wickerwaka/nuBoard/docs/m68000-hardware-2026-09-18.md

# MC68000P12 bring-up, 2026-09-18

The user confirmed that nuBoard was reconnected with the MC68000P12
daughterboard attached. MCU preflight reported selector raw=1 (exclusive 5 V),
VCCB off, and both FPGA rails off. No MCU firmware or fx68k source was changed.
CPU clock for physical tests: 5 MHz, with continuous clock while armed.

## Initial image and gates

Runtime core `nuBoard-68000-v1`, core build 1, mailbox ABI 1.0.
Bitstream SHA-256:
`80b5dc0b1a50b0998bc69e8ea404a60aa7a7c1e0b05145d346246428ca63249d`.
Configuration passed streamed size/SHA-256, CDONE, heartbeat, and identity.

1. FPGA-only test attempt failed in the host transport after TAS passed.
   The MOVEM trace read ended at an exact USB packet boundary; TinyUSB's
   terminating zero-length packet was incorrectly treated as an error by the
   next host read. Shutdown acknowledgement then saw an older queued response.
   The failed receipt remains `build/validation/m68000/board-model-2026-09-18.json`.
   VCCB was never enabled during this attempt. A bounded drain of queued replies
   followed by one explicit POWER_OFF confirmed VCCB and both FPGA rails off.
2. The generic host reader now skips USB zero-length transfer boundaries under
   an absolute read deadline, without retrying commands. Three new tests cover
   exact-size transfers, split frames, and an endless-empty-transfer deadline.
   All 16 host unit tests pass. The repeated FPGA-only TAS/MOVEM/MOVEQ tests
   passed: 68/762/52 transfers, with complete traces exactly matching Verilator.
   Receipt: `build/validation/m68000/board-model-zlp-fixed-2026-09-18.json`.
3. Paired physical MC68000P12/fx68k MOVEQ passed both programs and matched all 52
   functional bus transfers. Timing differs and is not claimed cycle-exact.
   Receipt: `build/validation/m68000/board-paired-moveq-2026-09-18.json`.
4. The next paired batch stopped at TAS before attempting MOVEM. Both CPUs
   reported the test's pass marker, but capture lengths were 68 versus 69.
   The extra socket record was a write to address 0, data 0, FC=0, at timestamp
   zero (end tick 28), before the reset-vector reads. All subsequent 68
   functional records match. This is a **failed capture comparison**, not a
   passing differential test and not evidence of a TAS implementation bug.
   Receipt: `build/validation/m68000/board-paired-bus-2026-09-18.json`.
   VCCB and both FPGA rails were confirmed off afterward.

## Reset-release capture correction

`m68000_lane_tb.sv` holds invalid reset-time strobes low when the lane starts,
with nonzero vector RAM. It failed against build 1: the responder accepted a
transaction and could overwrite the vector. The corrected responder requires
two consecutive synchronized idle samples before acknowledging or capturing
its first transaction. Normal TAS handling is unchanged after qualification.

The new test passes and verifies that vector RAM stays intact and the first
real read is captured exactly once. Logs:

- `build/fpga/m68000/lane-reset-before.log` (failed as expected)
- `build/fpga/m68000/lane-reset-after.log` (pass)
- `build/validation/m68000/reset-qualified-regressions.log` (8 passes)

All 60 Musashi simulator outcomes, counts, signatures, and captured traces are
unchanged (56 passes; ABCD/SBCD/DIVS/DIVU still fail). All 1,000 MOVE.q vectors
pass. Core build 2 identifies the reset-qualification change. Build 1's image
and build receipt are preserved in `build/fpga/m68000/qualified-build1/`.

## Build 2 physical verification

Routed image SHA-256:
`9ae525acd25950172487084f881aac10a394f10015cea398294ddddb053bb574`.
All 153 package assignments and twelve setup/hold relationships pass. At
50 MHz, setup slack is +0.949 ns and hold slack is +0.116 ns. Resource use is
26,199 logic elements and 411/1056 memory blocks. These gates do not qualify
the external socket's electrical timing.

Preflight again confirmed exclusive 5 V selection and all rails off. After
configuration, the MCU reported core build 2 and the expected image digest.
The paired TAS/MOVEM/MOVEQ tests all passed, with respectively 68/762/52
functional transfers matching exactly and complete traces. The false reset
record is absent. All 882 transfers have timing differences; cycle accuracy
is not established. The report records divider=5 and wait_ticks=8.

Receipt:
`build/validation/m68000/board-paired-reset-qualified-2026-09-18.json`.
No transport or cleanup errors occurred, and a separate GET_STATE confirmed
VCCB and both FPGA rails off afterward.

The first 100 decoded SingleStepTests MOVE.q vectors then passed on both lanes:
zero skips, all 12,200 functional bus transfers matching, and all architectural
checks passing independently against the fixture. Checks cover D0..D7,
A0..A6, USP, SSP, SR, PC, and fixture RAM. Final prefetch and source-suite
timing are not checked. Timing differs for all 12,200 captured transfers.

Receipt:
`build/validation/m68000/board-paired-moveq-vectors-2026-09-18.json`.
The decoded vector file SHA-256 is
`39ffa468138c19e7cd02a916a9203c8efd2a323d5b132d1c1101e9fb140e769f`.
The run completed without transport or cleanup errors; VCCB and both FPGA
rails were independently confirmed off afterward.

## Targeted DIVU disagreement

The existing failing Musashi DIVU program was run once in paired mode. Both
CPUs emitted the failure marker: status `0x002a`, model_result=2,
socket_result=2. Neither timed out nor overflowed. Each completed 4,982
transfers, with the same full-run fingerprint (`2727533410`). The first 2,048
captured functional transfers match exactly. Because the test failed, the
runner did not replay additional windows: `trace_complete=false`. Equal
fingerprints do not establish complete trace equality.

Receipt: `build/validation/m68000/board-paired-divu-2026-09-18.json`.
This is a failed test on both implementations, not an fx68k-only failure or a
passing validation result. The cause of the suite disagreement remains open;
the physical terminal flag values were not captured. No further physical
tests were attempted. The run had no transport/cleanup errors, and final
GET_STATE confirmed phase=0, VCCB off, 3.3 V off, and 1.2 V off.

The versionable [hardware receipt](../validation/m68000/hardware-2026-09-18.json)
contains report hashes, build/source provenance, compact outcomes, and the
final power state. Raw trace reports remain under `build/validation/m68000/`.
