wickerwaka/nuBoard/docs/hardware_rev2.md

[x] Replace buffers with non-bushold versions.
[x] Remove small VIAs
[x] Add holes to make it easier to remove daughter boards.
[x] Rotate DC jack
Add regulator?
[x] Hyperram
