wickerwaka/nuBoard/hardware/main-board/notes/pin-assignment.md

# nuBoard T120F484 pin assignment

**Historical assignment:** the PSRAM allocation below was superseded by the
matched [HyperRAM replacement](hyperram.md). Use `../fpga_pin_map.csv`
for current memory and displaced daughter-interface pins. The original routing metrics below do not
describe the HyperRAM replacement.

Generated by `scripts/nuboard_pin_assign.py` from the geometry in
`nuBoard.kicad_pcb` and `t120f484.csv`. Regenerate rather than edit by hand.

## Why these balls

Each signal's destination is taken from the board itself: the
FPGA-side pad of the buffer's 22R series pack for data bits, buffer
pin 2 for `_DIR`, and the pull-up end of the already-routed `_OE`
trace for `_OE`. Balls are then handed to bundles as contiguous arcs
around the die, and matched within each arc in order, so nets leave
the package in the same sequence as their destinations.

Banks that carry LVDS pairs are capped at **14 GPIO** each (Trion rule). On this package those are the top banks
`BANK2A`-`2F` (`GPIOT_*`) and the bottom banks `BANK4A`-`4F`
(`GPIOB_*`); the left and right banks carry no pairs and are
uncapped. The cap counts every GPIO in the bank, so held pins
(configuration, JTAG, the dedicated clock input) come off the
budget before the optimiser sees it.

`BANK3E` (74 balls, the right flank) is excluded: it is the DDR bank
and `VCCIO_DDR` is unconnected, so it cannot be a 3.3 V I/O bank.
R0/R1/R2 are therefore fed from the top-right and bottom-right
corners. Those DDR balls carry no nets and no vias, so the copper
beneath them is an open channel on the inner signal layers.

## Result

| metric | before | after |
|---|---|---|
| crossings between nets outside the package | 303 | 0 |
| ... of those, inside a single bundle | 165 | 0 |
| signals on rings 0-1 | 59 | 94 |
| signals on ring 5 or deeper | 41 | 1 |
| mean ball-to-destination | 26.63 mm | 25.09 mm |
| total | 3860.9 mm | 3637.8 mm |

Ring histogram after: `{"0": 53, "1": 41, "2": 26, "3": 17, "4": 7, "5": 1}`

| bundle | n | mean before | mean after |
|---|---|---|---|
| L0 | 10 | 29.05 mm | 28.95 mm |
| L1 | 10 | 21.79 mm | 20.66 mm |
| L2 | 10 | 23.74 mm | 21.71 mm |
| T2 | 10 | 27.3 mm | 25.07 mm |
| T1 | 10 | 25.26 mm | 22.34 mm |
| T0 | 10 | 32.0 mm | 29.32 mm |
| R2 | 10 | 30.7 mm | 27.8 mm |
| R1 | 10 | 22.35 mm | 18.6 mm |
| R0 | 10 | 28.16 mm | 27.25 mm |
| B2 | 10 | 32.34 mm | 31.26 mm |
| B1 | 10 | 21.65 mm | 20.93 mm |
| B0 | 10 | 21.32 mm | 21.16 mm |
| PSRAM | 6 | 10.57 mm | 10.53 mm |
| XY | 9 | 27.0 mm | 26.61 mm |
| LCLK | 2 | 34.05 mm | 30.8 mm |
| TCLK | 2 | 34.92 mm | 34.63 mm |
| BCLK | 2 | 23.19 mm | 23.15 mm |
| RCLK | 2 | 33.87 mm | 32.09 mm |
| DUT | 2 | 72.87 mm | 71.65 mm |

## Bank occupancy

Cap on LVDS banks: 14 GPIO. `held` are pins this run may not move.

| bank | LVDS | cap | held | assigned | free |
|---|---|---|---|---|---|
| `BANK1A` | — | 9 | 9 | 0 | 0 **(full)** |
| `BANK1B` | — | 12 | 2 | 3 | 7 |
| `BANK1C` | — | 16 | 0 | 10 | 6 |
| `BANK1D` | — | 15 | 0 | 4 | 11 |
| `BANK1E` | — | 3 | 0 | 1 | 2 |
| `BANK1F` | — | 11 | 0 | 6 | 5 |
| `BANK1G` | — | 7 | 4 | 2 | 1 |
| `BANK2A` | yes | 14 | 0 | 14 | 0 **(full)** |
| `BANK2B` | yes | 14 | 0 | 8 | 6 |
| `BANK2C` | yes | 14 | 0 | 5 | 9 |
| `BANK2D` | yes | 12 | 0 | 5 | 7 |
| `BANK2E` | yes | 14 | 0 | 9 | 5 |
| `BANK2F` | yes | 14 | 0 | 7 | 7 |
| `BANK3D` | — | 16 | 1 | 15 | 0 **(full)** |
| `BANK4A` | yes | 8 | 0 | 6 | 2 |
| `BANK4B` | yes | 14 | 0 | 9 | 5 |
| `BANK4C` | yes | 14 | 0 | 8 | 6 |
| `BANK4D` | yes | 10 | 0 | 8 | 2 |
| `BANK4E` | yes | 14 | 0 | 10 | 4 |
| `BANK4F` | yes | 12 | 0 | 12 | 0 **(full)** |
| `BR` | — | 3 | 0 | 0 | 3 |
| `TR` | — | 4 | 1 | 3 | 0 **(full)** |

## Assignment

### L0

| signal | ball | Efinix GPIO | bank | ring | mm | was |
|---|---|---|---|---|---|---|
| `F_L0_DIR` | **E3** | GPIOL_160_PLLIN1 | BANK1G | 2 | 31.1 | E1 |
| `~{F_L0_OE}` | **E4** | GPIOL_164_PLLIN0 | BANK1G | 3 | 28.9 | C2 |
| `F_L07` | **D1** | GPIOT_TXP01 | BANK2A | 0 | 27.8 | C3 |
| `F_L06` | **D2** | GPIOT_TXP02 | BANK2A | 1 | 28.8 | D2 |
| `F_L05` | **C1** | GPIOT_TXP04 | BANK2A | 0 | 28.0 | D1 |
| `F_L04` | **C2** | GPIOT_TXN02 | BANK2A | 1 | 28.9 | B5 |
| `F_L03` | **B1** | GPIOT_TXN04 | BANK2A | 0 | 28.2 | A3 |
| `F_L02` | **B2** | GPIOT_TXN05 | BANK2A | 1 | 29.1 | B2 |
| `F_L01` | **A2** | GPIOT_TXP05 | BANK2A | 0 | 28.8 | B1 |
| `F_L00` | **A3** | GPIOT_TXN06 | BANK2A | 0 | 29.8 | C4 |

### L1

| signal | ball | Efinix GPIO | bank | ring | mm | was |
|---|---|---|---|---|---|---|
| `~{F_L1_OE}` | **L1** | GPIOL_68_CLK2 | BANK1C | 0 | 20.2 | H6 |
| `F_L1_DIR` | **L2** | GPIOL_69_CLK3 | BANK1C | 1 | 23.8 | H4 |
| `F_L17` | **L3** | GPIOL_73_CLK7 | BANK1D | 2 | 21.0 | G5 |
| `F_L16` | **K1** | GPIOL_87 | BANK1D | 0 | 19.4 | G2 |
| `F_L15` | **K2** | GPIOL_89 | BANK1D | 1 | 20.3 | G3 |
| `F_L14` | **J1** | GPIOL_119 | BANK1F | 0 | 19.4 | G4 |
| `F_L13` | **J2** | GPIOL_117 | BANK1E | 1 | 20.3 | G1 |
| `F_L12` | **J3** | GPIOL_91 | BANK1D | 2 | 21.2 | G6 |
| `F_L11` | **H1** | GPIOL_133 | BANK1F | 0 | 19.6 | H1 |
| `F_L10` | **H3** | GPIOL_131 | BANK1F | 2 | 21.3 | H3 |

### L2

| signal | ball | Efinix GPIO | bank | ring | mm | was |
|---|---|---|---|---|---|---|
| `~{F_L2_OE}` | **R3** | GPIOL_17_EXTFB0 | BANK1B | 2 | 23.8 | M1 |
| `F_L2_DIR` | **R2** | GPIOL_15_PLLIN0 | BANK1B | 1 | 25.4 | M4 |
| `F_L27` | **R1** | GPIOL_49 | BANK1C | 0 | 20.5 | L3 |
| `F_L26` | **P3** | GPIOL_51 | BANK1C | 2 | 22.1 | L6 |
| `F_L25` | **P2** | GPIOL_50 | BANK1C | 1 | 21.2 | L5 |
| `F_L24` | **P1** | GPIOL_52 | BANK1C | 0 | 20.3 | L7 |
| `F_L23` | **N2** | GPIOL_63_CTRL1 | BANK1C | 1 | 21.2 | L2 |
| `F_L22` | **N1** | GPIOL_62_CTRL0 | BANK1C | 0 | 20.3 | L1 |
| `F_L21` | **M3** | GPIOL_67_CLK1 | BANK1C | 2 | 21.9 | M3 |
| `F_L20` | **M1** | GPIOL_65_CTRL3 | BANK1C | 0 | 20.2 | M6 |

### T2

| signal | ball | Efinix GPIO | bank | ring | mm | was |
|---|---|---|---|---|---|---|
| `~{F_T2_OE}` | **C3** | GPIOT_TXP03 | BANK2A | 2 | 27.1 | E6 |
| `F_T27` | **C4** | GPIOT_TXN03 | BANK2A | 2 | 25.4 | F6 |
| `F_T26` | **B5** | GPIOT_TXN07 | BANK2A | 1 | 24.8 | C6 |
| `F_T2_DIR` | **A4** | GPIOT_TXP06 | BANK2A | 0 | 28.1 | C7 |
| `F_T25` | **A5** | GPIOT_TXP07 | BANK2A | 0 | 23.9 | A8 |
| `F_T24` | **C6** | GPIOT_TXP10 | BANK2B | 2 | 25.4 | F8 |
| `F_T23` | **B6** | GPIOT_TXN12 | BANK2B | 1 | 24.5 | H7 |
| `F_T22` | **A6** | GPIOT_TXP12 | BANK2B | 0 | 23.5 | B7 |
| `F_T21` | **B7** | GPIOT_TXN14 | BANK2B | 1 | 24.4 | F7 |
| `F_T20` | **A7** | GPIOT_TXP14 | BANK2B | 0 | 23.4 | B6 |

### T1

| signal | ball | Efinix GPIO | bank | ring | mm | was |
|---|---|---|---|---|---|---|
| `~{F_T1_OE}` | **C7** | GPIOT_TXN10 | BANK2B | 2 | 23.7 | D9 |
| `F_T1_DIR` | **A8** | GPIOT_TXN18 | BANK2B | 0 | 24.8 | G8 |
| `F_T17` | **B8** | GPIOT_TXP18 | BANK2B | 1 | 21.9 | G9 |
| `F_T16` | **A9** | GPIOT_TXP23 | BANK2C | 0 | 21.1 | E9 |
| `F_T15` | **B9** | GPIOT_TXN23 | BANK2C | 1 | 21.9 | H8 |
| `F_T14` | **A10** | GPIOT_TXP25 | BANK2C | 0 | 21.1 | G10 |
| `F_T13` | **B10** | GPIOT_TXN25 | BANK2C | 1 | 22.0 | B10 |
| `F_T12` | **D10** | GPIOT_TXP24 | BANK2C | 3 | 23.6 | E10 |
| `F_T11` | **A11** | GPIOT_RXP01 | BANK2D | 0 | 21.2 | B9 |
| `F_T10` | **B11** | GPIOT_RXN01 | BANK2D | 1 | 22.1 | H9 |

### T0

| signal | ball | Efinix GPIO | bank | ring | mm | was |
|---|---|---|---|---|---|---|
| `F_T0_DIR` | **A12** | GPIOT_RXP11 | BANK2E | 0 | 30.4 | B11 |
| `~{F_T0_OE}` | **C12** | GPIOT_RXN04 | BANK2D | 2 | 28.8 | D11 |
| `F_T07` | **A13** | GPIOT_RXN11 | BANK2E | 0 | 27.9 | C11 |
| `F_T06` | **B13** | GPIOT_RXP13 | BANK2E | 1 | 28.9 | G11 |
| `F_T05` | **C13** | GPIOT_RXN13 | BANK2E | 2 | 29.8 | E11 |
| `F_T04` | **A14** | GPIOT_RXN15 | BANK2E | 0 | 28.4 | A11 |
| `F_T03` | **B14** | GPIOT_RXP15 | BANK2E | 1 | 29.4 | E12 |
| `F_T02` | **D14** | GPIOT_RXN19_CLKN1 | BANK2E | 3 | 30.9 | G12 |
| `F_T01` | **A15** | GPIOT_RXN18_EXTFB1 | BANK2E | 0 | 28.9 | C12 |
| `F_T00` | **B15** | GPIOT_RXP18_EXTFB1 | BANK2E | 1 | 29.9 | H11 |

### R2

| signal | ball | Efinix GPIO | bank | ring | mm | was |
|---|---|---|---|---|---|---|
| `~{F_R2_OE}` | **C15** | GPIOT_RXN23 | BANK2F | 2 | 31.8 | G13 |
| `F_R27` | **D15** | GPIOT_RXN22 | BANK2F | 3 | 30.0 | H13 |
| `F_R26` | **A16** | GPIOT_RXP20 | BANK2F | 0 | 27.5 | A12 |
| `F_R25` | **B16** | GPIOT_RXN20 | BANK2F | 1 | 27.6 | D14 |
| `F_R24` | **A17** | GPIOT_RXP21 | BANK2F | 0 | 26.2 | A15 |
| `F_R2_DIR` | **C16** | GPIOT_RXP23 | BANK2F | 2 | 32.8 | A13 |
| `F_R23` | **B17** | GPIOT_RXN21 | BANK2F | 1 | 26.4 | H14 |
| `F_R22` | **C18** | GPIOR_166_PLLIN0 | TR | 2 | 26.0 | A14 |
| `F_R21` | **D18** | GPIOR_168_PLLIN2 | TR | 3 | 26.1 | E13 |
| `F_R20` | **A19** | GPIOR_169_MREFCLK | TR | 0 | 23.7 | C13 |

### R1

| signal | ball | Efinix GPIO | bank | ring | mm | was |
|---|---|---|---|---|---|---|
| `~{F_R1_OE}` | **B19** | GPIOR_172_CTRL13 | BANK3D | 1 | 20.8 | B16 |
| `F_R1_DIR` | **C19** | GPIOR_171_CTRL14 | BANK3D | 2 | 23.5 | B17 |
| `F_R17` | **D19** | GPIOR_173_CTRL12 | BANK3D | 3 | 19.6 | A17 |
| `F_R16` | **B20** | GPIOR_175_CLK14 | BANK3D | 1 | 18.5 | A16 |
| `F_R15` | **A21** | GPIOR_176_CLK13 | BANK3D | 0 | 17.7 | F17 |
| `F_R14` | **B21** | GPIOR_177_CLK12 | BANK3D | 1 | 17.7 | E16 |
| `F_R13` | **B22** | GPIOR_180_CLK9 | BANK3D | 0 | 16.9 | H16 |
| `F_R12` | **C22** | GPIOR_182_CTRL11 | BANK3D | 0 | 16.9 | F15 |
| `F_R11` | **C21** | GPIOR_178_CLK11 | BANK3D | 1 | 17.7 | C15 |
| `F_R10` | **D22** | GPIOR_183_CTRL10 | BANK3D | 0 | 16.9 | D15 |

### R0

| signal | ball | Efinix GPIO | bank | ring | mm | was |
|---|---|---|---|---|---|---|
| `F_R0_DIR` | **V15** | GPIOB_RXP29_CLKP2 | BANK4A | 4 | 29.1 | AA13 |
| `~{F_R0_OE}` | **W15** | GPIOB_RXN29_CLKN2 | BANK4A | 3 | 25.9 | U13 |
| `F_R07` | **AA15** | GPIOB_RXN20 | BANK4A | 1 | 25.4 | AB15 |
| `F_R06` | **AB15** | GPIOB_RXP14 | BANK4B | 0 | 25.3 | T13 |
| `F_R05` | **U14** | GPIOB_RXN18_EXTFB1 | BANK4B | 5 | 28.1 | AB13 |
| `F_R04` | **V14** | GPIOB_RXP19_CLKP1 | BANK4B | 4 | 28.0 | W14 |
| `F_R03` | **W14** | GPIOB_RXN19_CLKN1 | BANK4B | 3 | 27.8 | U14 |
| `F_R02` | **Y14** | GPIOB_RXP16 | BANK4B | 2 | 27.7 | Y13 |
| `F_R01` | **AB14** | GPIOB_RXN14 | BANK4B | 0 | 27.1 | R13 |
| `F_R00` | **AB13** | GPIOB_RXP10 | BANK4B | 0 | 28.1 | AB14 |

### B2

| signal | ball | Efinix GPIO | bank | ring | mm | was |
|---|---|---|---|---|---|---|
| `~{F_B2_OE}` | **Y13** | GPIOB_RXN16 | BANK4B | 2 | 33.1 | U10 |
| `F_B27` | **AA13** | GPIOB_RXN10 | BANK4B | 1 | 30.0 | AB10 |
| `F_B26` | **V12** | GPIOB_RXP08_EXTFB0 | BANK4C | 4 | 31.7 | W10 |
| `F_B25` | **W12** | GPIOB_RXN08_EXTFB0 | BANK4C | 3 | 30.8 | AB9 |
| `F_B24` | **AA12** | GPIOB_RXP05 | BANK4C | 1 | 29.4 | U9 |
| `F_B2_DIR` | **W11** | GPIOB_RXP03 | BANK4C | 3 | 35.9 | AA8 |
| `F_B23` | **AB12** | GPIOB_RXN05 | BANK4C | 0 | 28.5 | AB8 |
| `F_B22` | **R4** | GPIOL_19_PLLIN1 | BANK1B | 3 | 36.6 | AA10 |
| `F_B21` | **AA11** | GPIOB_RXN00 | BANK4C | 1 | 28.8 | V10 |
| `F_B20` | **AB11** | GPIOB_RXP00 | BANK4C | 0 | 27.9 | AA9 |

### B1

| signal | ball | Efinix GPIO | bank | ring | mm | was |
|---|---|---|---|---|---|---|
| `~{F_B1_OE}` | **V8** | GPIOB_TXN17_CDI10 | BANK4E | 4 | 24.2 | AA6 |
| `F_B1_DIR` | **V7** | GPIOB_TXP15_CDI15 | BANK4E | 4 | 26.6 | Y7 |
| `F_B17` | **W8** | GPIOB_TXP17_CDI11 | BANK4E | 3 | 21.5 | V7 |
| `F_B16` | **AA8** | GPIOB_TXN22 | BANK4D | 1 | 19.8 | AB6 |
| `F_B15` | **Y7** | GPIOB_TXN13_CDI18 | BANK4E | 2 | 20.6 | Y6 |
| `F_B14` | **AA7** | GPIOB_TXN16_CDI12 | BANK4E | 1 | 19.7 | W9 |
| `F_B13` | **AB7** | GPIOB_TXP16_CDI13 | BANK4E | 0 | 18.7 | U8 |
| `F_B12` | **Y6** | GPIOB_TXP13_CDI19 | BANK4E | 2 | 20.3 | V8 |
| `F_B11` | **AA6** | GPIOB_TXN14_CDI16 | BANK4E | 1 | 19.4 | AA7 |
| `F_B10` | **AB6** | GPIOB_TXP14_CDI17 | BANK4E | 0 | 18.4 | U7 |

### B0

| signal | ball | Efinix GPIO | bank | ring | mm | was |
|---|---|---|---|---|---|---|
| `F_B0_DIR` | **Y4** | GPIOB_TXP03_CDI31 | BANK4F | 2 | 23.8 | W4 |
| `~{F_B0_OE}` | **AB4** | GPIOB_TXN07_CDI22 | BANK4F | 0 | 19.4 | W3 |
| `F_B07` | **W4** | GPIOB_TXN03_CDI30 | BANK4F | 3 | 21.8 | AB2 |
| `F_B06` | **AB3** | GPIOB_TXP07_CDI23 | BANK4F | 0 | 19.6 | AA1 |
| `F_B05` | **AB2** | GPIOB_TXP06_CDI25 | BANK4F | 0 | 19.4 | W2 |
| `F_B04` | **AA2** | GPIOB_TXN06_CDI24 | BANK4F | 1 | 20.4 | Y4 |
| `F_B03` | **AA1** | GPIOB_TXP05_CDI27 | BANK4F | 0 | 20.2 | AB5 |
| `F_B02` | **Y1** | GPIOB_TXN05_CDI26 | BANK4F | 0 | 21.2 | AB4 |
| `F_B01` | **W3** | GPIOB_TXN04_CDI28 | BANK4F | 2 | 22.9 | AA2 |
| `F_B00` | **W2** | GPIOB_TXP04_CDI29 | BANK4F | 1 | 22.8 | Y1 |

### PSRAM

| signal | ball | Efinix GPIO | bank | ring | mm | was |
|---|---|---|---|---|---|---|
| `PSRAM_SI` | **E22** | GPIOR_185_CTRL8 | BANK3D | 0 | 11.2 | AB17 |
| `PSRAM_SCLK` | **E21** | GPIOR_181_CLK8 | BANK3D | 1 | 11.4 | R15 |
| `PSRAM_SIO3` | **E19** | GPIOR_170_CTRL15 | BANK3D | 3 | 12.0 | T15 |
| `PSRAM_SIO2` | **AB17** | GPIOB_RXN28_EXTFB2 | BANK4A | 0 | 9.5 | AA16 |
| `PSRAM_SO` | **AB16** | GPIOB_RXP28_EXTFB2 | BANK4A | 0 | 9.8 | W15 |
| `~{PSRAM_CE}` | **AA16** | GPIOB_RXP20 | BANK4A | 1 | 9.3 | AA15 |

### XY

| signal | ball | Efinix GPIO | bank | ring | mm | was |
|---|---|---|---|---|---|---|
| `F_RX` | **V11** | GPIOB_RXN03 | BANK4C | 4 | 29.4 | R10 |
| `F_RY` | **V10** | GPIOB_TXN25 | BANK4D | 4 | 29.1 | V11 |
| `F_TX` | **W10** | GPIOB_TXP25 | BANK4D | 3 | 28.1 | AB12 |
| `F_TY` | **AA10** | GPIOB_TXN26 | BANK4D | 1 | 26.4 | U12 |
| `F_BX` | **AB10** | GPIOB_TXP26 | BANK4D | 0 | 25.4 | W12 |
| `F_BY` | **W9** | GPIOB_TXN19 | BANK4E | 3 | 27.4 | T12 |
| `F_LX` | **AA9** | GPIOB_TXN24 | BANK4D | 1 | 25.7 | AB11 |
| `~{F_XY_OE}` | **AB9** | GPIOB_TXP24 | BANK4D | 0 | 22.9 | AA11 |
| `F_LY` | **AB8** | GPIOB_TXP22 | BANK4D | 0 | 25.2 | T10 |

### LCLK

| signal | ball | Efinix GPIO | bank | ring | mm | was |
|---|---|---|---|---|---|---|
| `F_LCLK_EN` | **G1** | GPIOL_136 | BANK1F | 0 | 31.0 | J8 |
| `F_LCLK` | **G2** | GPIOL_142 | BANK1F | 1 | 30.6 | J2 |

### TCLK

| signal | ball | Efinix GPIO | bank | ring | mm | was |
|---|---|---|---|---|---|---|
| `F_TCLK_EN` | **C11** | GPIOT_RXP04 | BANK2D | 2 | 34.8 | A10 |
| `F_TCLK` | **D11** | GPIOT_RXN02 | BANK2D | 3 | 34.4 | F10 |

### BCLK

| signal | ball | Efinix GPIO | bank | ring | mm | was |
|---|---|---|---|---|---|---|
| `F_BCLK_EN` | **AB5** | GPIOB_TXN08_CDI20 | BANK4F | 0 | 23.5 | AB3 |
| `F_BCLK` | **AA5** | GPIOB_TXP08_CDI21 | BANK4F | 1 | 22.8 | AA5 |

### RCLK

| signal | ball | Efinix GPIO | bank | ring | mm | was |
|---|---|---|---|---|---|---|
| `R_RCLK_EN` | **D21** | GPIOR_184_CTRL9 | BANK3D | 1 | 32.2 | F16 |
| `F_RCLK` | **D20** | GPIOR_179_CLK10 | BANK3D | 2 | 32.0 | G17 |

### DUT

| signal | ball | Efinix GPIO | bank | ring | mm | was |
|---|---|---|---|---|---|---|
| `DUT_ISOLATE` | **G3** | GPIOL_141 | BANK1F | 2 | 72.4 | E4 |
| `DUT_CROWBAR` | **E1** | GPIOT_TXN01 | BANK2A | 0 | 70.9 | E5 |

## Downstream

`nuBoard/fpga_pin_map.csv` carries the same table as
`Signal,GPIO,Ball,Bank,Group` for the Efinity flow. Note that
`scripts/gen_isf.py` currently targets **T20F256** (the T20_Rig
board) and does not read this file; pointing it at T120F484 is a
separate job.
