wickerwaka/nuBoard/hardware/daughter-template/meta/info.html

# nuDaughter Mezzanine Board

Starting point for a daughterboard that plugs into the nuBoard 68020 FPGA host board. It gives you a 100 × 100 mm outline and the full 4 × 34 mezzanine interface, already placed, footprinted and labelled. Everything inside the connector ring is yours.

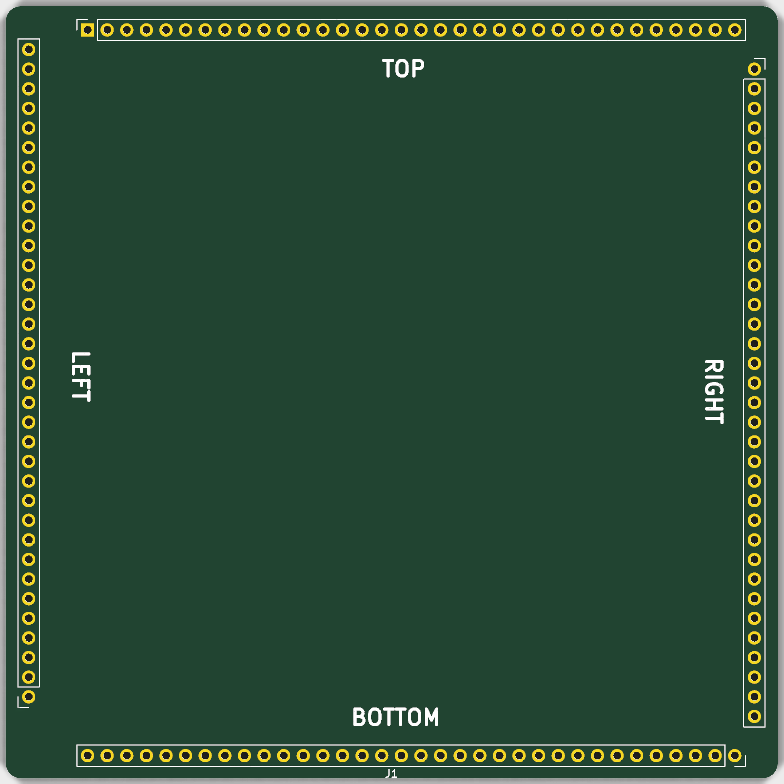
[picture p1: hardware/v35s/meta/brd.png]


### What's in the template

- J1 — nuMezzanine_4x34, a 5-unit symbol covering all 136 through-hole pins, mapped to the nuMezzanine_4x34_P2.54mm footprint (2.54 mm pitch, pins numbered 1–136 clockwise from the top-left).
- Board outline on Edge.Cuts, and TOP / BOTTOM / LEFT / RIGHT silkscreen so the board orientation is unambiguous when it is mated to the host.
- All 116 signal pins broken out to net labels in the schematic, ready to wire.
- A 2-layer FR4 stackup and the net class / DRC settings used by the nuBoard family.

### Pin naming

Each of the four connector rows carries 34 pins: 29 signals, three grounds, a supply pin, and an end pin used for voltage selection or ground. Signal labels are <side><bank><bit>, where side is T, B, L or R — for example T00…T07, T10…T17, T20…T27. Each side also has a dedicated clock TCLK/BCLK/LCLK/RCLK and four bidirectional sideband signals TX0–TX3 (and the equivalents on the other sides).

### Standalone

The mezzanine symbol and footprint ship with the template as a project-local nuBoard library (nuBoard.kicad_sym and nuBoard.pretty, registered through the project's own sym-lib-table and fp-lib-table via ${KIPRJMOD}). Nothing outside the new project directory is required.

### Expect ERC violations until you wire something up

Out of the box the schematic reports isolated pin label for every mezzanine signal, because each label reaches only J1 so far. Those clear as you connect the signals you actually use; delete the labels you don't.
