wickerwaka/nuBoard/hardware/68030/meta/info.html

# Motorola MC68030RC25B

CPGA128, 5 V, fully routed two-layer nuBoard daughter board. Supports 8/16/32-bit ports, burst reads and bus takeover.

Open 68030.kicad_pro. Read design-notes.md and bank-modes.md before use. Direct TTL/CMOS and bus-keeper margins are not guaranteed; physical bench and timing qualification remain pending.
