wickerwaka/nuBoard/hardware/main-board/t120f484.csv

Bank Number | Pin Names | Configuration Functions | DDR Interface | LVDS TX/RX Pairs | DDIO | Clock Region | FBGA484
BANK1A | CDONE | CDONE |  |  |  |  | V5
BANK1A | CRESET_N | CRESET_N |  |  |  |  | V4
BANK1A | GPIOL_00_SS_N | SS_N |  |  | Yes | L0 | V3
BANK1A | GPIOL_01_CCK | CCK |  |  | Yes | L0 | W1
BANK1A | GPIOL_04_CSI | CSI |  |  | Yes | L0 | V6
BANK1A | GPIOL_05_CSO | CSO |  |  | Yes | L0 | U5
BANK1A | GPIOL_08_CDI0 | CDI0 |  |  | Yes | L0 | V2
BANK1A | GPIOL_09_CDI1 | CDI1 |  |  | Yes | L0 | V1
BANK1A | GPIOL_11_CBUS0 | CBUS0 |  |  | Yes | L0 | U4
BANK1A | GPIOL_12_CBUS1 | CBUS1 |  |  | Yes | L0, L1 | U6
BANK1A | GPIOL_13_CBUS2 | CBUS2 |  |  | Yes | L1 | T4
BANK1A | TCK | TCK |  |  |  |  | T1
BANK1A | TDI | TDI |  |  |  |  | U2
BANK1A | TDO | TDO |  |  |  |  | T3
BANK1A | TMS | TMS |  |  |  |  | U1
BANK1B | GPIOL_14_CDI2 | CDI2 |  |  | Yes | L1 | T6
BANK1B | GPIOL_15_PLLIN0 |  |  |  | Yes | L1 | R2
BANK1B | GPIOL_16_CDI3 | CDI3 |  |  | Yes | L1 | R8
BANK1B | GPIOL_17_EXTFB0 |  |  |  | Yes | L1 | R3
BANK1B | GPIOL_18_CDI4 | CDI4 |  |  | Yes | L1 | R7
BANK1B | GPIOL_19_PLLIN1 |  |  |  | Yes | L1 | R4
BANK1B | GPIOL_20_CDI5 | CDI5 |  |  | Yes | L1 | R6
BANK1B | GPIOL_22_CDI6 | CDI6 |  |  | Yes | L1 | P8
BANK1B | GPIOL_24_CDI7 | CDI7 |  |  | Yes | L1 | P7
BANK1B | GPIOL_36 |  |  |  | Yes | L2 | P4
BANK1B | GPIOL_40 |  |  |  | Yes | L2 | N7
BANK1B | GPIOL_45 |  |  |  | Yes | L2 | P6
BANK1C | GPIOL_47 |  |  |  | Yes | L2 | P5
BANK1C | GPIOL_49 |  |  |  | Yes | L2 | R1
BANK1C | GPIOL_50 |  |  |  | Yes | L2 | P2
BANK1C | GPIOL_51 |  |  |  | Yes | L2 | P3
BANK1C | GPIOL_52 |  |  |  | Yes | L2 | P1
BANK1C | GPIOL_53 |  |  |  | Yes | L2 | N5
BANK1C | GPIOL_56 |  |  |  | Yes | L3 | N4
BANK1C | GPIOL_58 |  |  |  | Yes | L3 | M7
BANK1C | GPIOL_62_CTRL0 |  |  |  | Yes | L3 | N1
BANK1C | GPIOL_63_CTRL1 |  |  |  | Yes | L3 | N2
BANK1C | GPIOL_64_CTRL2 |  |  |  | Yes | L3 | M4
BANK1C | GPIOL_65_CTRL3 |  |  |  | Yes | L3 | M1
BANK1C | GPIOL_66_CLK0 |  |  |  | Yes | L3 | M6
BANK1C | GPIOL_67_CLK1 |  |  |  | Yes | L3 | M3
BANK1C | GPIOL_68_CLK2 |  |  |  | Yes | L3 | L1
BANK1C | GPIOL_69_CLK3 |  |  |  | Yes | L3 | L2
BANK1D | GPIOL_70_CLK4 |  |  |  | Yes | L3 | L7
BANK1D | GPIOL_71_CLK5 |  |  |  | Yes | L3 | L5
BANK1D | GPIOL_72_CLK6 |  |  |  | Yes | L3 | L6
BANK1D | GPIOL_73_CLK7 |  |  |  | Yes | L3 | L3
BANK1D | GPIOL_74_CTRL4 |  |  |  | Yes | L3 | L4
BANK1D | GPIOL_75_CTRL5 |  |  |  | Yes | L3 | K8
BANK1D | GPIOL_76_CTRL6 |  |  |  | Yes | L3 | K7
BANK1D | GPIOL_77_CTRL7 |  |  |  | Yes | L4 | K6
BANK1D | GPIOL_79 |  |  |  | Yes | L4 | K4
BANK1D | GPIOL_81 |  |  |  | Yes | L4 | K5
BANK1D | GPIOL_85 |  |  |  | Yes | L4 | J5
BANK1D | GPIOL_87 |  |  |  | Yes | L4 | K1
BANK1D | GPIOL_88 |  |  |  | Yes | L4 | J4
BANK1D | GPIOL_89 |  |  |  | Yes | L4 | K2
BANK1D | GPIOL_91 |  |  |  | Yes | L4 | J3
BANK1E | GPIOL_115 |  |  |  | Yes | L5 | J7
BANK1E | GPIOL_116 |  |  |  | Yes | L5 | J8
BANK1E | GPIOL_117 |  |  |  | Yes | L5 | J2
BANK1F | GPIOL_119 |  |  |  | Yes | L5 | J1
BANK1F | GPIOL_121 |  |  |  | Yes | L6 | H4
BANK1F | GPIOL_123 |  |  |  | Yes | L6 | H6
BANK1F | GPIOL_131 |  |  |  | Yes | L6 | H3
BANK1F | GPIOL_133 |  |  |  | Yes | L6 | H1
BANK1F | GPIOL_134 |  |  |  | Yes | L6 | G6
BANK1F | GPIOL_136 |  |  |  | Yes | L6 | G1
BANK1F | GPIOL_138 |  |  |  | Yes | L6 | G4
BANK1F | GPIOL_141 |  |  |  | Yes | L6 | G3
BANK1F | GPIOL_142 |  |  |  | Yes | L6 | G2
BANK1F | GPIOL_147 |  |  |  | Yes | L7 | G5
BANK1G | GPIOL_150_NSTATUS | NSTATUS |  |  | Yes | L7 | F5
BANK1G | GPIOL_151_TEST_N | TEST_N |  |  | Yes | L7 | F1
BANK1G | GPIOL_156_CBSEL0 | CBSEL0 |  |  | Yes | L7 | F4
BANK1G | GPIOL_157_CBSEL1 | CBSEL1 |  |  | Yes | L7 | E2
BANK1G | GPIOL_160_PLLIN1 |  |  |  | Yes | L7 | E3
BANK1G | GPIOL_162_EXTFB |  |  |  | Yes | L7 | E5
BANK1G | GPIOL_164_PLLIN0 |  |  |  | Yes | L7 | E4
BANK2A | GPIOT_TXN01 |  |  | GPIOT_TX01 |  | T | E1
BANK2A | GPIOT_TXN02 |  |  | GPIOT_TX02 |  | T | C2
BANK2A | GPIOT_TXN03 |  |  | GPIOT_TX03 |  | T | C4
BANK2A | GPIOT_TXN04 |  |  | GPIOT_TX04 |  | T | B1
BANK2A | GPIOT_TXN05 |  |  | GPIOT_TX05 |  | T | B2
BANK2A | GPIOT_TXN06 |  |  | GPIOT_TX06 |  | T | A3
BANK2A | GPIOT_TXN07 |  |  | GPIOT_TX07 |  | T | B5
BANK2A | GPIOT_TXP01 |  |  | GPIOT_TX01 |  | T | D1
BANK2A | GPIOT_TXP02 |  |  | GPIOT_TX02 |  | T | D2
BANK2A | GPIOT_TXP03 |  |  | GPIOT_TX03 |  | T | C3
BANK2A | GPIOT_TXP04 |  |  | GPIOT_TX04 |  | T | C1
BANK2A | GPIOT_TXP05 |  |  | GPIOT_TX05 |  | T | A2
BANK2A | GPIOT_TXP06 |  |  | GPIOT_TX06 |  | T | A4
BANK2A | GPIOT_TXP07 |  |  | GPIOT_TX07 |  | T | A5
BANK2A | REF_RES_2A |  |  |  |  |  | C5
BANK2B | GPIOT_TXN10 |  |  | GPIOT_TX10 |  | T | C7
BANK2B | GPIOT_TXN11 |  |  | GPIOT_TX11 |  | T | E6
BANK2B | GPIOT_TXN12 |  |  | GPIOT_TX12 |  | T | B6
BANK2B | GPIOT_TXN13 |  |  | GPIOT_TX13 |  | T | F7
BANK2B | GPIOT_TXN14 |  |  | GPIOT_TX14 |  | T | B7
BANK2B | GPIOT_TXN15 |  |  | GPIOT_TX15 |  | T | H7
BANK2B | GPIOT_TXN16 |  |  | GPIOT_TX16 |  | T | F8
BANK2B | GPIOT_TXN18 |  |  | GPIOT_TX18 |  | T | A8
BANK2B | GPIOT_TXP10 |  |  | GPIOT_TX10 |  | T | C6
BANK2B | GPIOT_TXP11 |  |  | GPIOT_TX11 |  | T | F6
BANK2B | GPIOT_TXP12 |  |  | GPIOT_TX12 |  | T | A6
BANK2B | GPIOT_TXP13 |  |  | GPIOT_TX13 |  | T | E7
BANK2B | GPIOT_TXP14 |  |  | GPIOT_TX14 |  | T | A7
BANK2B | GPIOT_TXP15 |  |  | GPIOT_TX15 |  | T | G7
BANK2B | GPIOT_TXP16 |  |  | GPIOT_TX16 |  | T | E8
BANK2B | GPIOT_TXP18 |  |  | GPIOT_TX18 |  | T | B8
BANK2B | REF_RES_2B |  |  |  |  |  | D8
BANK2C | GPIOT_TXN20 |  |  | GPIOT_TX20 |  | T | G8
BANK2C | GPIOT_TXN21 |  |  | GPIOT_TX21 |  | T | D9
BANK2C | GPIOT_TXN22 |  |  | GPIOT_TX22 |  | T | H9
BANK2C | GPIOT_TXN23 |  |  | GPIOT_TX23 |  | T | B9
BANK2C | GPIOT_TXN24 |  |  | GPIOT_TX24 |  | T | E10
BANK2C | GPIOT_TXN25 |  |  | GPIOT_TX25 |  | T | B10
BANK2C | GPIOT_TXN26 |  |  | GPIOT_TX26 |  | T | G10
BANK2C | GPIOT_TXP20 |  |  | GPIOT_TX20 |  | T | H8
BANK2C | GPIOT_TXP21 |  |  | GPIOT_TX21 |  | T | E9
BANK2C | GPIOT_TXP22 |  |  | GPIOT_TX22 |  | T | G9
BANK2C | GPIOT_TXP23 |  |  | GPIOT_TX23 |  | T | A9
BANK2C | GPIOT_TXP24 |  |  | GPIOT_TX24 |  | T | D10
BANK2C | GPIOT_TXP25 |  |  | GPIOT_TX25 |  | T | A10
BANK2C | GPIOT_TXP26 |  |  | GPIOT_TX26 |  | T | F10
BANK2C | REF_RES_2C |  |  |  |  |  | C10
BANK2D | GPIOT_RXN01 |  |  | GPIOT_RX01 |  | T | B11
BANK2D | GPIOT_RXN02 |  |  | GPIOT_RX02 |  | T | D11
BANK2D | GPIOT_RXN03 |  |  | GPIOT_RX03 |  | T | H11
BANK2D | GPIOT_RXN04 |  |  | GPIOT_RX04 |  | T | C12
BANK2D | GPIOT_RXN08_EXTFB0 |  |  | GPIOT_RX08 |  | T | G12
BANK2D | GPIOT_RXN09_CLKN0 |  |  | GPIOT_RX09 |  | T | E12
BANK2D | GPIOT_RXP01 |  |  | GPIOT_RX01 |  | T | A11
BANK2D | GPIOT_RXP02 |  |  | GPIOT_RX02 |  | T | E11
BANK2D | GPIOT_RXP03 |  |  | GPIOT_RX03 |  | T | G11
BANK2D | GPIOT_RXP04 |  |  | GPIOT_RX04 |  | T | C11
BANK2D | GPIOT_RXP08_EXTFB0 |  |  | GPIOT_RX08 |  | T | H12
BANK2D | GPIOT_RXP09_CLKP0 |  |  | GPIOT_RX09 |  | T | F12
BANK2E | GPIOT_RXN11 |  |  | GPIOT_RX11 |  | T | A13
BANK2E | GPIOT_RXN12 |  |  | GPIOT_RX12 |  | T | G13
BANK2E | GPIOT_RXN13 |  |  | GPIOT_RX13 |  | T | C13
BANK2E | GPIOT_RXN14 |  |  | GPIOT_RX14 |  | T | E13
BANK2E | GPIOT_RXN15 |  |  | GPIOT_RX15 |  | T | A14
BANK2E | GPIOT_RXN16 |  |  | GPIOT_RX16 |  | T | H14
BANK2E | GPIOT_RXN18_EXTFB1 |  |  | GPIOT_RX18 |  | T | A15
BANK2E | GPIOT_RXN19_CLKN1 |  |  | GPIOT_RX19 |  | T | D14
BANK2E | GPIOT_RXP11 |  |  | GPIOT_RX11 |  | T | A12
BANK2E | GPIOT_RXP12 |  |  | GPIOT_RX12 |  | T | H13
BANK2E | GPIOT_RXP13 |  |  | GPIOT_RX13 |  | T | B13
BANK2E | GPIOT_RXP14 |  |  | GPIOT_RX14 |  | T | F13
BANK2E | GPIOT_RXP15 |  |  | GPIOT_RX15 |  | T | B14
BANK2E | GPIOT_RXP16 |  |  | GPIOT_RX16 |  | T | G14
BANK2E | GPIOT_RXP18_EXTFB1 |  |  | GPIOT_RX18 |  | T | B15
BANK2E | GPIOT_RXP19_CLKP1 |  |  | GPIOT_RX19 |  | T | E14
BANK2F | GPIOT_RXN20 |  |  | GPIOT_RX20 |  | T | B16
BANK2F | GPIOT_RXN21 |  |  | GPIOT_RX21 |  | T | B17
BANK2F | GPIOT_RXN22 |  |  | GPIOT_RX22 |  | T | D15
BANK2F | GPIOT_RXN23 |  |  | GPIOT_RX23 |  | T | C15
BANK2F | GPIOT_RXN24 |  |  | GPIOT_RX24 |  | T | F15
BANK2F | GPIOT_RXN27 |  |  | GPIOT_RX27 |  | T | H16
BANK2F | GPIOT_RXN28_EXTFB2 |  |  | GPIOT_RX28 |  | T | E16
BANK2F | GPIOT_RXN29_CLKN2 |  |  | GPIOT_RX29 |  | T | F17
BANK2F | GPIOT_RXP20 |  |  | GPIOT_RX20 |  | T | A16
BANK2F | GPIOT_RXP21 |  |  | GPIOT_RX21 |  | T | A17
BANK2F | GPIOT_RXP22 |  |  | GPIOT_RX22 |  | T | E15
BANK2F | GPIOT_RXP23 |  |  | GPIOT_RX23 |  | T | C16
BANK2F | GPIOT_RXP24 |  |  | GPIOT_RX24 |  | T | G15
BANK2F | GPIOT_RXP27 |  |  | GPIOT_RX27 |  | T | J16
BANK2F | GPIOT_RXP28_EXTFB2 |  |  | GPIOT_RX28 |  | T | F16
BANK2F | GPIOT_RXP29_CLKP2 |  |  | GPIOT_RX29 |  | T | G17
BANK3D | GPIOR_170_CTRL15 |  |  |  | Yes | R4 | E19
BANK3D | GPIOR_171_CTRL14 |  |  |  | Yes | R4 | C19
BANK3D | GPIOR_172_CTRL13 |  |  |  | Yes | R4 | B19
BANK3D | GPIOR_173_CTRL12 |  |  |  | Yes | R4 | D19
BANK3D | GPIOR_174_CLK15 |  |  |  | Yes | R4 | A20
BANK3D | GPIOR_175_CLK14 |  |  |  | Yes | R4 | B20
BANK3D | GPIOR_176_CLK13 |  |  |  | Yes | R4 | A21
BANK3D | GPIOR_177_CLK12 |  |  |  | Yes | R4 | B21
BANK3D | GPIOR_178_CLK11 |  |  |  | Yes | R4 | C21
BANK3D | GPIOR_179_CLK10 |  |  |  | Yes | R4 | D20
BANK3D | GPIOR_180_CLK9 |  |  |  | Yes | R4 | B22
BANK3D | GPIOR_181_CLK8 |  |  |  | Yes | R4 | E21
BANK3D | GPIOR_182_CTRL11 |  |  |  | Yes | R4 | C22
BANK3D | GPIOR_183_CTRL10 |  |  |  | Yes | R4 | D22
BANK3D | GPIOR_184_CTRL9 |  |  |  | Yes | R4 | D21
BANK3D | GPIOR_185_CTRL8 |  |  |  | Yes | R4 | E22
BANK3E | DDR_A[0] |  | DDR_A[0] |  |  |  | M18
BANK3E | DDR_A[1] |  | DDR_A[1] |  |  |  | L17
BANK3E | DDR_A[10] |  | DDR_A[10] |  |  |  | P22
BANK3E | DDR_A[11] |  | DDR_A[11] |  |  |  | R22
BANK3E | DDR_A[12] |  | DDR_A[12] |  |  |  | T20
BANK3E | DDR_A[13] |  | DDR_A[13] |  |  |  | T21
BANK3E | DDR_A[14] |  | DDR_A[14] |  |  |  | R18
BANK3E | DDR_A[15] |  | DDR_A[15] |  |  |  | U17
BANK3E | DDR_A[2] |  | DDR_A[2] |  |  |  | N17
BANK3E | DDR_A[3] |  | DDR_A[3] |  |  |  | P20
BANK3E | DDR_A[4] |  | DDR_A[4] |  |  |  | N19
BANK3E | DDR_A[5] |  | DDR_A[5] |  |  |  | T19
BANK3E | DDR_A[6] |  | DDR_A[6] |  |  |  | M20
BANK3E | DDR_A[7] |  | DDR_A[7] |  |  |  | P17
BANK3E | DDR_A[8] |  | DDR_A[8] |  |  |  | P19
BANK3E | DDR_A[9] |  | DDR_A[9] |  |  |  | R20
BANK3E | DDR_BA[0] |  | DDR_BA[0] |  |  |  | V16
BANK3E | DDR_BA[1] |  | DDR_BA[1] |  |  |  | T17
BANK3E | DDR_BA[2] |  | DDR_BA[2] |  |  |  | W16
BANK3E | DDR_CAS_N |  | DDR_CAS_N |  |  |  | M16
BANK3E | DDR_CK |  | DDR_CK |  |  |  | N21
BANK3E | DDR_CK_N |  | DDR_CK_N |  |  |  | P21
BANK3E | DDR_CKE |  | DDR_CKE |  |  |  | L16
BANK3E | DDR_CS_N |  | DDR_CS_N |  |  |  | P16
BANK3E | DDR_DM[0] |  | DDR_DM[0] |  |  |  | K19
BANK3E | DDR_DM[1] |  | DDR_DM[1] |  |  |  | G22
BANK3E | DDR_DM[2] |  | DDR_DM[2] |  |  |  | V20
BANK3E | DDR_DM[3] |  | DDR_DM[3] |  |  |  | Y19
BANK3E | DDR_DQ[0] |  | DDR_DQ[0] |  |  |  | K21
BANK3E | DDR_DQ[1] |  | DDR_DQ[1] |  |  |  | M22
BANK3E | DDR_DQ[10] |  | DDR_DQ[10] |  |  |  | H20
BANK3E | DDR_DQ[11] |  | DDR_DQ[11] |  |  |  | H19
BANK3E | DDR_DQ[12] |  | DDR_DQ[12] |  |  |  | G19
BANK3E | DDR_DQ[13] |  | DDR_DQ[13] |  |  |  | H21
BANK3E | DDR_DQ[14] |  | DDR_DQ[14] |  |  |  | F20
BANK3E | DDR_DQ[15] |  | DDR_DQ[15] |  |  |  | F18
BANK3E | DDR_DQ[16] |  | DDR_DQ[16] |  |  |  | U19
BANK3E | DDR_DQ[17] |  | DDR_DQ[17] |  |  |  | T22
BANK3E | DDR_DQ[18] |  | DDR_DQ[18] |  |  |  | W21
BANK3E | DDR_DQ[19] |  | DDR_DQ[19] |  |  |  | U21
BANK3E | DDR_DQ[2] |  | DDR_DQ[2] |  |  |  | K20
BANK3E | DDR_DQ[20] |  | DDR_DQ[20] |  |  |  | U18
BANK3E | DDR_DQ[21] |  | DDR_DQ[21] |  |  |  | W20
BANK3E | DDR_DQ[22] |  | DDR_DQ[22] |  |  |  | W19
BANK3E | DDR_DQ[23] |  | DDR_DQ[23] |  |  |  | V18
BANK3E | DDR_DQ[24] |  | DDR_DQ[24] |  |  |  | Y21
BANK3E | DDR_DQ[25] |  | DDR_DQ[25] |  |  |  | Y22
BANK3E | DDR_DQ[26] |  | DDR_DQ[26] |  |  |  | AA20
BANK3E | DDR_DQ[27] |  | DDR_DQ[27] |  |  |  | AA22
BANK3E | DDR_DQ[28] |  | DDR_DQ[28] |  |  |  | AB19
BANK3E | DDR_DQ[29] |  | DDR_DQ[29] |  |  |  | Y18
BANK3E | DDR_DQ[3] |  | DDR_DQ[3] |  |  |  | L20
BANK3E | DDR_DQ[30] |  | DDR_DQ[30] |  |  |  | AB18
BANK3E | DDR_DQ[31] |  | DDR_DQ[31] |  |  |  | AA18
BANK3E | DDR_DQ[4] |  | DDR_DQ[4] |  |  |  | L19
BANK3E | DDR_DQ[5] |  | DDR_DQ[5] |  |  |  | J18
BANK3E | DDR_DQ[6] |  | DDR_DQ[6] |  |  |  | L18
BANK3E | DDR_DQ[7] |  | DDR_DQ[7] |  |  |  | H18
BANK3E | DDR_DQ[8] |  | DDR_DQ[8] |  |  |  | J22
BANK3E | DDR_DQ[9] |  | DDR_DQ[9] |  |  |  | K22
BANK3E | DDR_DQS[0] |  | DDR_DQS[0] |  |  |  | L21
BANK3E | DDR_DQS[1] |  | DDR_DQS[1] |  |  |  | G20
BANK3E | DDR_DQS[2] |  | DDR_DQS[2] |  |  |  | V22
BANK3E | DDR_DQS[3] |  | DDR_DQS[3] |  |  |  | AB21
BANK3E | DDR_DQS_N[0] |  | DDR_DQS_N[0] |  |  |  | L22
BANK3E | DDR_DQS_N[1] |  | DDR_DQS_N[1] |  |  |  | G21
BANK3E | DDR_DQS_N[2] |  | DDR_DQS_N[2] |  |  |  | W22
BANK3E | DDR_DQS_N[3] |  | DDR_DQS_N[3] |  |  |  | AB20
BANK3E | DDR_ODT |  | DDR_ODT |  |  |  | W17
BANK3E | DDR_RAS_N |  | DDR_RAS_N |  |  |  | R16
BANK3E | DDR_RST_N |  | DDR_RST_N |  |  |  | Y17
BANK3E | DDR_VREF |  | DDR_VREF |  |  |  | K17
BANK3E | DDR_WE_N |  | DDR_WE_N |  |  |  | U16
BANK3E | DDR_ZQ |  | DDR_ZQ |  |  |  | P18
BANK4A | GPIOB_RXN20 |  |  | GPIOB_RX20 |  | B | AA15
BANK4A | GPIOB_RXN21 |  |  | GPIOB_RX21 |  | B | R15
BANK4A | GPIOB_RXN28_EXTFB2 |  |  | GPIOB_RX28 |  | B | AB17
BANK4A | GPIOB_RXN29_CLKN2 |  |  | GPIOB_RX29 |  | B | W15
BANK4A | GPIOB_RXP20 |  |  | GPIOB_RX20 |  | B | AA16
BANK4A | GPIOB_RXP21 |  |  | GPIOB_RX21 |  | B | T15
BANK4A | GPIOB_RXP28_EXTFB2 |  |  | GPIOB_RX28 |  | B | AB16
BANK4A | GPIOB_RXP29_CLKP2 |  |  | GPIOB_RX29 |  | B | V15
BANK4B | GPIOB_RXN10 |  |  | GPIOB_RX10 |  | B | AA13
BANK4B | GPIOB_RXN12 |  |  | GPIOB_RX12 |  | B | U13
BANK4B | GPIOB_RXN14 |  |  | GPIOB_RX14 |  | B | AB14
BANK4B | GPIOB_RXN15 |  |  | GPIOB_RX15 |  | B | R13
BANK4B | GPIOB_RXN16 |  |  | GPIOB_RX16 |  | B | Y13
BANK4B | GPIOB_RXN18_EXTFB1 |  |  | GPIOB_RX18 |  | B | U14
BANK4B | GPIOB_RXN19_CLKN1 |  |  | GPIOB_RX19 |  | B | W14
BANK4B | GPIOB_RXP10 |  |  | GPIOB_RX10 |  | B | AB13
BANK4B | GPIOB_RXP12 |  |  | GPIOB_RX12 |  | B | T13
BANK4B | GPIOB_RXP14 |  |  | GPIOB_RX14 |  | B | AB15
BANK4B | GPIOB_RXP15 |  |  | GPIOB_RX15 |  | B | R14
BANK4B | GPIOB_RXP16 |  |  | GPIOB_RX16 |  | B | Y14
BANK4B | GPIOB_RXP18_EXTFB1 |  |  | GPIOB_RX18 |  | B | T14
BANK4B | GPIOB_RXP19_CLKP1 |  |  | GPIOB_RX19 |  | B | V14
BANK4C | GPIOB_RXN00 |  |  | GPIOB_RX00 |  | B | AA11
BANK4C | GPIOB_RXN01 |  |  | GPIOB_RX01 |  | B | R10
BANK4C | GPIOB_RXN03 |  |  | GPIOB_RX03 |  | B | V11
BANK4C | GPIOB_RXN05 |  |  | GPIOB_RX05 |  | B | AB12
BANK4C | GPIOB_RXN06 |  |  | GPIOB_RX06 |  | B | U12
BANK4C | GPIOB_RXN08_EXTFB0 |  |  | GPIOB_RX08 |  | B | W12
BANK4C | GPIOB_RXN09_CLKN0 |  |  | GPIOB_RX09 |  | B | T12
BANK4C | GPIOB_RXP00 |  |  | GPIOB_RX00 |  | B | AB11
BANK4C | GPIOB_RXP01 |  |  | GPIOB_RX01 |  | B | T10
BANK4C | GPIOB_RXP03 |  |  | GPIOB_RX03 |  | B | W11
BANK4C | GPIOB_RXP05 |  |  | GPIOB_RX05 |  | B | AA12
BANK4C | GPIOB_RXP06 |  |  | GPIOB_RX06 |  | B | U11
BANK4C | GPIOB_RXP08_EXTFB0 |  |  | GPIOB_RX08 |  | B | V12
BANK4C | GPIOB_RXP09_CLKP0 |  | DDR (PHY) Reference Clock | GPIOB_RX09 |  | B | R12
BANK4D | GPIOB_TXN22 |  |  | GPIOB_TX22 |  | B | AA8
BANK4D | GPIOB_TXN23 |  |  | GPIOB_TX23 |  | B | U10
BANK4D | GPIOB_TXN24 |  |  | GPIOB_TX24 |  | B | AA9
BANK4D | GPIOB_TXN25 |  |  | GPIOB_TX25 |  | B | V10
BANK4D | GPIOB_TXN26 |  |  | GPIOB_TX26 |  | B | AA10
BANK4D | GPIOB_TXP22 |  |  | GPIOB_TX22 |  | B | AB8
BANK4D | GPIOB_TXP23 |  |  | GPIOB_TX23 |  | B | U9
BANK4D | GPIOB_TXP24 |  |  | GPIOB_TX24 |  | B | AB9
BANK4D | GPIOB_TXP25 |  |  | GPIOB_TX25 |  | B | W10
BANK4D | GPIOB_TXP26 |  |  | GPIOB_TX26 |  | B | AB10
BANK4D | REF_RES_4D |  |  |  |  |  | Y10
BANK4E | GPIOB_TXN13_CDI18 | CDI18 |  | GPIOB_TX13 |  | B | Y7
BANK4E | GPIOB_TXN14_CDI16 | CDI16 |  | GPIOB_TX14 |  | B | AA6
BANK4E | GPIOB_TXN15_CDI14 | CDI14 |  | GPIOB_TX15 |  | B | U7
BANK4E | GPIOB_TXN16_CDI12 | CDI12 |  | GPIOB_TX16 |  | B | AA7
BANK4E | GPIOB_TXN17_CDI10 | CDI10 |  | GPIOB_TX17 |  | B | V8
BANK4E | GPIOB_TXN18_CDI8 | CDI8 |  | GPIOB_TX18 |  | B | U8
BANK4E | GPIOB_TXN19 |  |  | GPIOB_TX19 |  | B | W9
BANK4E | GPIOB_TXP13_CDI19 | CDI19 |  | GPIOB_TX13 |  | B | Y6
BANK4E | GPIOB_TXP14_CDI17 | CDI17 |  | GPIOB_TX14 |  | B | AB6
BANK4E | GPIOB_TXP15_CDI15 | CDI15 |  | GPIOB_TX15 |  | B | V7
BANK4E | GPIOB_TXP16_CDI13 | CDI13 |  | GPIOB_TX16 |  | B | AB7
BANK4E | GPIOB_TXP17_CDI11 | CDI11 |  | GPIOB_TX17 |  | B | W8
BANK4E | GPIOB_TXP18_CDI9 | CDI9 |  | GPIOB_TX18 |  | B | T8
BANK4E | GPIOB_TXP19 |  |  | GPIOB_TX19 |  | B | V9
BANK4E | REF_RES_4E |  |  |  |  |  | W6
BANK4F | GPIOB_TXN03_CDI30 | CDI30 |  | GPIOB_TX03 |  | B | W4
BANK4F | GPIOB_TXN04_CDI28 | CDI28 |  | GPIOB_TX04 |  | B | W3
BANK4F | GPIOB_TXN05_CDI26 | CDI26 |  | GPIOB_TX05 |  | B | Y1
BANK4F | GPIOB_TXN06_CDI24 | CDI24 |  | GPIOB_TX06 |  | B | AA2
BANK4F | GPIOB_TXN07_CDI22 | CDI22 |  | GPIOB_TX07 |  | B | AB4
BANK4F | GPIOB_TXN08_CDI20 | CDI20 |  | GPIOB_TX08 |  | B | AB5
BANK4F | GPIOB_TXP03_CDI31 | CDI31 |  | GPIOB_TX03 |  | B | Y4
BANK4F | GPIOB_TXP04_CDI29 | CDI29 |  | GPIOB_TX04 |  | B | W2
BANK4F | GPIOB_TXP05_CDI27 | CDI27 |  | GPIOB_TX05 |  | B | AA1
BANK4F | GPIOB_TXP06_CDI25 | CDI25 |  | GPIOB_TX06 |  | B | AB2
BANK4F | GPIOB_TXP07_CDI23 | CDI23 |  | GPIOB_TX07 |  | B | AB3
BANK4F | GPIOB_TXP08_CDI21 | CDI21 |  | GPIOB_TX08 |  | B | AA5
BANK4F | REF_RES_4F |  |  |  |  |  | AA3
BR | GPIOR_186_PLLIN0 |  | DDR (PHY) Reference Clock |  | Yes | R0 | M15
BR | GPIOR_187_PLLIN1 |  |  |  | Yes | R0 | L15
BR | GPIOR_188_PLLIN2 |  |  |  | Yes | R0 | K15
TR | GPIOR_166_PLLIN0 |  |  |  | Yes | R7 | C18
TR | GPIOR_167_PLLIN1 |  |  |  | Yes | R7 | A18
TR | GPIOR_168_PLLIN2 |  |  |  | Yes | R7 | D18
TR | GPIOR_169_MREFCLK |  |  |  | Yes | R7 | A19
- | VCC |  |  |  |  |  | H10
- | VCC |  |  |  |  |  | J11
- | VCC |  |  |  |  |  | J13
- | VCC |  |  |  |  |  | J15
- | VCC |  |  |  |  |  | J9
- | VCC |  |  |  |  |  | K10
- | VCC |  |  |  |  |  | K12
- | VCC |  |  |  |  |  | K14
- | VCC |  |  |  |  |  | L11
- | VCC |  |  |  |  |  | L13
- | VCC |  |  |  |  |  | L9
- | VCC |  |  |  |  |  | M10
- | VCC |  |  |  |  |  | M12
- | VCC |  |  |  |  |  | M14
- | VCC |  |  |  |  |  | M8
- | VCC |  |  |  |  |  | N11
- | VCC |  |  |  |  |  | N13
- | VCC |  |  |  |  |  | N9
- | VCC |  |  |  |  |  | P10
- | VCC |  |  |  |  |  | P12
- | VCC |  |  |  |  |  | P14
- | VCC |  |  |  |  |  | R11
- | VCCA_BL |  |  |  |  |  | W5
- | VCCA_BR |  |  |  |  |  | N15
- | VCCA_BR |  |  |  |  |  | P15
- | VCCA_TL |  |  |  |  |  | D5
- | VCCA_TR |  |  |  |  |  | D17
- | VCCA_TR |  |  |  |  |  | E17
- | VCCIO_DDR |  |  |  |  |  | AA17
- | VCCIO_DDR |  |  |  |  |  | AA19
- | VCCIO_DDR |  |  |  |  |  | AA21
- | VCCIO_DDR |  |  |  |  |  | F19
- | VCCIO_DDR |  |  |  |  |  | F21
- | VCCIO_DDR |  |  |  |  |  | G18
- | VCCIO_DDR |  |  |  |  |  | J17
- | VCCIO_DDR |  |  |  |  |  | J19
- | VCCIO_DDR |  |  |  |  |  | J21
- | VCCIO_DDR |  |  |  |  |  | M17
- | VCCIO_DDR |  |  |  |  |  | M19
- | VCCIO_DDR |  |  |  |  |  | M21
- | VCCIO_DDR |  |  |  |  |  | R17
- | VCCIO_DDR |  |  |  |  |  | R19
- | VCCIO_DDR |  |  |  |  |  | R21
- | VCCIO_DDR |  |  |  |  |  | V17
- | VCCIO_DDR |  |  |  |  |  | V19
- | VCCIO_DDR |  |  |  |  |  | V21
- | VCCIO1A |  |  |  |  |  | U3
- | VCCIO1B_1C |  |  |  |  |  | N3
- | VCCIO1B_1C |  |  |  |  |  | N6
- | VCCIO1B_1C |  |  |  |  |  | R5
- | VCCIO1D_1E |  |  |  |  |  | J6
- | VCCIO1D_1E |  |  |  |  |  | K3
- | VCCIO1F_1G |  |  |  |  |  | F2
- | VCCIO1F_1G |  |  |  |  |  | F3
- | VCCIO2A |  |  |  |  |  | B3
- | VCCIO2A |  |  |  |  |  | D3
- | VCCIO2B |  |  |  |  |  | C8
- | VCCIO2B |  |  |  |  |  | D6
- | VCCIO2C |  |  |  |  |  | C9
- | VCCIO2C |  |  |  |  |  | F9
- | VCCIO2D |  |  |  |  |  | D12
- | VCCIO2D |  |  |  |  |  | F11
- | VCCIO2E |  |  |  |  |  | C14
- | VCCIO2E |  |  |  |  |  | F14
- | VCCIO2F |  |  |  |  |  | C17
- | VCCIO2F |  |  |  |  |  | G16
- | VCCIO3D_TR_BR |  |  |  |  |  | B18
- | VCCIO3D_TR_BR |  |  |  |  |  | C20
- | VCCIO4A |  |  |  |  |  | U15
- | VCCIO4A |  |  |  |  |  | Y16
- | VCCIO4B |  |  |  |  |  | AA14
- | VCCIO4B |  |  |  |  |  | V13
- | VCCIO4C |  |  |  |  |  | T11
- | VCCIO4C |  |  |  |  |  | Y12
- | VCCIO4D |  |  |  |  |  | T9
- | VCCIO4D |  |  |  |  |  | Y9
- | VCCIO4E |  |  |  |  |  | R9
- | VCCIO4E |  |  |  |  |  | W7
- | VCCIO4F |  |  |  |  |  | AA4
- | VCCIO4F |  |  |  |  |  | Y3
- | GND |  |  |  |  |  | A1
- | GND |  |  |  |  |  | A22
- | GND |  |  |  |  |  | AB1
- | GND |  |  |  |  |  | AB22
- | GND |  |  |  |  |  | B12
- | GND |  |  |  |  |  | B4
- | GND |  |  |  |  |  | D13
- | GND |  |  |  |  |  | D16
- | GND |  |  |  |  |  | D4
- | GND |  |  |  |  |  | D7
- | GND |  |  |  |  |  | E18
- | GND |  |  |  |  |  | E20
- | GND |  |  |  |  |  | F22
- | GND |  |  |  |  |  | H15
- | GND |  |  |  |  |  | H17
- | GND |  |  |  |  |  | H2
- | GND |  |  |  |  |  | H22
- | GND |  |  |  |  |  | H5
- | GND |  |  |  |  |  | J10
- | GND |  |  |  |  |  | J12
- | GND |  |  |  |  |  | J14
- | GND |  |  |  |  |  | J20
- | GND |  |  |  |  |  | K11
- | GND |  |  |  |  |  | K13
- | GND |  |  |  |  |  | K16
- | GND |  |  |  |  |  | K18
- | GND |  |  |  |  |  | K9
- | GND |  |  |  |  |  | L10
- | GND |  |  |  |  |  | L12
- | GND |  |  |  |  |  | L14
- | GND |  |  |  |  |  | L8
- | GND |  |  |  |  |  | M11
- | GND |  |  |  |  |  | M13
- | GND |  |  |  |  |  | M2
- | GND |  |  |  |  |  | M5
- | GND |  |  |  |  |  | M9
- | GND |  |  |  |  |  | N10
- | GND |  |  |  |  |  | N12
- | GND |  |  |  |  |  | N14
- | GND |  |  |  |  |  | N16
- | GND |  |  |  |  |  | N18
- | GND |  |  |  |  |  | N20
- | GND |  |  |  |  |  | N22
- | GND |  |  |  |  |  | N8
- | GND |  |  |  |  |  | P11
- | GND |  |  |  |  |  | P13
- | GND |  |  |  |  |  | P9
- | GND |  |  |  |  |  | T16
- | GND |  |  |  |  |  | T18
- | GND |  |  |  |  |  | T2
- | GND |  |  |  |  |  | T5
- | GND |  |  |  |  |  | T7
- | GND |  |  |  |  |  | U20
- | GND |  |  |  |  |  | U22
- | GND |  |  |  |  |  | W13
- | GND |  |  |  |  |  | W18
- | GND |  |  |  |  |  | Y11
- | GND |  |  |  |  |  | Y15
- | GND |  |  |  |  |  | Y2
- | GND |  |  |  |  |  | Y20
- | GND |  |  |  |  |  | Y5
- | GND |  |  |  |  |  | Y8
