wickerwaka/nuBoard/hardware/main-board/fpga_pin_map.csv

Signal | GPIO | Ball | Bank | Group
F_L00 | GPIOT_TXN06 | A3 | BANK2A | L0
F_L01 | GPIOT_TXP05 | A2 | BANK2A | L0
F_L02 | GPIOT_TXN05 | B2 | BANK2A | L0
F_L03 | GPIOT_TXN04 | B1 | BANK2A | L0
F_L04 | GPIOT_TXN02 | C2 | BANK2A | L0
F_L05 | GPIOT_TXP04 | C1 | BANK2A | L0
F_L06 | GPIOT_TXP02 | D2 | BANK2A | L0
F_L07 | GPIOT_TXP01 | D1 | BANK2A | L0
F_L0_DIR | GPIOL_160_PLLIN1 | E3 | BANK1G | L0
~{F_L0_OE} | GPIOL_164_PLLIN0 | E4 | BANK1G | L0
F_L10 | GPIOL_123 | H6 | BANK1F | L1
F_L11 | GPIOL_121 | H4 | BANK1F | L1
F_L12 | GPIOL_115 | J7 | BANK1E | L1
F_L13 | GPIOL_85 | J5 | BANK1D | L1
F_L14 | GPIOL_88 | J4 | BANK1D | L1
F_L15 | GPIOL_81 | K5 | BANK1D | L1
F_L16 | GPIOL_79 | K4 | BANK1D | L1
F_L17 | GPIOL_72_CLK6 | L6 | BANK1D | L1
F_L1_DIR | GPIOL_71_CLK5 | L5 | BANK1D | L1
~{F_L1_OE} | GPIOL_74_CTRL4 | L4 | BANK1D | L1
F_L20 | GPIOL_56 | N4 | BANK1C | L2
F_L21 | GPIOL_64_CTRL2 | M4 | BANK1C | L2
F_L22 | GPIOL_62_CTRL0 | N1 | BANK1C | L2
F_L23 | GPIOL_63_CTRL1 | N2 | BANK1C | L2
F_L24 | GPIOL_52 | P1 | BANK1C | L2
F_L25 | GPIOL_50 | P2 | BANK1C | L2
F_L26 | GPIOL_51 | P3 | BANK1C | L2
F_L27 | GPIOL_49 | R1 | BANK1C | L2
F_L2_DIR | GPIOL_15_PLLIN0 | R2 | BANK1B | L2
~{F_L2_OE} | GPIOL_17_EXTFB0 | R3 | BANK1B | L2
F_T20 | GPIOT_TXP14 | A7 | BANK2B | T2
F_T21 | GPIOT_TXN14 | B7 | BANK2B | T2
F_T22 | GPIOT_TXP12 | A6 | BANK2B | T2
F_T23 | GPIOT_TXN12 | B6 | BANK2B | T2
F_T24 | GPIOT_TXP10 | C6 | BANK2B | T2
F_T25 | GPIOT_TXP07 | A5 | BANK2A | T2
F_T26 | GPIOT_TXN07 | B5 | BANK2A | T2
F_T27 | GPIOT_TXN03 | C4 | BANK2A | T2
F_T2_DIR | GPIOT_TXP06 | A4 | BANK2A | T2
~{F_T2_OE} | GPIOT_TXP03 | C3 | BANK2A | T2
F_T10 | GPIOT_RXN01 | B11 | BANK2D | T1
F_T11 | GPIOT_RXP01 | A11 | BANK2D | T1
F_T12 | GPIOT_TXP24 | D10 | BANK2C | T1
F_T13 | GPIOT_TXN25 | B10 | BANK2C | T1
F_T14 | GPIOT_TXP25 | A10 | BANK2C | T1
F_T15 | GPIOT_TXN23 | B9 | BANK2C | T1
F_T16 | GPIOT_TXP23 | A9 | BANK2C | T1
F_T17 | GPIOT_TXP18 | B8 | BANK2B | T1
F_T1_DIR | GPIOT_TXN18 | A8 | BANK2B | T1
~{F_T1_OE} | GPIOT_TXN10 | C7 | BANK2B | T1
F_T00 | GPIOT_RXP18_EXTFB1 | B15 | BANK2E | T0
F_T01 | GPIOT_RXN18_EXTFB1 | A15 | BANK2E | T0
F_T02 | GPIOT_RXN19_CLKN1 | D14 | BANK2E | T0
F_T03 | GPIOT_RXP15 | B14 | BANK2E | T0
F_T04 | GPIOT_RXN15 | A14 | BANK2E | T0
F_T05 | GPIOT_RXN13 | C13 | BANK2E | T0
F_T06 | GPIOT_RXP13 | B13 | BANK2E | T0
F_T07 | GPIOT_RXN11 | A13 | BANK2E | T0
F_T0_DIR | GPIOT_RXP11 | A12 | BANK2E | T0
~{F_T0_OE} | GPIOT_RXN04 | C12 | BANK2D | T0
F_R20 | GPIOR_168_PLLIN2 | D18 | TR | R2
F_R21 | GPIOR_166_PLLIN0 | C18 | TR | R2
F_R22 | GPIOR_169_MREFCLK | A19 | TR | R2
F_R23 | GPIOT_RXN22 | D15 | BANK2F | R2
F_R24 | GPIOT_RXP23 | C16 | BANK2F | R2
F_R25 | GPIOT_RXN23 | C15 | BANK2F | R2
F_R26 | GPIOT_RXN20 | B16 | BANK2F | R2
F_R27 | GPIOT_RXP21 | A17 | BANK2F | R2
F_R2_DIR | GPIOT_RXN21 | B17 | BANK2F | R2
~{F_R2_OE} | GPIOT_RXP20 | A16 | BANK2F | R2
F_R10 | GPIOR_183_CTRL10 | D22 | BANK3D | R1
F_R11 | GPIOR_173_CTRL12 | D19 | BANK3D | R1
F_R12 | GPIOR_182_CTRL11 | C22 | BANK3D | R1
F_R13 | GPIOR_178_CLK11 | C21 | BANK3D | R1
F_R14 | GPIOR_171_CTRL14 | C19 | BANK3D | R1
F_R15 | GPIOR_180_CLK9 | B22 | BANK3D | R1
F_R16 | GPIOR_177_CLK12 | B21 | BANK3D | R1
F_R17 | GPIOR_175_CLK14 | B20 | BANK3D | R1
F_R1_DIR | GPIOR_172_CTRL13 | B19 | BANK3D | R1
~{F_R1_OE} | GPIOR_176_CLK13 | A21 | BANK3D | R1
F_R00 | GPIOB_RXP10 | AB13 | BANK4B | R0
F_R01 | GPIOB_RXN14 | AB14 | BANK4B | R0
F_R02 | GPIOB_RXP14 | AB15 | BANK4B | R0
F_R03 | GPIOB_RXP16 | Y14 | BANK4B | R0
F_R04 | GPIOB_RXN19_CLKN1 | W14 | BANK4B | R0
F_R05 | GPIOB_RXP19_CLKP1 | V14 | BANK4B | R0
F_R06 | GPIOB_RXN18_EXTFB1 | U14 | BANK4B | R0
F_R07 | GPIOB_RXN20 | AA15 | BANK4A | R0
F_R0_DIR | GPIOB_RXP29_CLKP2 | V15 | BANK4A | R0
~{F_R0_OE} | GPIOB_RXN29_CLKN2 | W15 | BANK4A | R0
F_B20 | GPIOB_RXP00 | AB11 | BANK4C | B2
F_B21 | GPIOB_RXN00 | AA11 | BANK4C | B2
F_B22 | GPIOL_19_PLLIN1 | R4 | BANK1B | B2
F_B23 | GPIOB_RXN05 | AB12 | BANK4C | B2
F_B24 | GPIOB_RXP05 | AA12 | BANK4C | B2
F_B25 | GPIOB_RXN08_EXTFB0 | W12 | BANK4C | B2
F_B26 | GPIOB_RXP08_EXTFB0 | V12 | BANK4C | B2
F_B27 | GPIOB_RXN10 | AA13 | BANK4B | B2
F_B2_DIR | GPIOB_RXP03 | W11 | BANK4C | B2
~{F_B2_OE} | GPIOB_RXN16 | Y13 | BANK4B | B2
F_B10 | GPIOB_TXP14_CDI17 | AB6 | BANK4E | B1
F_B11 | GPIOB_TXN14_CDI16 | AA6 | BANK4E | B1
F_B12 | GPIOB_TXP13_CDI19 | Y6 | BANK4E | B1
F_B13 | GPIOB_TXP16_CDI13 | AB7 | BANK4E | B1
F_B14 | GPIOB_TXN16_CDI12 | AA7 | BANK4E | B1
F_B15 | GPIOB_TXN13_CDI18 | Y7 | BANK4E | B1
F_B16 | GPIOB_TXN22 | AA8 | BANK4D | B1
F_B17 | GPIOB_TXP17_CDI11 | W8 | BANK4E | B1
F_B1_DIR | GPIOB_TXP15_CDI15 | V7 | BANK4E | B1
~{F_B1_OE} | GPIOB_TXN17_CDI10 | V8 | BANK4E | B1
F_B00 | GPIOB_TXP04_CDI29 | W2 | BANK4F | B0
F_B01 | GPIOB_TXN04_CDI28 | W3 | BANK4F | B0
F_B02 | GPIOB_TXN05_CDI26 | Y1 | BANK4F | B0
F_B03 | GPIOB_TXP05_CDI27 | AA1 | BANK4F | B0
F_B04 | GPIOB_TXN06_CDI24 | AA2 | BANK4F | B0
F_B05 | GPIOB_TXP06_CDI25 | AB2 | BANK4F | B0
F_B06 | GPIOB_TXP07_CDI23 | AB3 | BANK4F | B0
F_B07 | GPIOB_TXN03_CDI30 | W4 | BANK4F | B0
F_B0_DIR | GPIOB_TXP03_CDI31 | Y4 | BANK4F | B0
~{F_B0_OE} | GPIOB_TXN07_CDI22 | AB4 | BANK4F | B0
~{F_X_OE} | GPIOB_TXP24 | AB9 | BANK4D | X
F_LCLK | GPIOL_147 | G5 | BANK1F | LCLK
F_LCLK_EN | GPIOL_138 | G4 | BANK1F | LCLK
F_TCLK | GPIOT_RXN02 | D11 | BANK2D | TCLK
F_TCLK_EN | GPIOT_RXP04 | C11 | BANK2D | TCLK
F_BCLK | GPIOB_TXP08_CDI21 | AA5 | BANK4F | BCLK
F_BCLK_EN | GPIOB_TXN08_CDI20 | AB5 | BANK4F | BCLK
F_RCLK | GPIOR_179_CLK10 | D20 | BANK3D | RCLK
R_RCLK_EN | GPIOR_184_CTRL9 | D21 | BANK3D | RCLK
DUT_CROWBAR | GPIOT_TXN01 | E1 | BANK2A | DUT
DUT_ISOLATE | GPIOL_162_EXTFB | E5 | BANK1G | DUT
HR_DQ0 | GPIOL_87 | K1 | BANK1D | HyperRAM
HR_DQ1 | GPIOL_68_CLK2 | L1 | BANK1C | HyperRAM
HR_DQ2 | GPIOL_133 | H1 | BANK1F | HyperRAM
HR_DQ3 | GPIOL_119 | J1 | BANK1F | HyperRAM
HR_DQ4 | GPIOL_136 | G1 | BANK1F | HyperRAM
HR_DQ5 | GPIOL_89 | K2 | BANK1D | HyperRAM
HR_DQ6 | GPIOL_69_CLK3 | L2 | BANK1C | HyperRAM
HR_DQ7 | GPIOL_67_CLK1 | M3 | BANK1C | HyperRAM
HR_CK | GPIOL_65_CTRL3 | M1 | BANK1C | HyperRAM
HR_RWDS | GPIOL_73_CLK7 | L3 | BANK1D | HyperRAM
HR_CS_N | GPIOL_141 | G3 | BANK1F | HyperRAM
HR_RESET_N | GPIOL_142 | G2 | BANK1F | HyperRAM
F_TX0 | GPIOT_TXN11 | E6 | BANK2B | X
F_TX1 | GPIOT_TXP11 | F6 | BANK2B | X
F_TX2 | GPIOL_47 | P5 | BANK1C | X
F_TX3 | GPIOT_TXP16 | E8 | BANK2B | X
F_LX0 | GPIOT_TXN21 | D9 | BANK2C | X
F_LX1 | GPIOT_TXN24 | E10 | BANK2C | X
F_LX2 | GPIOT_RXN09_CLKN0 | E12 | BANK2D | X
F_LX3 | GPIOT_TXP26 | F10 | BANK2C | X
F_RX0 | GPIOB_RXN03 | V11 | BANK4C | X
F_RX1 | GPIOB_TXN25 | V10 | BANK4D | X
F_RX2 | GPIOB_TXP25 | W10 | BANK4D | X
F_RX3 | GPIOB_TXN26 | AA10 | BANK4D | X
F_BX3 | GPIOB_TXP26 | AB10 | BANK4D | X
F_BX2 | GPIOB_TXN19 | W9 | BANK4E | X
F_BX1 | GPIOB_TXN24 | AA9 | BANK4D | X
F_BX0 | GPIOB_TXP22 | AB8 | BANK4D | X
