wickerwaka/nuBoard/hardware/daughter-boards-overview-v2.png

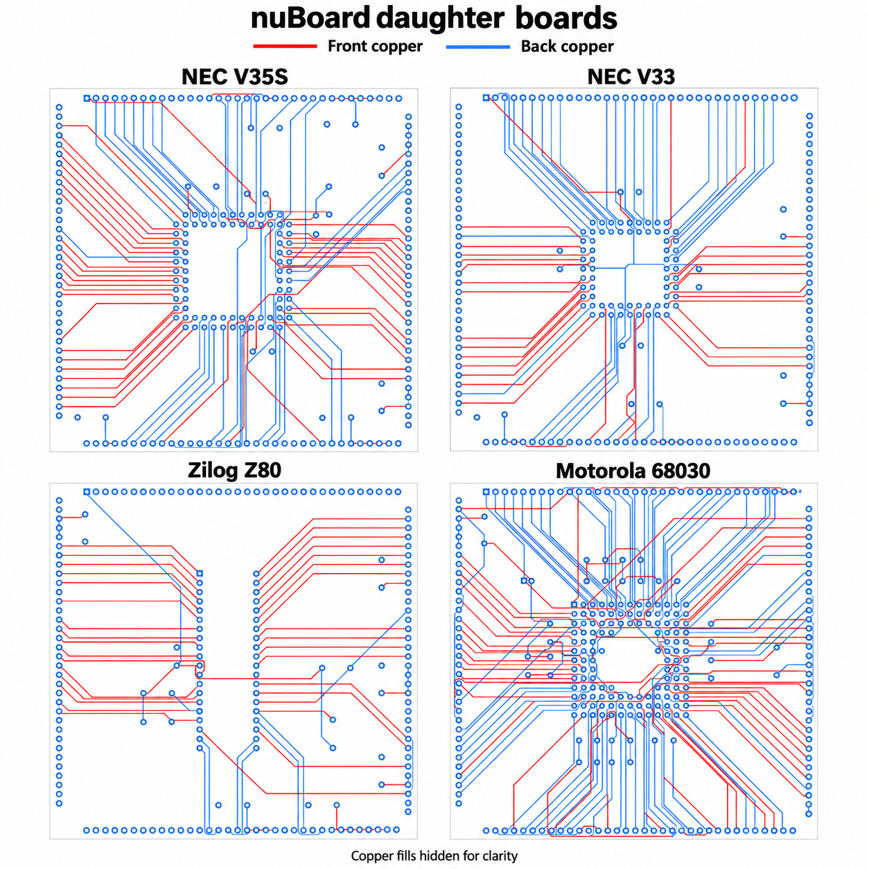
hardware/daughter-boards-overview-v2.png
