wickerwaka/nuBoard/hardware/daughter-boards-overview-v3.png

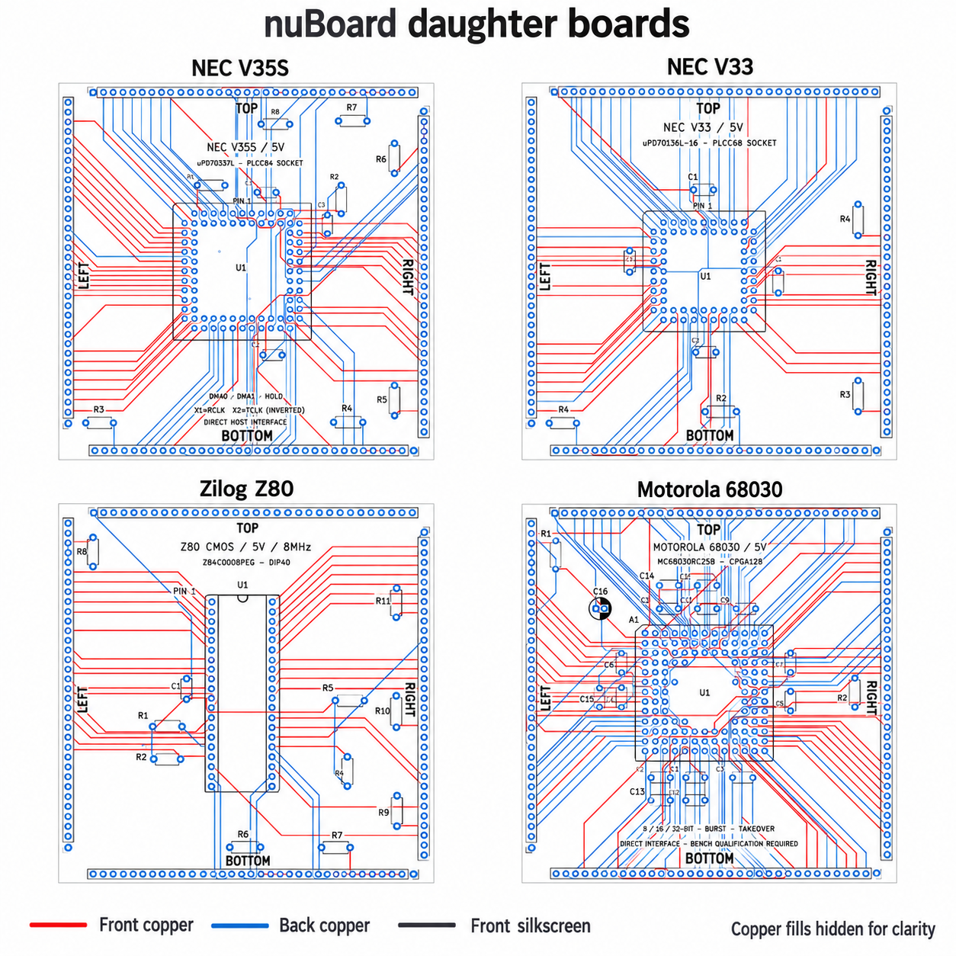
hardware/daughter-boards-overview-v3.png
