wickerwaka/nuBoard/hardware/daughter-boards-overview.png

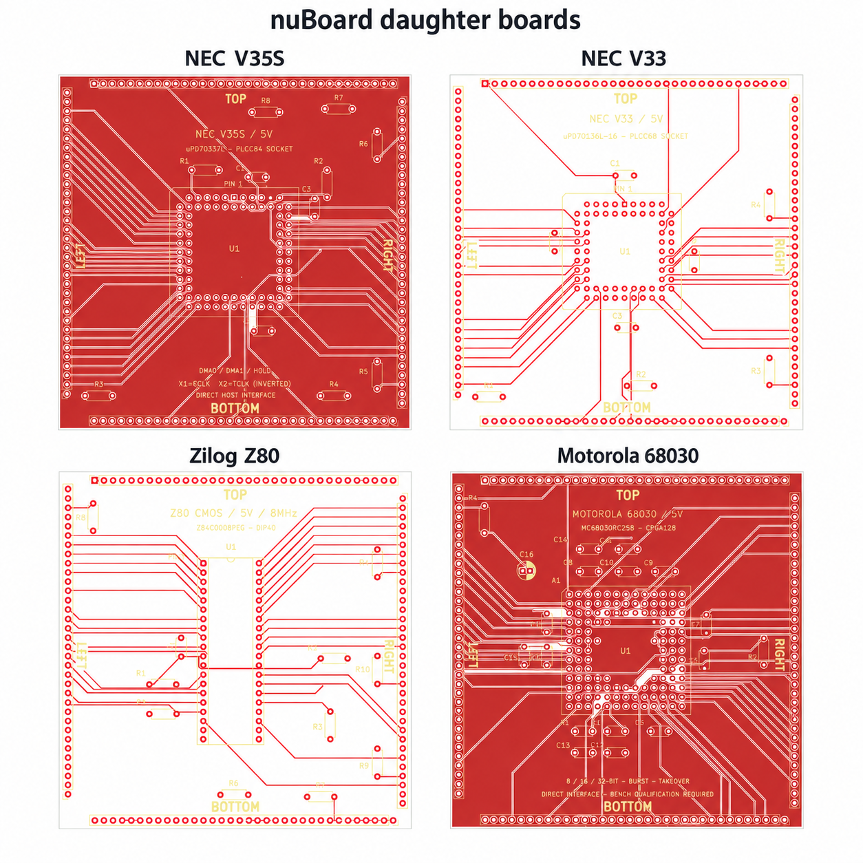
hardware/daughter-boards-overview.png
