wickerwaka/nuBoard/hardware/68030/bom.csv

References | Quantity | Value / part | Package | Notes
U1 | 1 | Motorola MC68030RC25B | CPGA128 CASE789C-01 | Direct CPU pin mounting; no socket qualified
C1 C2 C3 C4 C5 C6 C7 C8 C9 C10 | 10 | 100nF X7R ceramic >=50V | 0805 SMD HandSolder | one per VCC pin
C11 C12 C13 C14 C15 | 5 | 330pF C0G ceramic >=50V | 0805 SMD HandSolder | Supplementary high-frequency bypass; 0805 C0G
C16 | 1 | 10uF X7R/X5R MLCC >=25V | 0805 SMD HandSolder | Nonpolar; check effective capacitance at 5V DC bias
R1 R2 | 2 | 47k 1% >=0.25W | 0805 SMD HandSolder | One shared unused-bit pull-down per partially used bank
J1 | 1 | nuBoard mating contact set | Four 34-position rows, 2.54mm pitch | Match host mating geometry and height
