wickerwaka/nuBoard/hardware/main-board/production/bom.csv

Designator | Footprint | Quantity | Value | LCSC Part #
C1, C131 | 0402 | 2 | 4.7u | C23733
C10, C11, C118, C119, C12, C120, C121, C122, C123, C124, C125, C128, C129, C13, C130, C14, C15, C16, C17, C18, C19, C20, C21, C22, C23, C24, C25, C26, C27, C28, C29, C30, C31, C32, C33, C34, C35, C36, C37, C38, C39, C5, C6, C7, C8, C9 | 0201 | 46 | 0.1u 0201 | C5142565
C100, C114, C115, C86, C87, C90, C91, C93, C97 | 0805 | 9 | 10u | C15850
C101, C104, C107, C110, C113, C116, C117, C132, C145, C146, C147, C148, C149, C150, C151, C152, C153, C154, C155, C156, C157, C158, C159, C160, C161, C162, C163, C164, C165, C166, C167, C168, C169, C170, C171, C172, C173, C174, C175, C176, C177, C178, C179, C180, C181, C182, C183, C184, C185, C186, C187, C188, C189, C190, C191, C192, C193, C194, C2, C3 | 0402 | 60 | 0.1u | C1525
C102, C103, C108, C109 | 0402 | 4 | 22u | C22367823
C105, C106, C111, C112 | 0402 | 4 | 10u | C315248
C126, C127, C92, C94, C95, C96, C98, C99 | 0402 | 8 | 1u | C52923
C133, C134, C4 | 0402 | 3 | 0.01u | C15195
C40, C41, C42, C43, C44, C45, C46, C47, C48, C49, C50, C51, C52, C53, C54, C55, C56, C57, C58, C59, C60, C61, C62, C63, C64, C65, C66, C67, C68, C69, C70, C71, C72, C73, C74, C75, C76, C77, C78, C79, C80, C81, C82, C83 | 0201 | 44 | 0.01u 0201 | C285010
C84, C85, C88, C89 | 0805 | 4 | 1u | C28323
D1, D2, D3, D4 | 0603 | 4 | LED | C2286
FB1 | 0402 | 1 | 33ohm 100mhz | C160974
J1 | PinHeader_2x05_P1.27mm_Vertical_SMD | 1 | FPGA Debug | C41376037
J2 | BarrelJack_Wuerth_6941xx301002 | 1 | Barrel_Jack_Switch
J3 | USB_C_Receptacle_HCTL_HC-TYPE-C-16P-01A | 1 | USB_C_Receptacle_USB2.0_16P | C2894897
J4 | PinHeader_2x05_P1.27mm_Vertical_SMD | 1 | MCU Debug | C41376037
J5, J6, J7, J8 | PinSocket_1x34_P2.54mm_Vertical | 4 | Conn_01x34_Socket
L1, L2 | 0805 | 2 | 2.2uH | C16903
Q1 | SOT-223-3_TabPin2 | 1 | NVF5P03T3G | C895162
Q2 | SOT-23 | 1 | BSR802NL6327 | C5240463
R1, R10, R11, R13, R14, R15, R17, R18, R2, R24, R27, R28, R3, R31, R32, R33, R39, R4, R40, R5, R56, R57, R58, R59, R6, R60, R61, R62, R63, R64, R65, R66, R67, R68, R7, R70, R72, R74, R76, R77, R78, R79, R8, R9 | 0402 | 44 | 10K | C25744
R12, R29, R30, R69, R71, R73, R75 | 0402 | 7 | 22 | C25092
R16, R19, R35, R38, R42, R43 | 0402 | 6 | 1K | C11702
R20, R21 | 0402 | 2 | 5.1K | C25905
R22 | 0402 | 1 | 33.2K 1% | C122548
R23, R26 | 0402 | 2 | 10K 1% | C25744
R25 | 0402 | 1 | 5.76K 1% | C11590
R34 | 0402 | 1 | 400 | C2909358
R36, R37, R41 | 0402 | 3 | 27 | C25100
RN1, RN10, RN11, RN12, RN13, RN14, RN15, RN16, RN17, RN18, RN19, RN2, RN20, RN21, RN22, RN23, RN24, RN3, RN4, RN5, RN6, RN7, RN8, RN9 | YC248-JR-0722RL | 24 | 22R | C695207
SW1 | SW_SPST_Omron_B3FS-100xP | 1 | MCU_Reset | C271750
SW2 | SW_SPST_Omron_B3FS-100xP | 1 | MCU_Boot | C271750
TP1 | TestPoint_Pad_D1.0mm | 1 | +5V
TP2 | TestPoint_Pad_D1.0mm | 1 | +3.3V
TP3 | TestPoint_Pad_D1.0mm | 1 | +1.2V
TP4 | TestPoint_Pad_D1.0mm | 1 | VCC_DUT
TP5 | TestPoint_Pad_D1.0mm | 1 | VCCB
U1 | LFBGA-484_18x18mm_Layout22x22_P0.8mm | 1 | T120F484 | C3277977
U10 | SOIC-8_5.3x5.3mm_P1.27mm | 1 | W25Q128JVS | C97521
U11 | QFN-56-1EP_7x7mm_P0.4mm_EP3.2x3.2mm | 1 | RP2040 | C2040
U2 | ISSI_TFBGA-24_6x8mm_P1.0mm | 1 | IS66WVH8M8BLL-100B1LI | C1349096
U24, U25, U26, U27, U28, U29, U30, U31, U32, U33, U34, U35 | TSSOP-24_4.4x7.8mm_P0.65mm | 12 | SN74LVC8T245PWR | C27643
U3 | SOT-583-8 | 1 | TPS2116DRL | C3235557
U36, U41 | TSSOP-20_4.4x6.5mm_P0.65mm | 2 | TXS0108EPW | C17206
U37, U38, U39, U40 | SOT-563 | 4 | SN74LVC1T45DRL | C352970
U4, U5 | SOT-23-5 | 2 | AP2112K-3.3 | C23380830
U6, U7 | SOT-23-6 | 2 | TPS563201 | C116592
U8 | SOIC-8_3.9x4.9mm_P1.27mm | 1 | UCC27524D | C465729
U9 | SOP65P640X120-8N | 1 | TPS2111APWR | C471060
Y1 | Oscillator_SMD_Abracon_ASE-4Pin_3.2x2.5mm | 1 | 50Mhz | C717684
Y2 | Oscillator_SMD_Abracon_ASE-4Pin_3.2x2.5mm | 1 | 12Mhz | C596950
