wickerwaka/nuBoard/hardware/68000/production/bom.csv

Designator | Footprint | Quantity | Value | LCSC Part #
C1, C2 | C_Disc_D4.7mm_W2.5mm_P5.00mm | 2 | 100n
J1 | nuMezzanine_4x34_P2.54mm | 1 | nuMezzanine_4x34
R1, R2 | R_Axial_DIN0207_L6.3mm_D2.5mm_P7.62mm_Horizontal | 2 | 10k
U1 | DIP-64_W22.86mm | 1 | MC68000P
