wickerwaka/nuBoard/hardware/main-board/Trion_F484.step

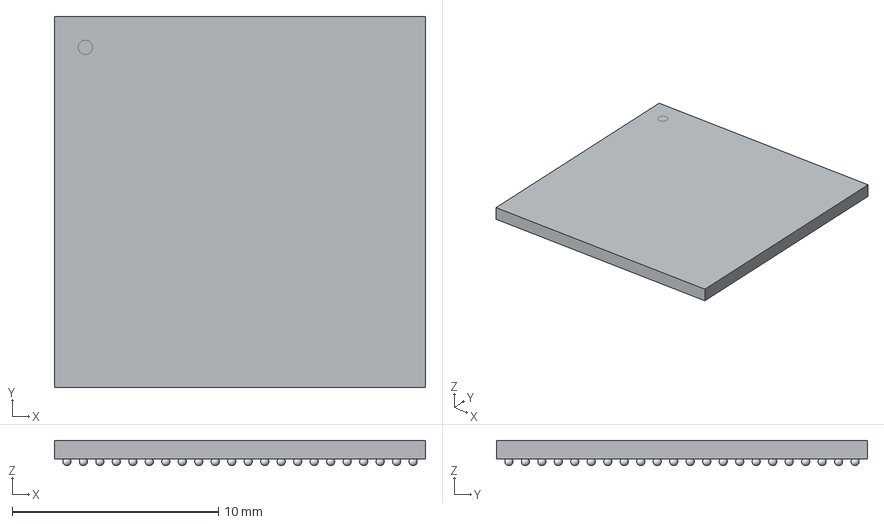
[picture p5: CAD file, 2026-09-13]
hardware/main-board/Trion_F484.step
18.0 x 18.0 x 1.23 mm
AB1
AA1
Y1
W1
V1
U1
T1
R1
P1
N1
M1
L1
K1
J1
H1
G1
F1
E1
D1
C1
B1
A1
AB2
AA2
Y2
W2
V2
U2
T2
R2
P2
N2
M2
L2
K2
J2
H2
G2
F2
E2
D2
C2
B2
A2
AB3
AA3
Y3
W3
V3
U3
T3
R3
P3
N3
M3
L3
K3
J3
H3
G3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
