wickerwaka/nuBoard/hardware/main-board/T20F256C3.step

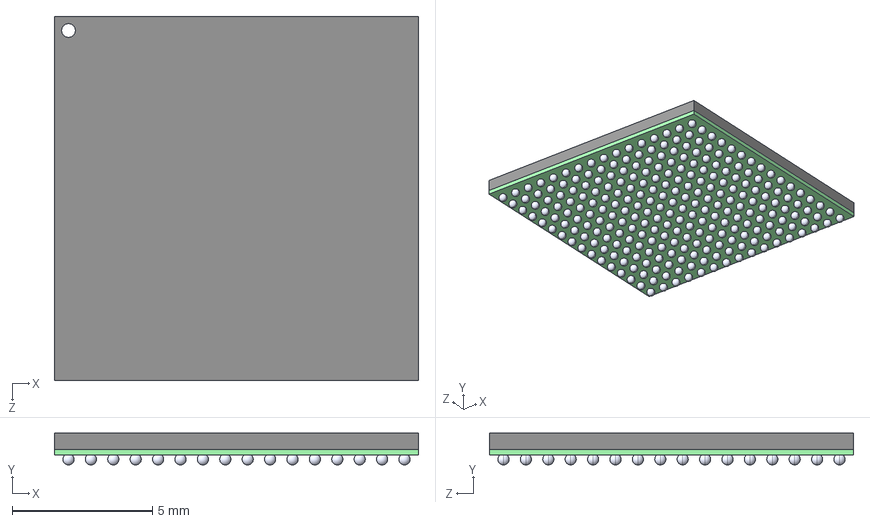
[picture p6: CAD file, 2026-09-13]
hardware/main-board/T20F256C3.step
13.0 x 1.14 x 13.0 mm
