wickerwaka/nuBoard/hardware/daughter-boards-copper-silkscreen.pdf

## NEC V35S / 5V

# TOP

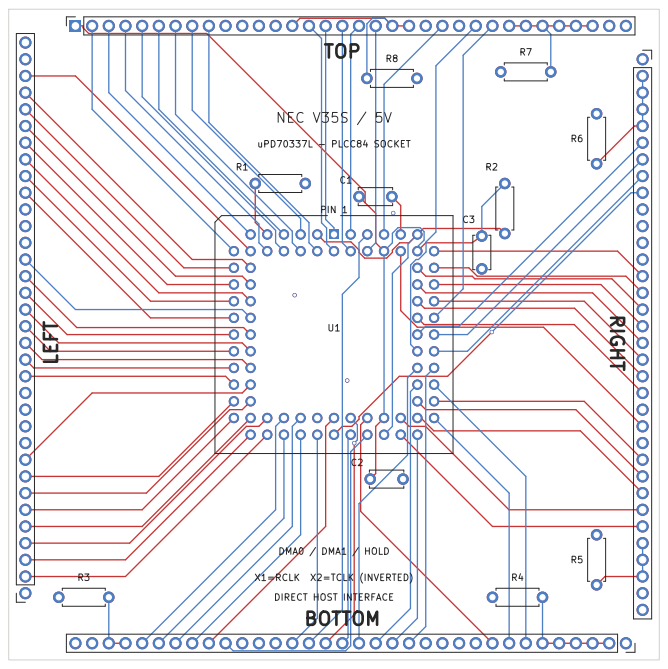
[picture p7: page 1]

NEC | V33 | / | 5V

# TOP

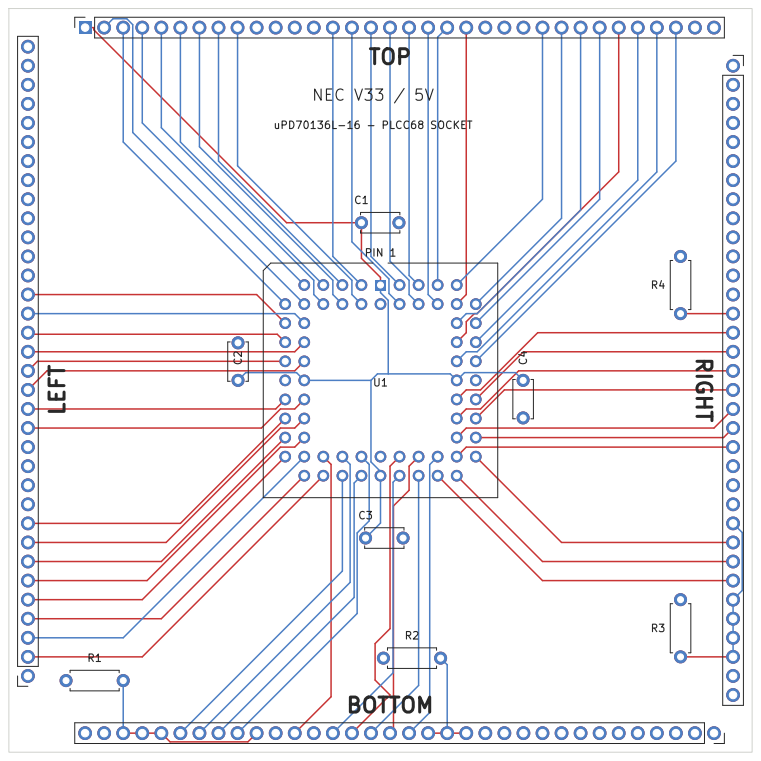
[picture p8: page 2]

## Z80 CMOS / 5V / 8MHz

# TOP

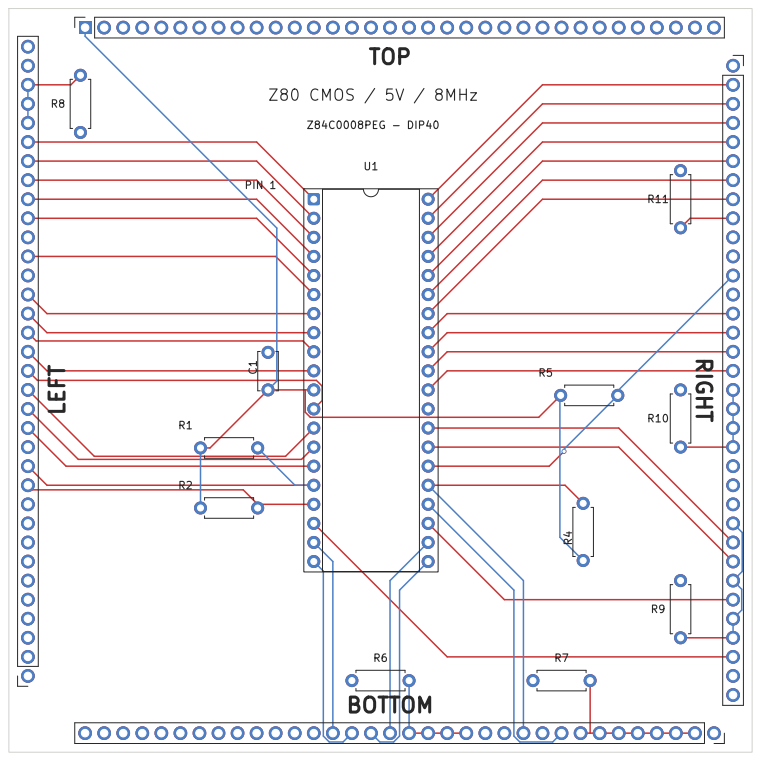
[picture p9: page 3]

## MOTOROLA 68030 / 5V

# TOP

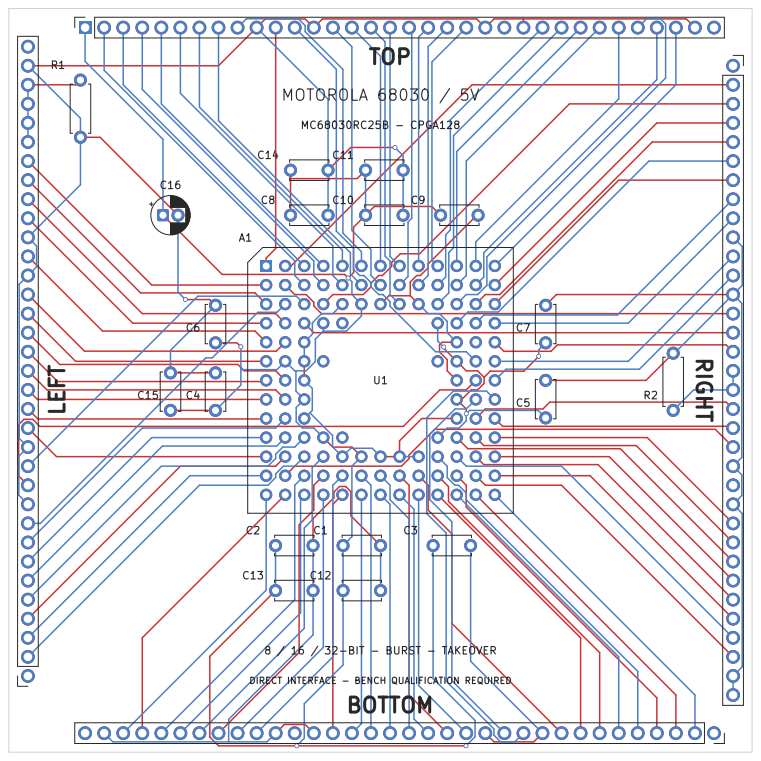
[picture p10: page 4]
