wickerwaka/nuBoard/hardware/68030/reports/schematic.pdf

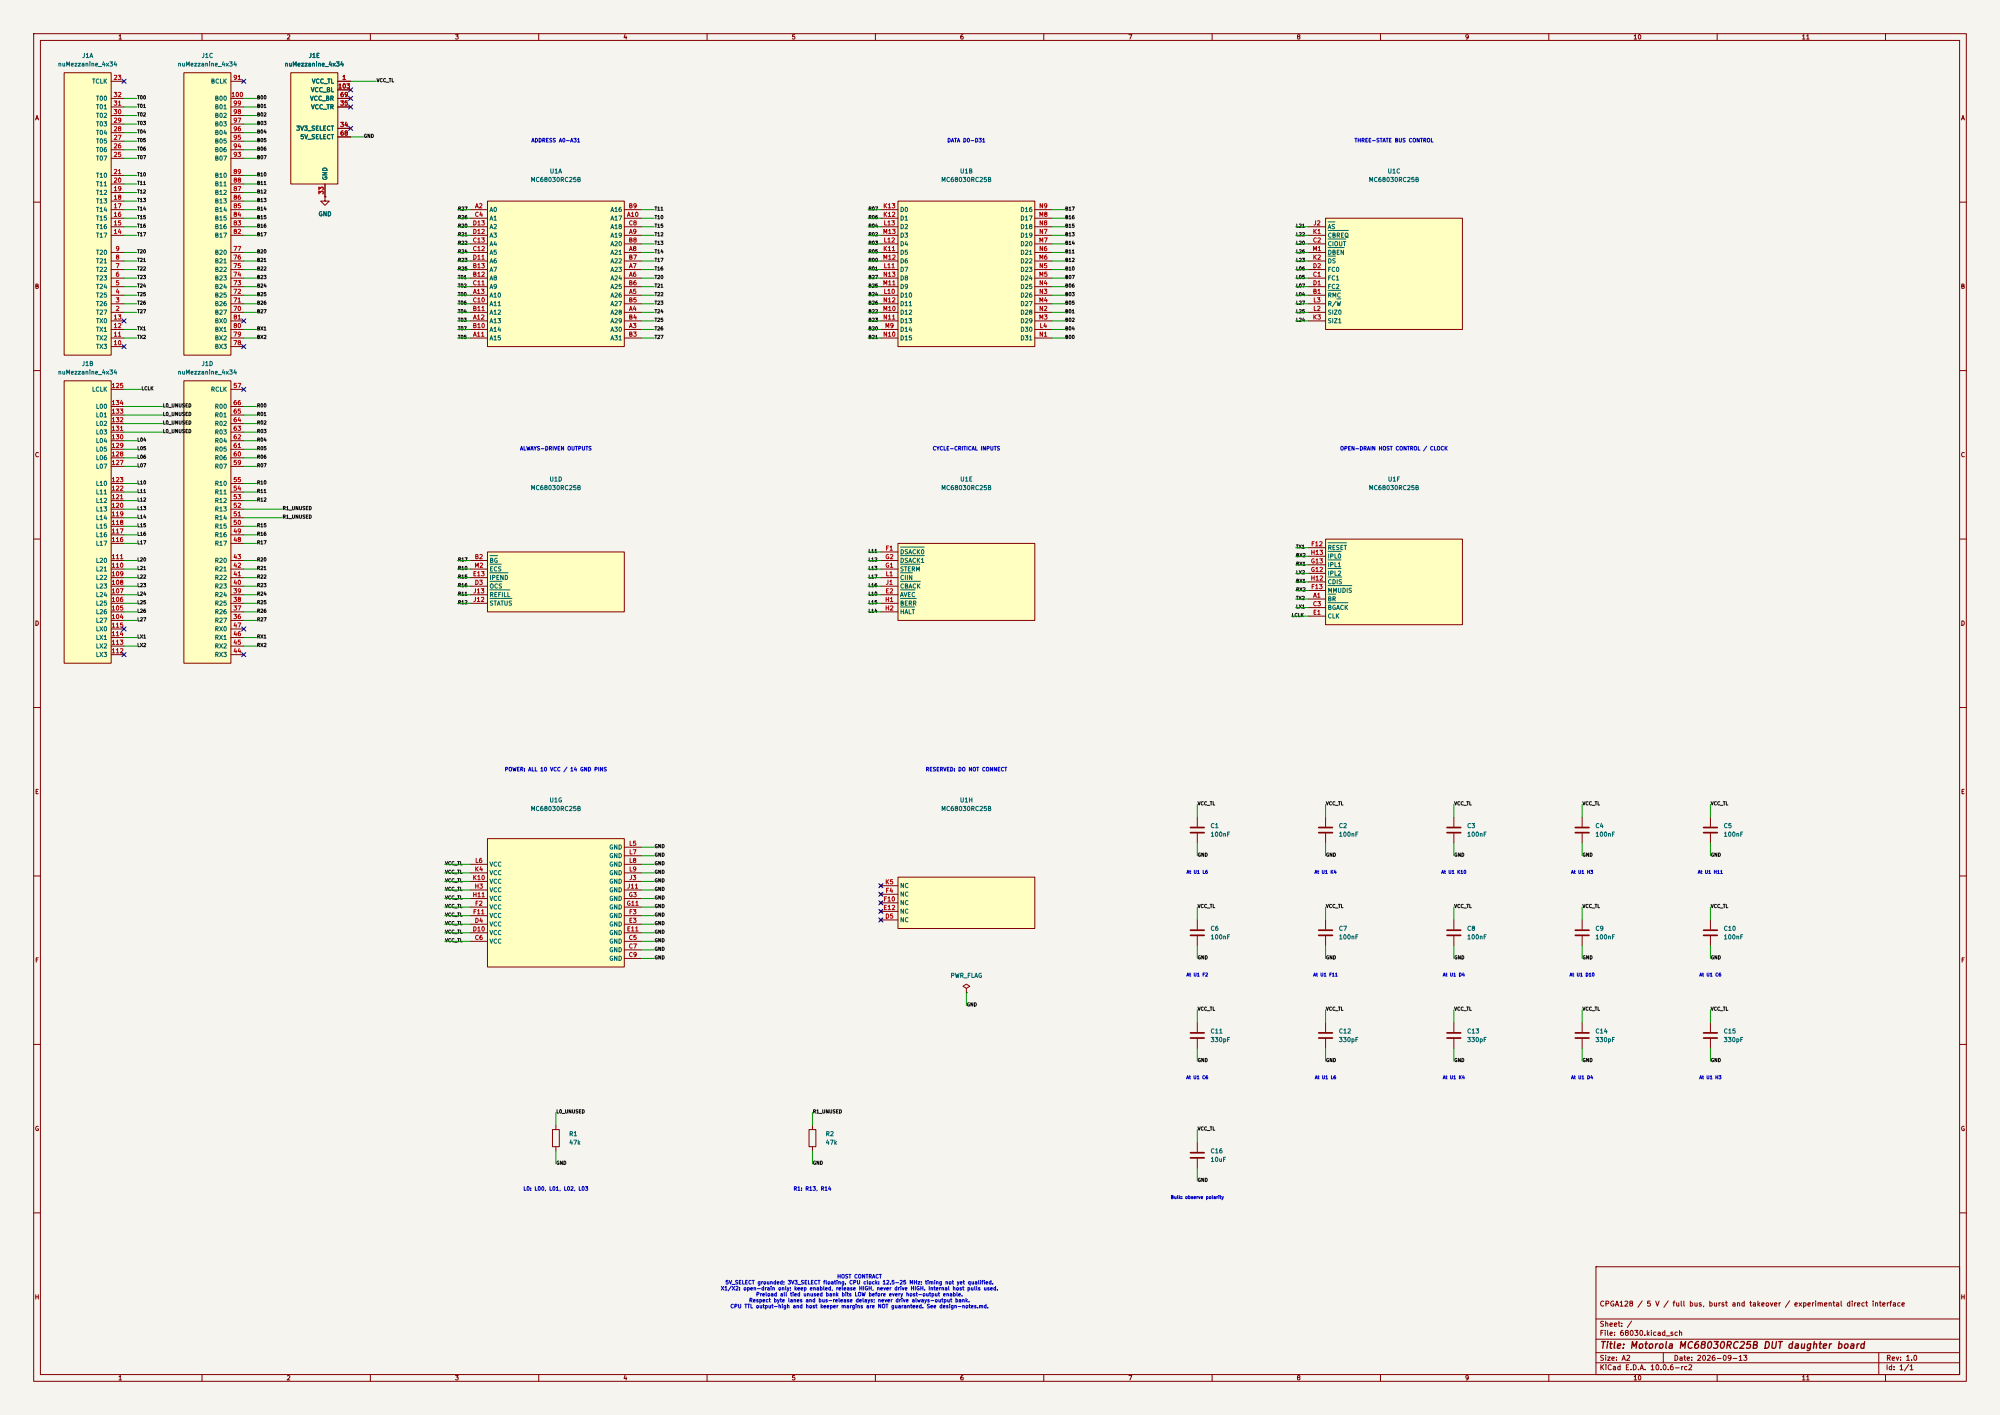
[picture p11: page 1]

DATA D0-D31 CYCLE-CRITICAL INPUTS

THREE-STATE BUS CONTROL

ALWAYS-DRIVEN OUTPUTS GND

OPEN-DRAIN HOST CONTROL / CLOCK

POWER: ALL 10 VCC / 14 GND PINS

At U1 C6 RESERVED: DO NOT CONNECT

At U1 L6 R1: R13, R14 HOST CONTRACT 5V_SELECT grounded; 3V3_SELECT floating. CPU clock: 12.5-25 MHz; timing not yet qualified. X1/X2: open-drain only; keep enabled, release HIGH, never drive HIGH. Internal host pulls used. Preload all tied unused bank bits LOW before every host-output enable. Respect byte lanes and bus-release delays; never drive always-output bank. CPU TTL output-high and host keeper margins are NOT guaranteed. See design-notes.md.

VCC_TL
Bulk: observe polarity At U1 C6

CPGA128 / 5 V / full bus, burst and takeover / experimental direct interface

Sheet: /
File: 68030.kicad_sch
Title: Motorola MC68030RC25B DUT daughter board

Size: A2 | Rev: 1.0
KiCad E.D.A. 10.0.6-rc2 | Id: 1/1
