wickerwaka/nuBoard/hardware/v33/reports/schematic.pdf

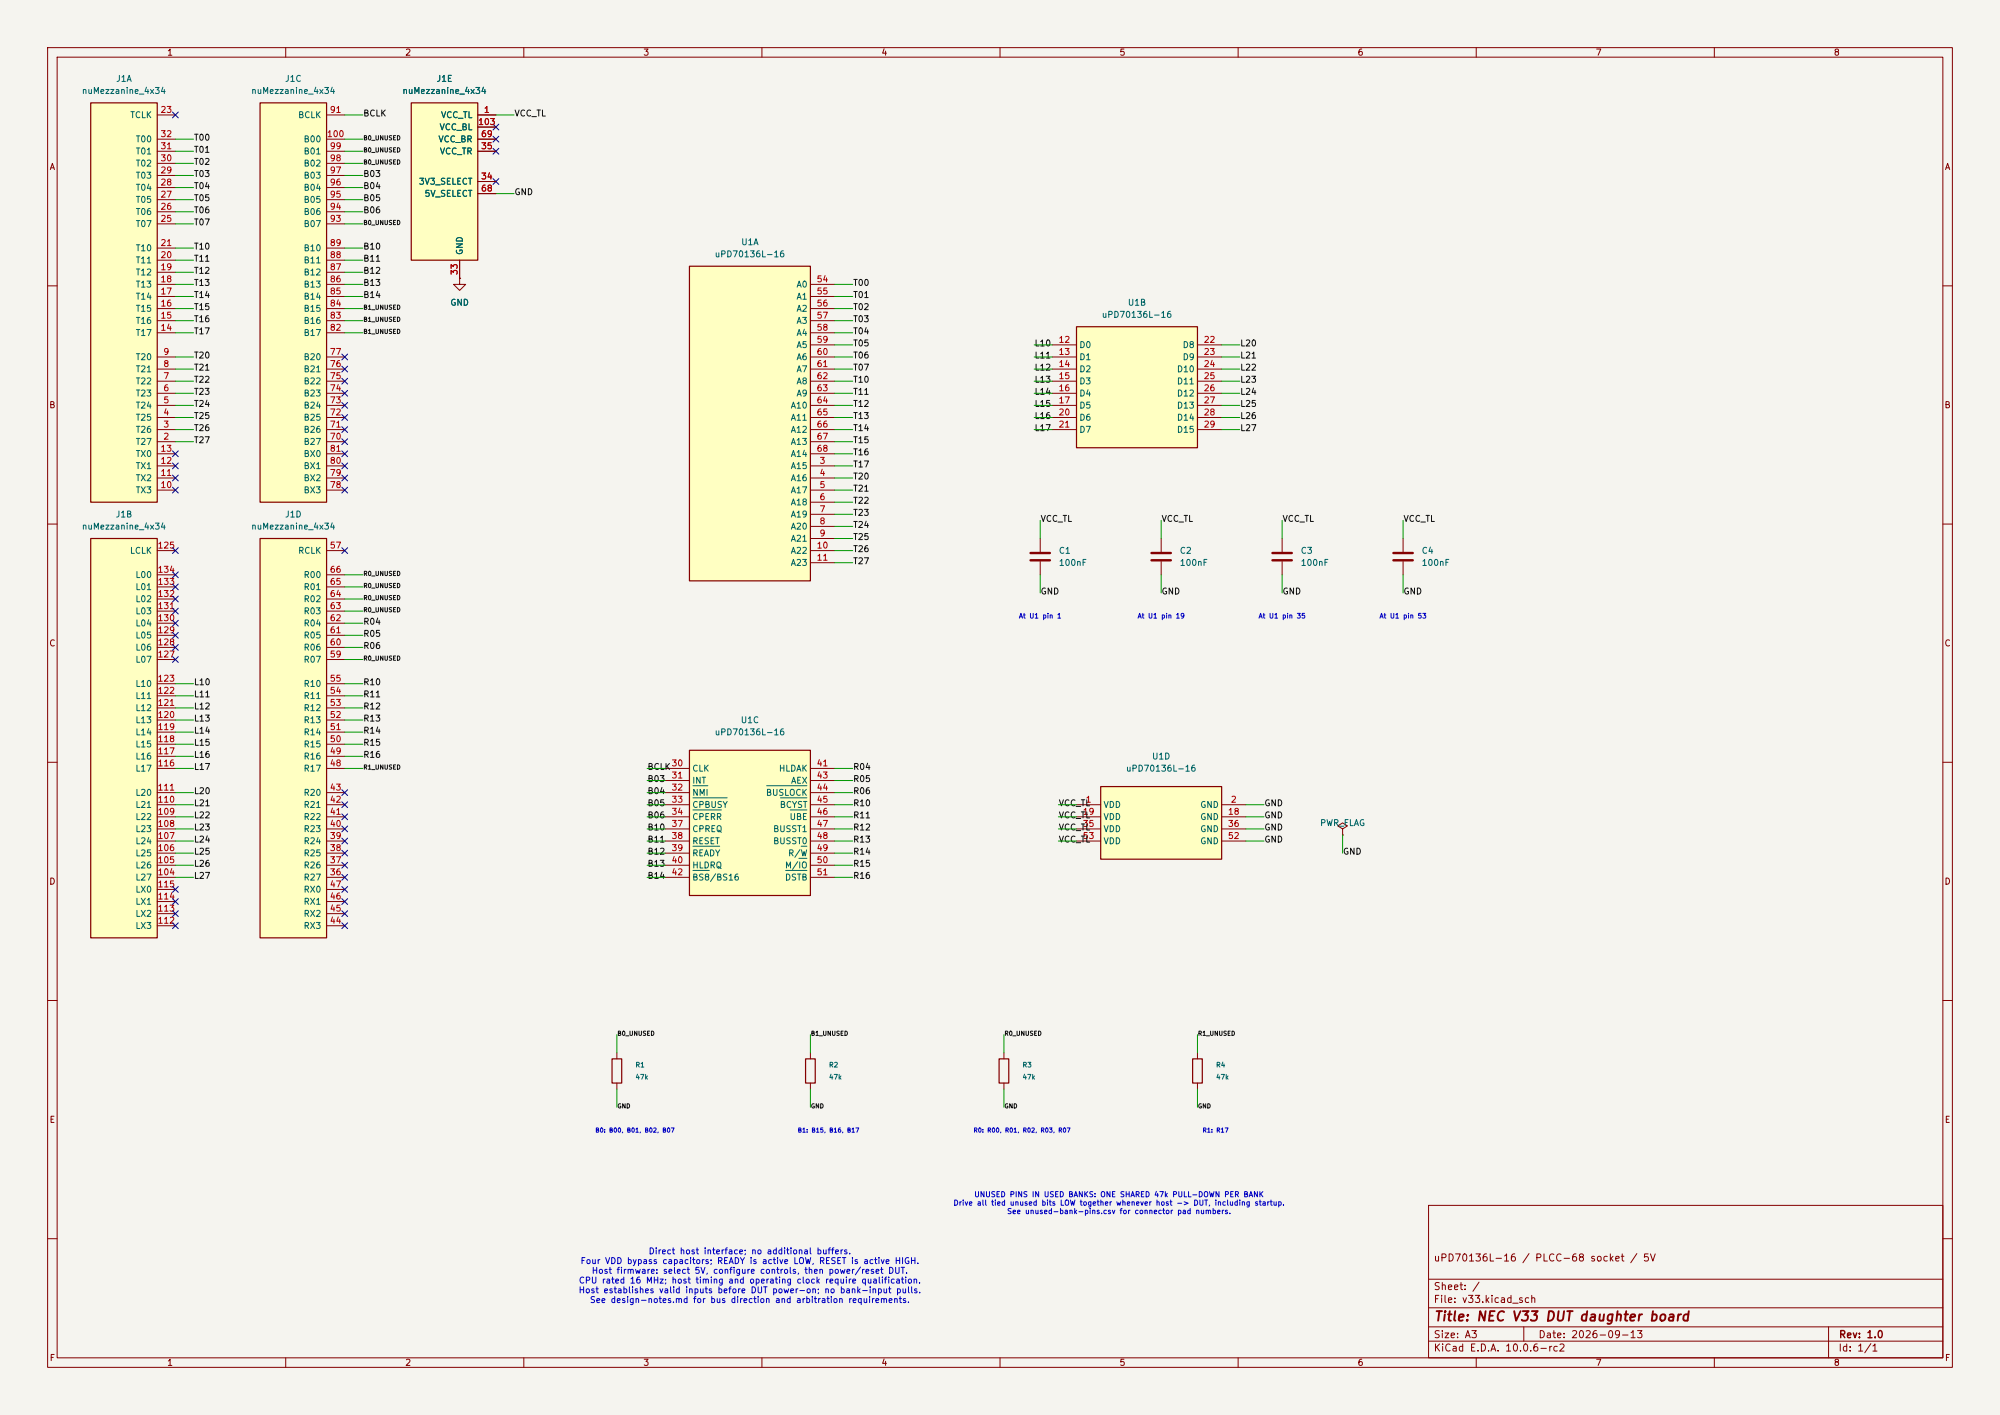
[picture p12: page 1]

UNUSED PINS IN USED BANKS: ONE SHARED 47k PULL-DOWN PER BANK

Direct host interface; no additional buffers. Four VDD bypass capacitors; READY is active LOW, RESET is active HIGH. Host firmware: select 5V, configure controls, then power/reset DUT. CPU rated 16 MHz; host timing and operating clock require qualification. Host establishes valid inputs before DUT power-on; no bank-input pulls. See design-notes.md for bus direction and arbitration requirements.

Sheet: /
File: v33.kicad_sch
Title: NEC V33 DUT daughter board

Size: A3 | Rev: 1.0 | F Date: 2026-09-13
KiCad E.D.A. 10.0.6-rc2 | Id: 1/1
