wickerwaka/nuBoard/hardware/v35s/reports/schematic.pdf

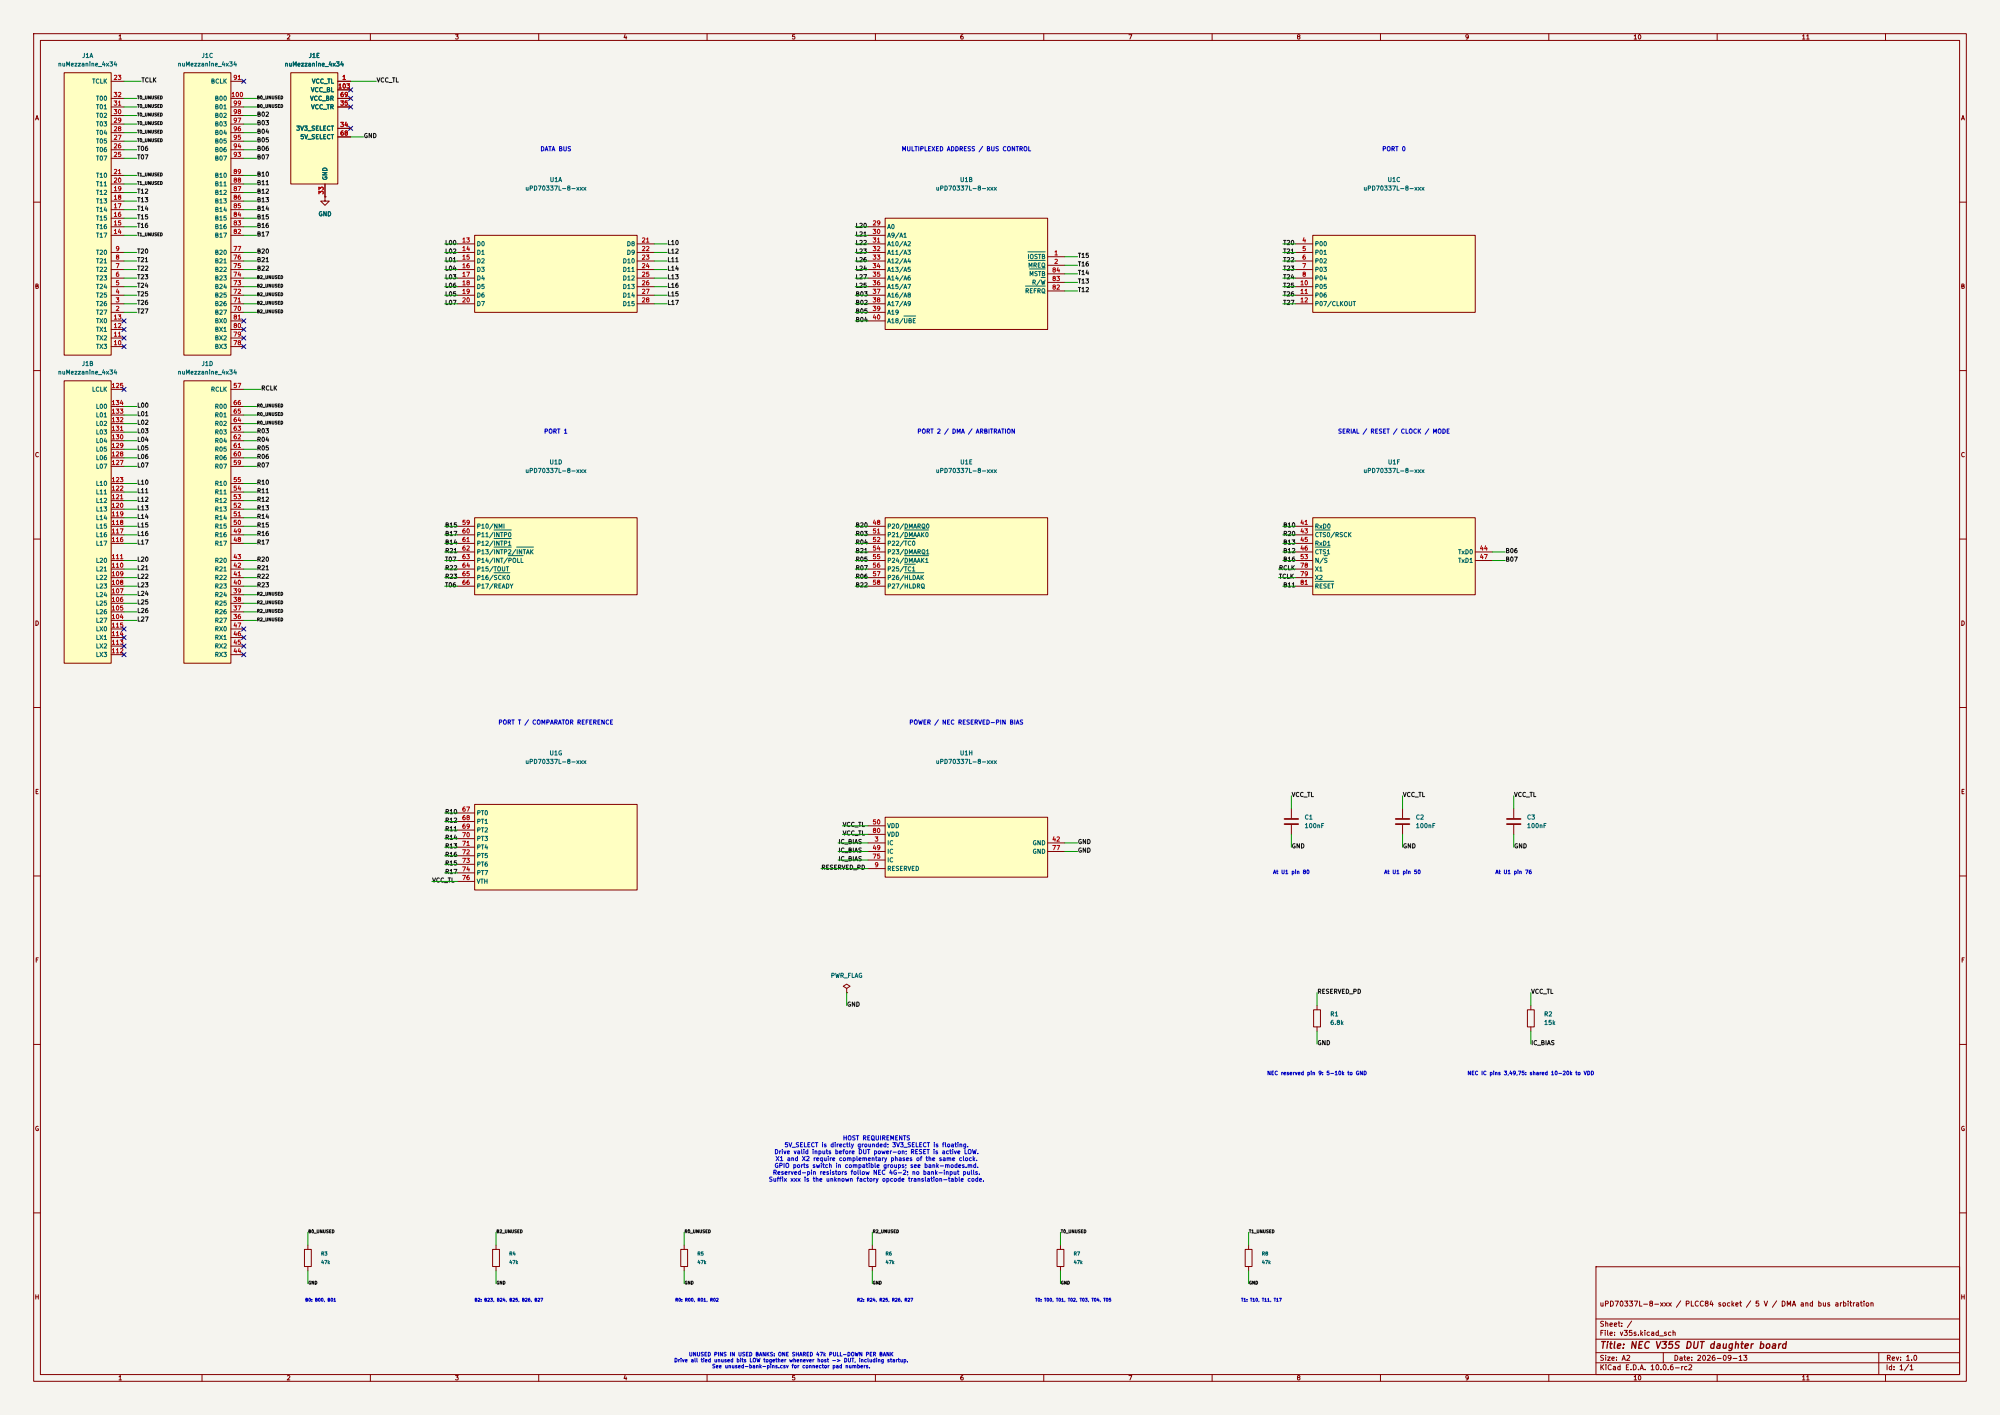
[picture p13: page 1]

MULTIPLEXED ADDRESS / BUS CONTROL

SERIAL / RESET / CLOCK / MODE

POWER / NEC RESERVED-PIN BIAS

At U1 pin 50 NEC reserved pin 9: 5-10k to GND

At U1 pin 76 NEC IC pins 3,49,75: shared 10-20k to VDD

5V_SELECT is directly grounded; 3V3_SELECT is floating. Drive valid inputs before DUT power-on; RESET is active LOW. X1 and X2 require complementary phases of the same clock. GPIO ports switch in compatible groups; see bank-modes.md. Reserved-pin resistors follow NEC 4G-2; no bank-input pulls. Suffix xxx is the unknown factory opcode translation-table code.

uPD70337L-8-xxx / PLCC84 socket / 5 V / DMA and bus arbitration

Sheet: /
File: v35s.kicad_sch
Title: NEC V35S DUT daughter board

Size: A2 | Rev: 1.0
KiCad E.D.A. 10.0.6-rc2 | Id: 1/1

Drive all tied unused bits LOW together whenever host -> DUT, including startup. See unused-bank-pins.csv for connector pad numbers.
