wickerwaka/nuBoard/hardware/z80/reports/schematic.pdf

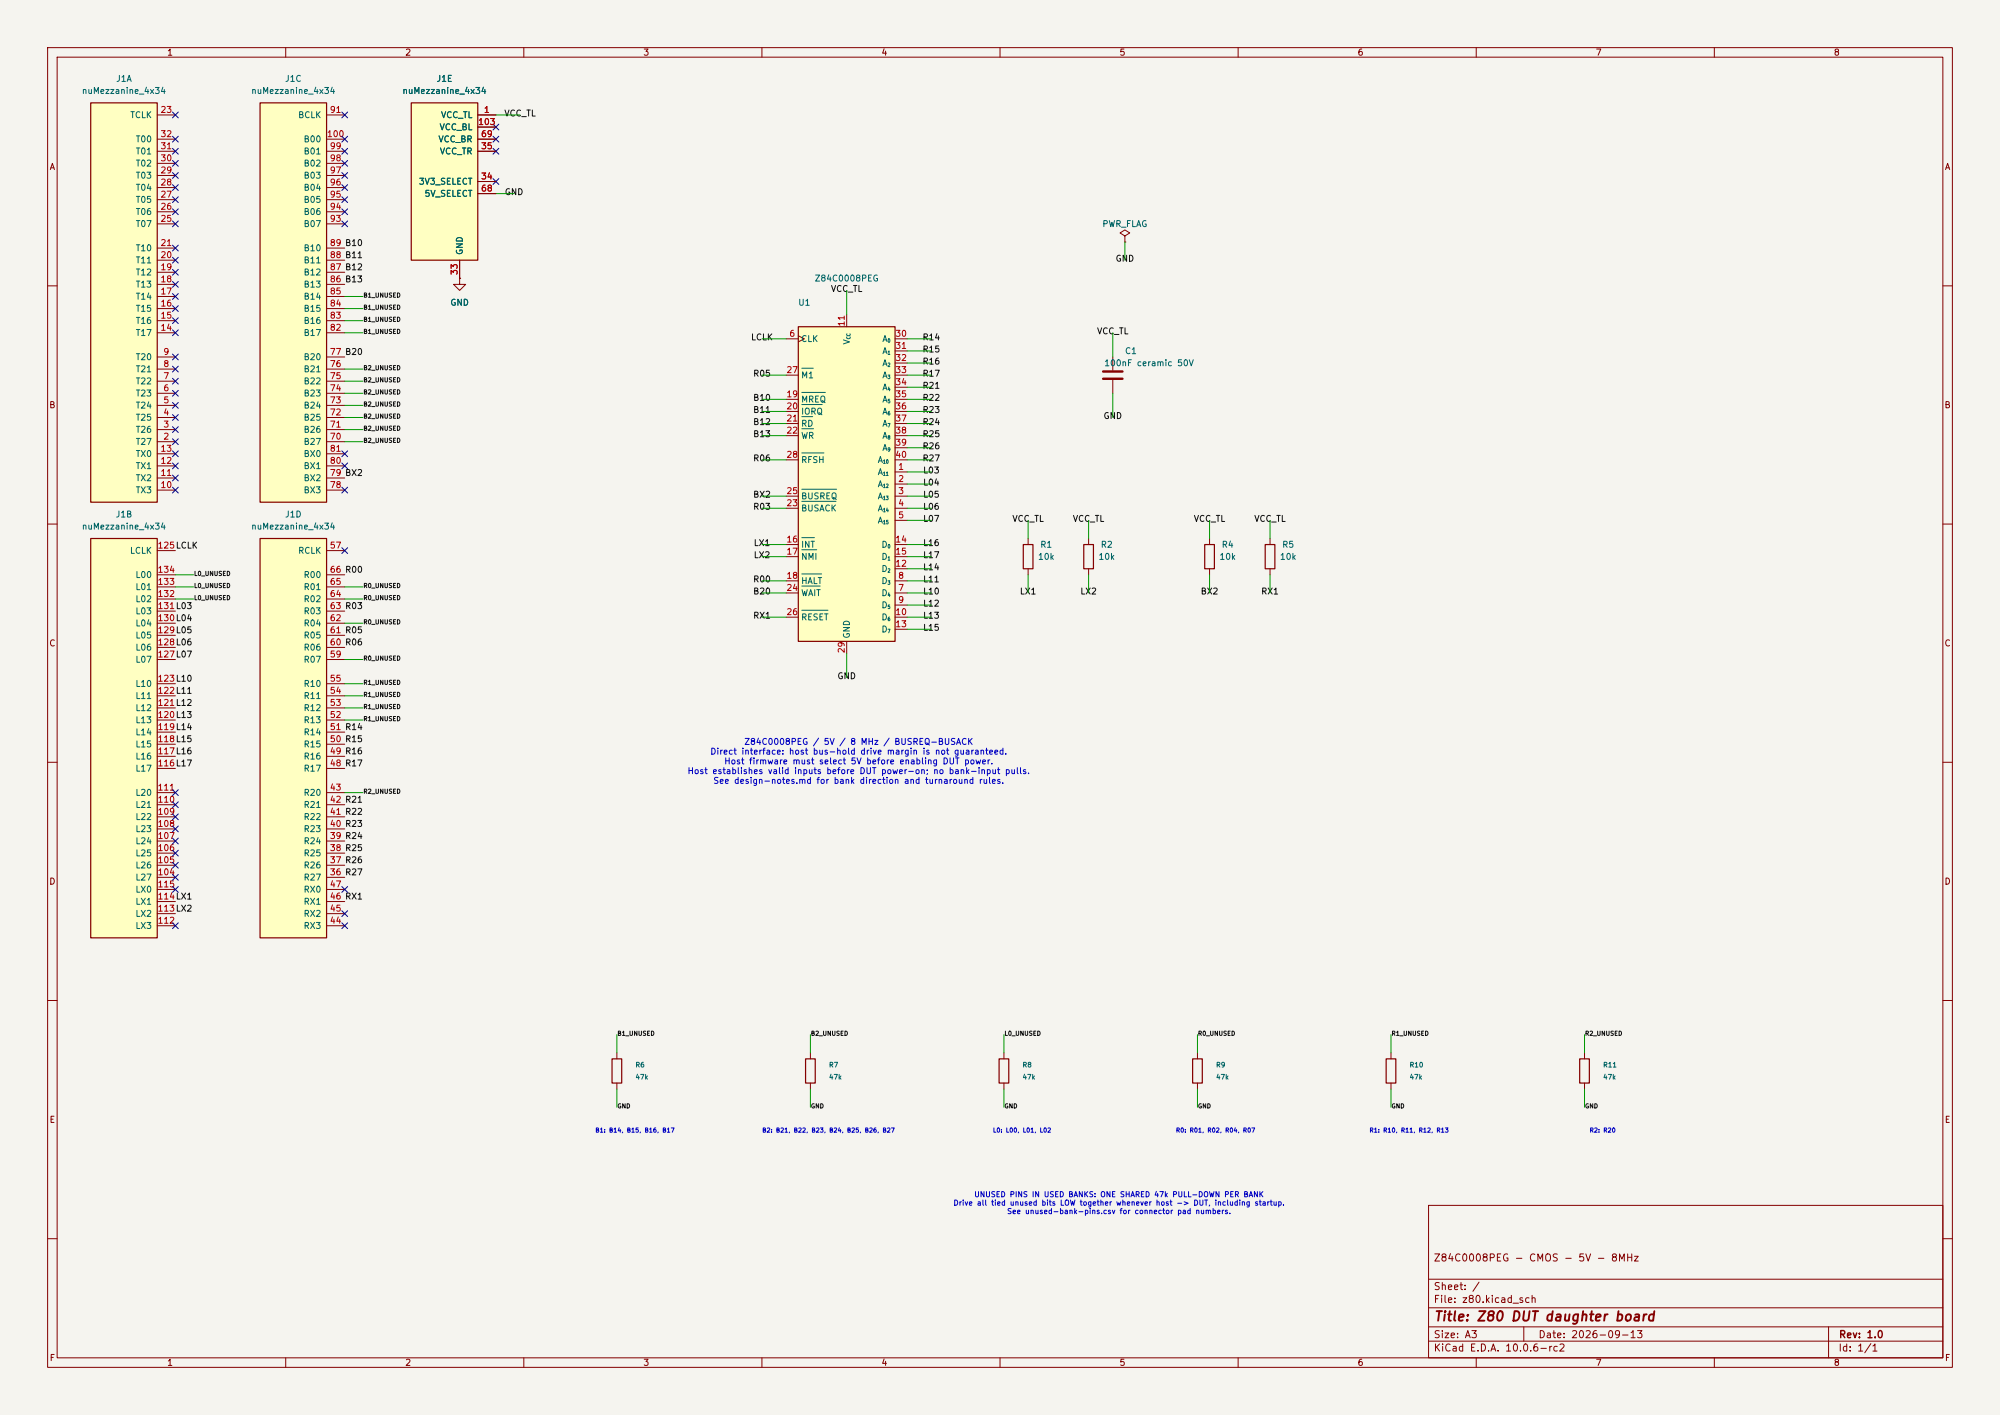
[picture p14: page 1]

VCC 11 D2 12 D7 13 D0 14 D1 15 INT 16 NMI 17 HALT 18 MREQ 19

Direct interface: host bus-hold drive margin is not guaranteed. Host firmware must select 5V before enabling DUT power. Host establishes valid inputs before DUT power-on; no bank-input pulls. See design-notes.md for bank direction and turnaround rules.

Sheet: /
File: z80.kicad_sch
Title: Z80 DUT daughter board

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
