wickerwaka/nuBoard/hardware/68030/reports/pcb.pdf

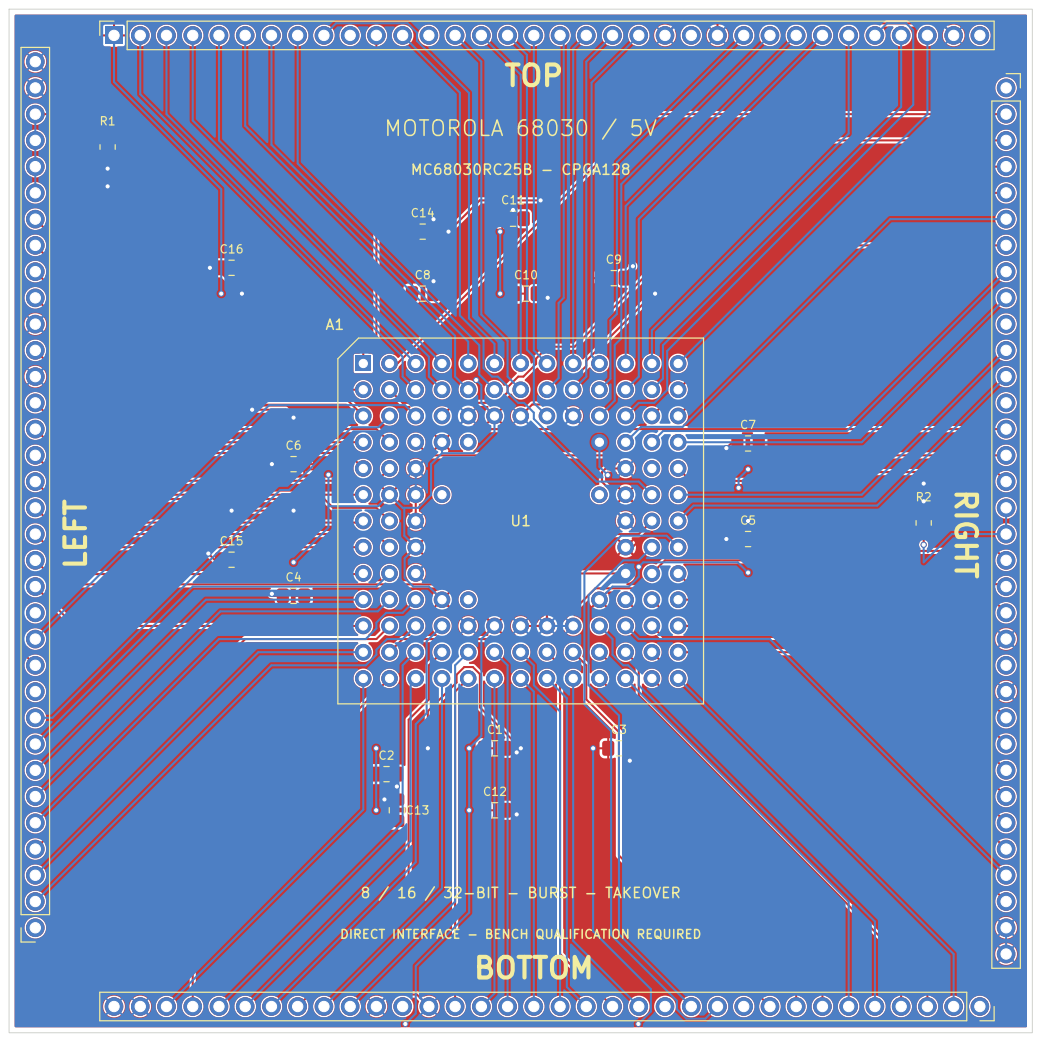
[picture p19: page 1]
