wickerwaka/nuBoard/hardware/v33/reports/pcb.pdf

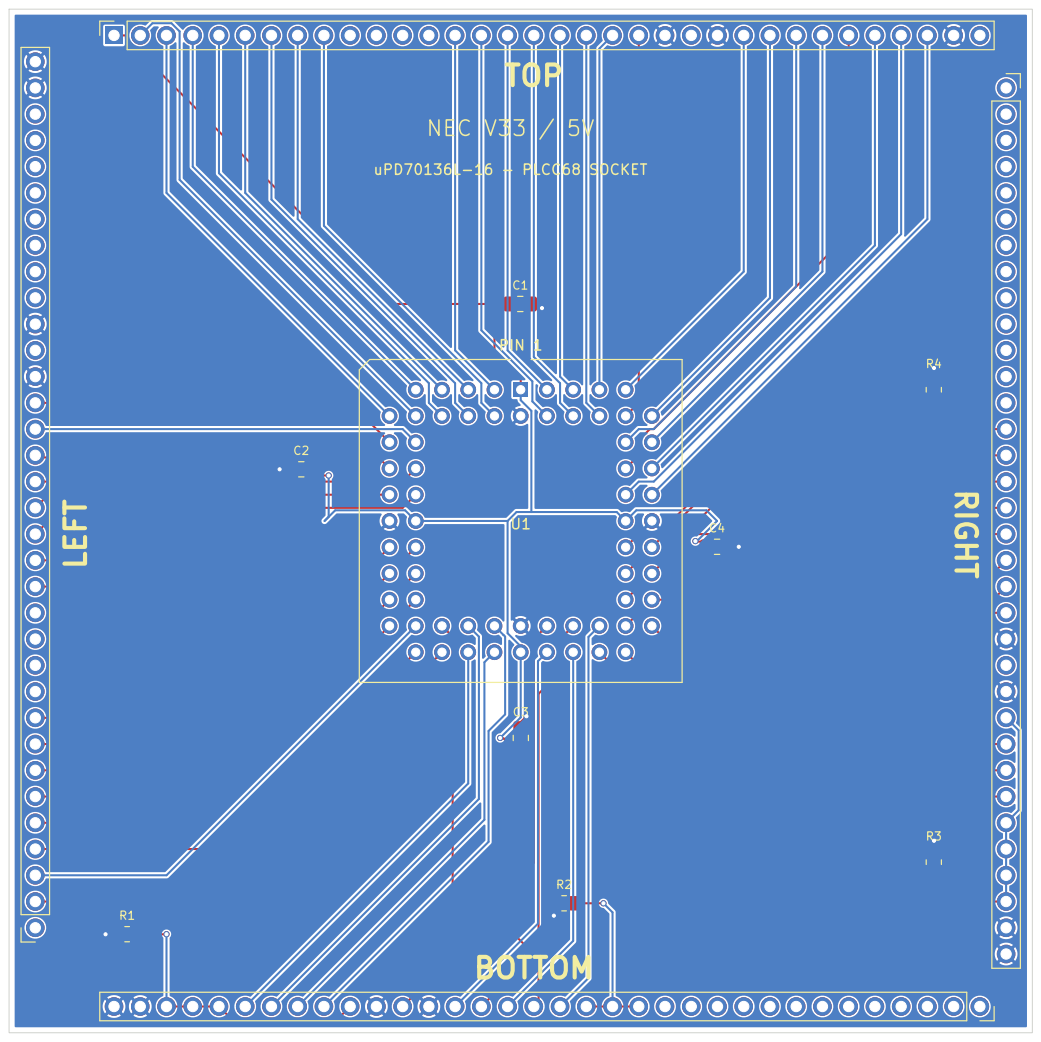
[picture p20: page 1]
