wickerwaka/nuBoard/hardware/v35s/reports/pcb.pdf

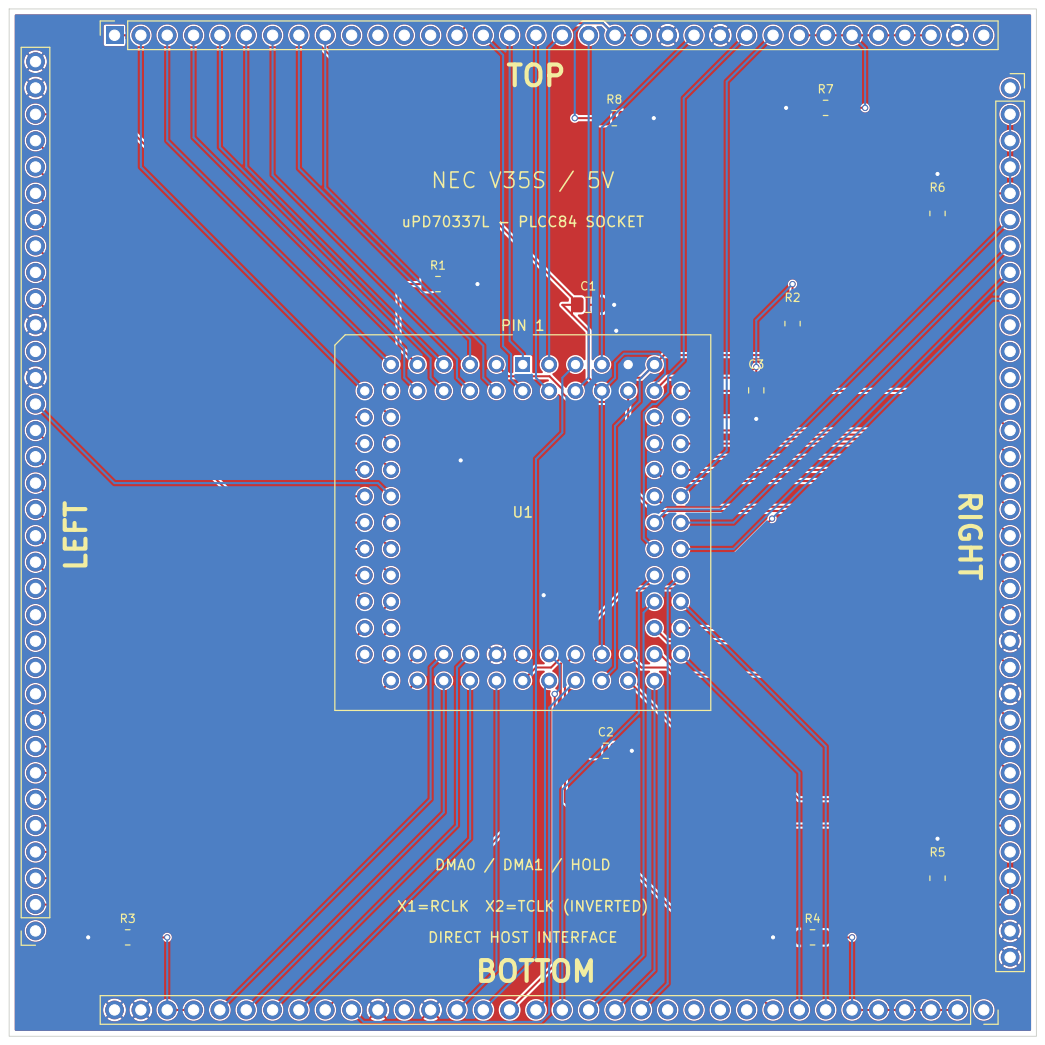
[picture p21: page 1]
