wickerwaka/nuBoard/hardware/z80/reports/pcb.pdf

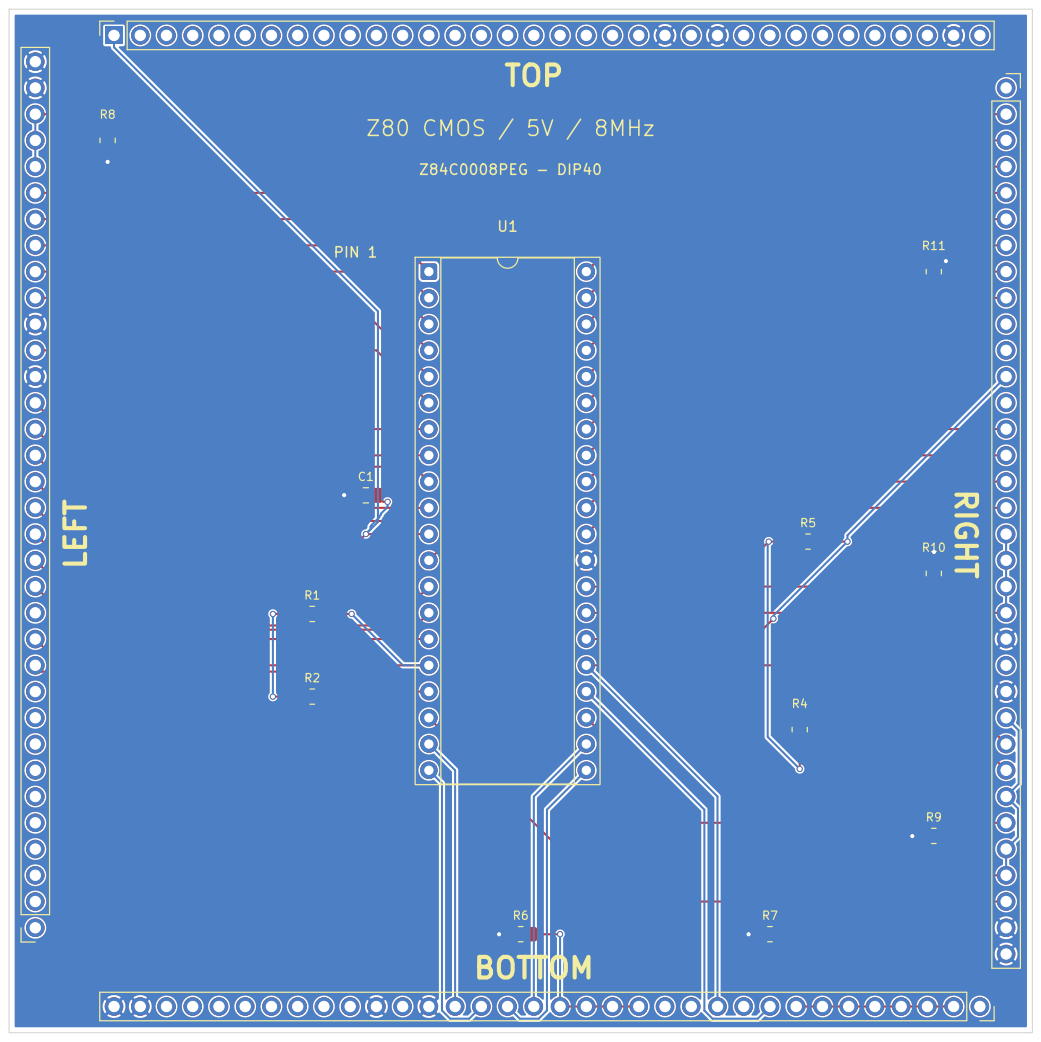
[picture p22: page 1]
