wickerwaka/nuBoard/hardware/main-board/nuBoard.kicad_pcb

## KiCad design hardware/main-board/nuBoard.kicad_pcb (2026-10-12)

Schematic: nuBoard.kicad_sch, nuBoard IC Investigator

Parts:
C1, C131: 4.7u; C_0402_1005Metric; JLCPCB Part C23733
C2, C3, C101, C104, C107, C110, C113, C116, C117, C132, C145, C146, C147, C148, C149, C150, C151, C152, C153, C154, C155, C156, C157, C158, C159, C160, C161, C162, C163, C164, C165, C166, C167, C168, C169, C170, C171, C172, C173, C174, C175, C176, C177, C178, C179, C180, C181, C182, C183, C184, C185, C186, C187, C188, C189, C190, C191, C192, C193, C194: 0.1u; C_0402_1005Metric; JLCPCB Part C1525
C4, C133, C134: 0.01u; C_0402_1005Metric; JLCPCB Part C15195
C5, C6, C7, C8, C9, C10, C11, C12, C13, C14, C15, C16, C17, C18, C19, C20, C21, C22, C23, C24, C25, C26, C27, C28, C29, C30, C31, C32, C33, C34, C35, C36, C37, C38, C39, C118, C119, C120, C121, C122, C123, C124, C125, C128, C129, C130: 0.1u 0201; C_0201_0603Metric; JLCPCB Part C5142565
C40, C41, C42, C43, C44, C45, C46, C47, C48, C49, C50, C51, C52, C53, C54, C55, C56, C57, C58, C59, C60, C61, C62, C63, C64, C65, C66, C67, C68, C69, C70, C71, C72, C73, C74, C75, C76, C77, C78, C79, C80, C81, C82, C83: 0.01u 0201; C_0201_0603Metric; JLCPCB Part C285010
C84, C85, C88, C89: 1u; C_0805_2012Metric; JLCPCB Part C28323
C86, C87, C90, C91, C93, C97, C100, C114, C115: 10u; C_0805_2012Metric; JLCPCB Part C15850
C92, C94, C95, C96, C98, C99, C126, C127: 1u; C_0402_1005Metric; JLCPCB Part C52923
C102, C103, C108, C109: 22u; C_0402_1005Metric; JLCPCB Part C22367823
C105, C106, C111, C112: 10u; C_0402_1005Metric; JLCPCB Part C315248
D1, D2, D3, D4: LED; LED_0603_1608Metric; JLCPCB Part C2286
FB1: 33ohm 100mhz; L_0402_1005Metric; JLCPCB Part C160974
H1, H2, H3, H4, H5, H6: MountingHole_Pad; MountingHole_3.2mm_M3_ISO7380
H7, H8, H9, H10, H11, H12, H13: MountingHole_Pad; MountingHole_3.2mm_M3
J1: FPGA Debug; PinHeader_2x05_P1.27mm_Vertical_SMD; JLCPCB Part C41376037
J2: Barrel_Jack_Switch; BarrelJack_Wuerth_6941xx301002
J3: USB_C_Receptacle_USB2.0_16P; USB_C_Receptacle_HCTL_HC-TYPE-C-16P-01A; JLCPCB Part C2894897
J4: MCU Debug; PinHeader_2x05_P1.27mm_Vertical_SMD; JLCPCB Part C41376037
J5, J6, J7, J8: Conn_01x34_Socket; PinSocket_1x34_P2.54mm_Vertical
L1, L2: 2.2uH; L_1008_2520Metric; JLCPCB Part C964122
Q1: NVF5P03T3G; SOT-223-3_TabPin2; JLCPCB Part C895162
Q2: BSR802NL6327; SOT-23; JLCPCB Part C5240463
R1, R2, R3, R4, R5, R6, R7, R8, R9, R10, R11, R13, R14, R15, R17, R18, R24, R27, R28, R31, R32, R33, R39, R40, R56, R57, R58, R59, R60, R61, R62, R63, R64, R65, R66, R67, R68, R70, R72, R74, R76, R77, R78, R79: 10K; R_0402_1005Metric; JLCPCB Part C25744
R12, R29, R30, R69, R71, R73, R75: 22; R_0402_1005Metric; JLCPCB Part C25092
R16, R19, R35, R38, R42, R43: 1K; R_0402_1005Metric; JLCPCB Part C11702
R20, R21: 5.1K; R_0402_1005Metric; JLCPCB Part C25905
R22: 33.2K 1%; R_0402_1005Metric; JLCPCB Part C122548
R23, R26: 10K 1%; R_0402_1005Metric; JLCPCB Part C25744
R25: 5.76K 1%; R_0402_1005Metric; JLCPCB Part C11590
R34: 400; R_0402_1005Metric; JLCPCB Part C2909358
R36, R37, R41: 27; R_0402_1005Metric; JLCPCB Part C25100
RN1, RN2, RN3, RN4, RN5, RN6, RN7, RN8, RN9, RN10, RN11, RN12, RN13, RN14, RN15, RN16, RN17, RN18, RN19, RN20, RN21, RN22, RN23, RN24: 22R; YC248-JR-0722RL; Manufacturer Part YC248-JR-0722RL; LCSC C695207
SW1: MCU_Reset; SW_SPST_Omron_B3FS-100xP; JLCPCB Part C271750
SW2: MCU_Boot; SW_SPST_Omron_B3FS-100xP; JLCPCB Part C271750
TP1: +5V; TestPoint_Pad_D1.0mm
TP2: +3.3V; TestPoint_Pad_D1.0mm
TP3: +1.2V; TestPoint_Pad_D1.0mm
TP4: VCC_DUT; TestPoint_Pad_D1.0mm
TP5: VCCB; TestPoint_Pad_D1.0mm
U1: T120F484; LFBGA-484_18x18mm_Layout22x22_P0.8mm; JLCPCB Part C3277977
U2: IS66WVH8M8BLL-100B1LI; ISSI_TFBGA-24_6x8mm_P1.0mm; JLCPCB Part C1349096
U3: TPS2116DRL; SOT-583-8; JLCPCB Part C3235557
U4, U5: AP2112K-3.3; SOT-23-5; JLCPCB Part C23380830
U6, U7: TPS563201; SOT-23-6; JLCPCB Part C116592
U8: UCC27524D; SOIC-8_3.9x4.9mm_P1.27mm; JLCPCB Part C465729
U9: TPS2111APWR; SOP65P640X120-8N; JLCPCB Part C471060
U10: W25Q128JVS; SOIC-8_5.3x5.3mm_P1.27mm; JLCPCB Part C97521
U11: RP2040; QFN-56-1EP_7x7mm_P0.4mm_EP3.2x3.2mm; JLCPCB Part C2040
U24, U25, U26, U27, U28, U29, U30, U31, U32, U33, U34, U35: SN74LVC8T245PWR; TSSOP-24_4.4x7.8mm_P0.65mm; JLCPCB Part C27643
U36, U41: TXS0108EPW; TSSOP-20_4.4x6.5mm_P0.65mm; JLCPCB Part C17206
U37, U38, U39, U40: SN74LVC1T45DRL; SOT-563; JLCPCB Part C352970
Y1: 50Mhz; Oscillator_SMD_Abracon_ASE-4Pin_3.2x2.5mm; JLCPCB Part C717684
Y2: 12Mhz; Oscillator_SMD_Abracon_ASE-4Pin_3.2x2.5mm; JLCPCB Part C596950

Connections:
+1.1V_MCU: C127.1, C128.1, C129.1, U11.23 (DVDD), U11.45 (VREG_VOUT), U11.50 (DVDD)
+1.2V: C5.1, C6.1, C7.1, C8.1, C9.1, C10.1, C11.1, C12.1, C13.1, C14.1, C15.1, C16.1, C17.1, C18.1, C19.1, C20.1, C21.1, C40.1, C41.1, C42.1, C43.1, C44.1, C45.1, C46.1, C47.1, C48.1, C49.1, C50.1, C51.1, C52.1, C53.1, C54.1, C55.1, C56.1, C57.1, C58.1, C59.1, C60.1, C61.1, C62.1, C63.1, C64.1, C65.1, C66.1, C67.1, C84.1, C85.1, C86.1, C87.1, C108.1, C109.1, L2.2, R25.1, TP3.1 (1_1), U1.D5 (VCCA_TL), U1.D17 (VCCA_TR), U1.E17 (VCCA_TR), U1.H10 (VCC), U1.J9 (VCC), U1.J11 (VCC), U1.J13 (VCC), U1.J15 (VCC), U1.K10 (VCC), U1.K12 (VCC), U1.K14 (VCC), U1.L9 (VCC), U1.L11 (VCC), U1.L13 (VCC), U1.M8 (VCC), U1.M10 (VCC), U1.M12 (VCC), U1.M14 (VCC), U1.N9 (VCC), U1.N11 (VCC), U1.N13 (VCC), U1.N15 (VCCA_BR), U1.P10 (VCC), U1.P12 (VCC), U1.P14 (VCC), U1.P15 (VCCA_BR), U1.R11 (VCC), U1.W5 (VCCA_BL)
+3.3V: C3.1, C4.1, C22.1, C23.1, C24.1, C25.1, C26.1, C27.1, C28.1, C29.1, C30.1, C31.1, C32.1, C33.1, C34.1, C35.1, C36.1, C37.1, C38.1, C39.1, C68.1, C69.1, C70.1, C71.1, C72.1, C73.1, C74.1, C75.1, C76.1, C77.1, C78.1, C79.1, C80.1, C81.1, C82.1, C83.1, C88.1, C89.1, C90.1, C91.1, C102.1, C103.1, C133.1, C134.1, C145.1, C148.1, C151.1, C154.1, C157.1, C160.1, C163.1, C166.1, C169.1, C172.1, C175.1, C178.1, C181.1, C183.1, C185.1, C187.1, C189.1, C191.1, C192.1, C193.1, FB1.2, J1.1, L1.2, R1.1, R2.1, R3.1, R4.1, R5.1, R6.1, R7.1, R8.1, R9.1, R10.1, R11.1, R13.1, R14.1, R15.1, R22.1, R28.1, R56.1, R57.1, R58.1, R59.1, R60.1, R61.1, R62.1, R63.1, R64.1, R65.1, R66.1, R67.1, R68.1, R77.1, R78.1, R79.1, TP2.1 (1_1), U1.AA4 (VCCIO4F), U1.AA14 (VCCIO4B), U1.B3 (VCCIO2A), U1.B18 (VCCIO3D_TR_BR), U1.C8 (VCCIO2B), U1.C9 (VCCIO2C), U1.C14 (VCCIO2E), U1.C17 (VCCIO2F), U1.C20 (VCCIO3D_TR_BR), U1.D3 (VCCIO2A), U1.D6 (VCCIO2B), U1.D12 (VCCIO2D), U1.F2 (VCCIO1F_1G), U1.F3 (VCCIO1F_1G), U1.F9 (VCCIO2C), U1.F11 (VCCIO2D), U1.F14 (VCCIO2E), U1.G16 (VCCIO2F), U1.J6 (VCCIO1D_1E), U1.K3 (VCCIO1D_1E), U1.N3 (VCCIO1B_1C), U1.N6 (VCCIO1B_1C), U1.R5 (VCCIO1B_1C), U1.R9 (VCCIO4E), U1.T9 (VCCIO4D), U1.T11 (VCCIO4C), U1.U3 (VCCIO1A), U1.U15 (VCCIO4A), U1.V13 (VCCIO4B), U1.W7 (VCCIO4E), U1.Y3 (VCCIO4F), U1.Y9 (VCCIO4D), U1.Y12 (VCCIO4C), U1.Y16 (VCCIO4A), U2.B4 (VCC), U2.D1 (VCCQ), U2.E4 (VCCQ), U24.1 (VCCA), U25.1 (VCCA), U26.1 (VCCA), U27.1 (VCCA), U28.1 (VCCA), U29.1 (VCCA), U30.1 (VCCA), U31.1 (VCCA), U32.1 (VCCA), U33.1 (VCCA), U34.1 (VCCA), U35.1 (VCCA), U36.2 (VCCA), U37.1 (VCCA), U38.1 (VCCA), U39.1 (VCCA), U40.1 (VCCA), U41.2 (VCCA)
+3.3V_DUT: C99.1, C100.1, C116.1, R32.1, R33.1, U5.5 (VOUT), U9.8 (IN1)
+3.3V_MCU: C96.1, C97.1, C118.1, C119.1, C120.1, C121.1, C122.1, C123.1, C124.1, C125.1, C126.1, C130.1, C131.1, C132.1, J4.1, R39.1, R40.1, R42.2, R43.2, U4.5 (VOUT), U10.8 (VCC), U11.1 (IOVDD), U11.10 (IOVDD), U11.22 (IOVDD), U11.33 (IOVDD), U11.42 (IOVDD), U11.43 (ADC_AVDD), U11.44 (VREG_VIN), U11.48 (USB_VDD), U11.49 (IOVDD), Y2.1 (EN), Y2.4 (Vdd)
+5V: C93.1, C95.1, C98.1, C104.1, C105.1, C106.1, C110.1, C111.1, C112.1, C113.1, C114.1, C117.1, TP1.1 (1_1), U3.2 (VOUT), U3.7 (VOUT), U4.1 (VIN), U4.3 (EN), U5.1 (VIN), U5.3 (EN), U6.3 (VIN), U7.3 (VIN), U8.6 (V_{DD}), U9.6 (IN2)
/3V3_SELECT: J6.1, R40.2, U11.32 (GPIO21)
/5V_SELECT: J7.1, R39.2, U11.31 (GPIO20)
/B00: J8.3, RN20.9
/B01: J8.4, RN20.10
/B02: J8.5, RN20.11
/B03: J8.6, RN20.12
/B04: J8.7, RN20.13
/B05: J8.8, RN20.14
/B06: J8.9, RN20.15
/B07: J8.10, RN20.16
/B10: J8.14, RN22.9
/B11: J8.15, RN22.10
/B12: J8.16, RN22.11
/B13: J8.17, RN22.12
/B14: J8.18, RN22.13
/B15: J8.19, RN22.14
/B16: J8.20, RN22.15
/B17: J8.21, RN22.16
/B20: J8.26, RN24.9
/B21: J8.27, RN24.10
/B22: J8.28, RN24.11
/B23: J8.29, RN24.12
/B24: J8.30, RN24.13
/B25: J8.31, RN24.14
/B26: J8.32, RN24.15
/B27: J8.33, RN24.16
/BCLK: J8.12, R75.2
/BX0: J8.22, U36.12 (B8)
/BX1: J8.23, U36.13 (B7)
/BX2: J8.24, U36.14 (B6)
/BX3: J8.25, U36.15 (B5)
/DUT_CROWBAR: R30.1, U1.E1 (GPIOT_TXN01)
/DUT_ISOLATE: R29.1, U1.E5 (GPIOL_162_EXTFB)
/FPGA_1V2_EN: R27.1, U7.5 (EN), U11.36 (GPIO24)
/FPGA_3V3_EN: R24.1, U6.5 (EN), U11.37 (GPIO25)
/FPGA_CBUS0: R5.2, U1.U4 (GPIOL_11_CBUS0), U11.14 (GPIO11)
/FPGA_CBUS1: R6.2, U1.U6 (GPIOL_12_CBUS1), U11.15 (GPIO12)
/FPGA_CBUS2: R7.2, U1.T4 (GPIOL_13_CBUS2), U11.16 (GPIO13)
/FPGA_CCK: U1.W1 (GPIOL_01_CCK), U11.6 (GPIO4)
/FPGA_CDI0: U1.V2 (GPIOL_08_CDI0), U11.2 (GPIO0)
/FPGA_CDI1: U1.V1 (GPIOL_09_CDI1), U11.3 (GPIO1)
/FPGA_CDI2: U1.T6 (GPIOL_14_CDI2), U11.4 (GPIO2)
/FPGA_CDI3: U1.R8 (GPIOL_16_CDI3), U11.5 (GPIO3)
/FPGA_CDONE: R1.2, U1.V5 (CDONE), U11.11 (GPIO8)
/FPGA_CLK_IN: R12.2, U1.A18 (GPIOR_167_PLLIN1), U1.A20 (GPIOR_174_CLK15)
/FPGA_CRESET_N: J1.10, R2.2, U1.V4 (CRESET_N), U11.9 (GPIO7)
/FPGA_CSI: R4.2, U1.V6 (GPIOL_04_CSI), U11.7 (GPIO5)
/FPGA_CSO: U1.U5 (GPIOL_05_CSO), U11.8 (GPIO6)
/FPGA_NSTATUS: U1.F5 (GPIOL_150_NSTATUS), U11.13 (GPIO10)
/FPGA_SS_N: R3.2, U1.V3 (GPIOL_00_SS_N), U11.12 (GPIO9)
/FPGA_TCK: J1.4, R8.2, U1.T1 (TCK), U11.17 (GPIO14)
/FPGA_TDI: J1.8, R9.2, U1.U2 (TDI), U11.18 (GPIO15)
/FPGA_TDO: J1.6, R10.2, U1.T3 (TDO), U11.27 (GPIO16)
/FPGA_TMS: J1.2, R11.2, U1.U1 (TMS), U11.28 (GPIO17)
/F_B00: RN19.8, U1.W2 (GPIOB_TXP04_CDI29)
/F_B0_DIR: U1.Y4 (GPIOB_TXP03_CDI31), U33.2 (DIR)
/F_B01: RN19.7, U1.W3 (GPIOB_TXN04_CDI28)
/F_B1_DIR: U1.V7 (GPIOB_TXP15_CDI15), U34.2 (DIR)
/F_B02: RN19.6, U1.Y1 (GPIOB_TXN05_CDI26)
/F_B2_DIR: U1.W11 (GPIOB_RXP03), U35.2 (DIR)
/F_B03: RN19.5, U1.AA1 (GPIOB_TXP05_CDI27)
/F_B04: RN19.4, U1.AA2 (GPIOB_TXN06_CDI24)
/F_B05: RN19.3, U1.AB2 (GPIOB_TXP06_CDI25)
/F_B06: RN19.2, U1.AB3 (GPIOB_TXP07_CDI23)
/F_B07: RN19.1, U1.W4 (GPIOB_TXN03_CDI30)
/F_B10: RN21.8, U1.AB6 (GPIOB_TXP14_CDI17)
/F_B11: RN21.7, U1.AA6 (GPIOB_TXN14_CDI16)
/F_B12: RN21.6, U1.Y6 (GPIOB_TXP13_CDI19)
/F_B13: RN21.5, U1.AB7 (GPIOB_TXP16_CDI13)
/F_B14: RN21.4, U1.AA7 (GPIOB_TXN16_CDI12)
/F_B15: RN21.3, U1.Y7 (GPIOB_TXN13_CDI18)
/F_B16: RN21.2, U1.AA8 (GPIOB_TXN22)
/F_B17: RN21.1, U1.W8 (GPIOB_TXP17_CDI11)
/F_B20: RN23.8, U1.AB11 (GPIOB_RXP00)
/F_B21: RN23.7, U1.AA11 (GPIOB_RXN00)
/F_B22: RN23.6, U1.R4 (GPIOL_19_PLLIN1)
/F_B23: RN23.5, U1.AB12 (GPIOB_RXN05)
/F_B24: RN23.4, U1.AA12 (GPIOB_RXP05)
/F_B25: RN23.3, U1.W12 (GPIOB_RXN08_EXTFB0)
/F_B26: RN23.2, U1.V12 (GPIOB_RXP08_EXTFB0)
/F_B27: RN23.1, U1.AA13 (GPIOB_RXN10)
/F_BCLK: U1.AA5 (GPIOB_TXP08_CDI21), U40.3 (A)
/F_BCLK_EN: R76.1, U1.AB5 (GPIOB_TXN08_CDI20), U40.5 (DIR)
/F_BX0: U1.AB8 (GPIOB_TXP22), U36.9 (A8)
/F_BX1: U1.AA9 (GPIOB_TXN24), U36.8 (A7)
/F_BX2: U1.W9 (GPIOB_TXN19), U36.7 (A6)
/F_BX3: U1.AB10 (GPIOB_TXP26), U36.6 (A5)
/F_L00: RN1.8, U1.A3 (GPIOT_TXN06)
/F_L0_DIR: U1.E3 (GPIOL_160_PLLIN1), U24.2 (DIR)
/F_L01: RN1.7, U1.A2 (GPIOT_TXP05)
/F_L1_DIR: U1.L5 (GPIOL_71_CLK5), U25.2 (DIR)
/F_L02: RN1.6, U1.B2 (GPIOT_TXN05)
/F_L2_DIR: U1.R2 (GPIOL_15_PLLIN0), U26.2 (DIR)
/F_L03: RN1.5, U1.B1 (GPIOT_TXN04)
/F_L04: RN1.4, U1.C2 (GPIOT_TXN02)
/F_L05: RN1.3, U1.C1 (GPIOT_TXP04)
/F_L06: RN1.2, U1.D2 (GPIOT_TXP02)
/F_L07: RN1.1, U1.D1 (GPIOT_TXP01)
/F_L10: RN3.8, U1.H6 (GPIOL_123)
/F_L11: RN3.7, U1.H4 (GPIOL_121)
/F_L12: RN3.6, U1.J7 (GPIOL_115)
/F_L13: RN3.5, U1.J5 (GPIOL_85)
/F_L14: RN3.4, U1.J4 (GPIOL_88)
/F_L15: RN3.3, U1.K5 (GPIOL_81)
/F_L16: RN3.2, U1.K4 (GPIOL_79)
/F_L17: RN3.1, U1.L6 (GPIOL_72_CLK6)
/F_L20: RN5.8, U1.N4 (GPIOL_56)
/F_L21: RN5.7, U1.M4 (GPIOL_64_CTRL2)
/F_L22: RN5.6, U1.N1 (GPIOL_62_CTRL0)
/F_L23: RN5.5, U1.N2 (GPIOL_63_CTRL1)
/F_L24: RN5.4, U1.P1 (GPIOL_52)
/F_L25: RN5.3, U1.P2 (GPIOL_50)
/F_L26: RN5.2, U1.P3 (GPIOL_51)
/F_L27: RN5.1, U1.R1 (GPIOL_49)
/F_LCLK: U1.G5 (GPIOL_147), U37.3 (A)
/F_LCLK_EN: R70.1, U1.G4 (GPIOL_138), U37.5 (DIR)
/F_LX0: U1.D9 (GPIOT_TXN21), U41.6 (A5)
/F_LX1: U1.E10 (GPIOT_TXN24), U41.7 (A6)
/F_LX2: U1.E12 (GPIOT_RXN09_CLKN0), U41.8 (A7)
/F_LX3: U1.F10 (GPIOT_TXP26), U41.9 (A8)
/F_R00: RN13.8, U1.AB13 (GPIOB_RXP10)
/F_R0_DIR: U1.V15 (GPIOB_RXP29_CLKP2), U30.2 (DIR)
/F_R01: RN13.7, U1.AB14 (GPIOB_RXN14)
/F_R1_DIR: U1.B19 (GPIOR_172_CTRL13), U31.2 (DIR)
/F_R02: RN13.6, U1.AB15 (GPIOB_RXP14)
/F_R2_DIR: U1.B17 (GPIOT_RXN21), U32.2 (DIR)
/F_R03: RN13.5, U1.Y14 (GPIOB_RXP16)
/F_R04: RN13.4, U1.W14 (GPIOB_RXN19_CLKN1)
/F_R05: RN13.3, U1.V14 (GPIOB_RXP19_CLKP1)
/F_R06: RN13.2, U1.U14 (GPIOB_RXN18_EXTFB1)
/F_R07: RN13.1, U1.AA15 (GPIOB_RXN20)
/F_R10: RN15.8, U1.D22 (GPIOR_183_CTRL10)
/F_R11: RN15.7, U1.D19 (GPIOR_173_CTRL12)
/F_R12: RN15.6, U1.C22 (GPIOR_182_CTRL11)
/F_R13: RN15.5, U1.C21 (GPIOR_178_CTRL11)
/F_R14: RN15.4, U1.C19 (GPIOR_171_CTRL14)
/F_R15: RN15.3, U1.B22 (GPIOR_180_CLK9)
/F_R16: RN15.2, U1.B21 (GPIOR_177_CLK12)
/F_R17: RN15.1, U1.B20 (GPIOR_175_CLK14)
/F_R20: RN17.8, U1.D18 (GPIOR_168_PLLIN2)
/F_R21: RN17.7, U1.C18 (GPIOR_166_PLLIN0)
/F_R22: RN17.6, U1.A19 (GPIOR_169_MREFCLK)
/F_R23: RN17.5, U1.D15 (GPIOT_RXN22)
/F_R24: RN17.4, U1.C16 (GPIOT_RXP23)
/F_R25: RN17.3, U1.C15 (GPIOT_RXN23)
/F_R26: RN17.2, U1.B16 (GPIOT_RXN20)
/F_R27: RN17.1, U1.A17 (GPIOT_RXP21)
/F_RCLK: U1.D20 (GPIOR_179_CLK10), U38.3 (A)
/F_RCLK_EN: R72.1, U1.D21 (GPIOR_184_CTRL9), U38.5 (DIR)
/F_RX0: U1.V11 (GPIOB_RXN03), U36.1 (A1)
/F_RX1: U1.V10 (GPIOB_TXN25), U36.3 (A2)
/F_RX2: U1.W10 (GPIOB_TXP25), U36.4 (A3)
/F_RX3: U1.AA10 (GPIOB_TXN26), U36.5 (A4)
/F_T00: RN7.8, U1.B15 (GPIOT_RXP18_EXTFB1)
/F_T0_DIR: U1.A12 (GPIOT_RXP11), U27.2 (DIR)
/F_T01: RN7.7, U1.A15 (GPIOT_RXN18_EXTFB1)
/F_T1_DIR: U1.A8 (GPIOT_TXN18), U28.2 (DIR)
/F_T02: RN7.6, U1.D14 (GPIOT_RXN19_CLKN1)
/F_T2_DIR: U1.A4 (GPIOT_TXP06), U29.2 (DIR)
/F_T03: RN7.5, U1.B14 (GPIOT_RXP15)
/F_T04: RN7.4, U1.A14 (GPIOT_RXN15)
/F_T05: RN7.3, U1.C13 (GPIOT_RXN13)
/F_T06: RN7.2, U1.B13 (GPIOT_RXP13)
/F_T07: RN7.1, U1.A13 (GPIOT_RXN11)
/F_T10: RN9.8, U1.B11 (GPIOT_RXN01)
/F_T11: RN9.7, U1.A11 (GPIOT_RXP01)
/F_T12: RN9.6, U1.D10 (GPIOT_TXP24)
/F_T13: RN9.5, U1.B10 (GPIOT_TXN25)
/F_T14: RN9.4, U1.A10 (GPIOT_TXP25)
/F_T15: RN9.3, U1.B9 (GPIOT_TXN23)
/F_T16: RN9.2, U1.A9 (GPIOT_TXP23)
/F_T17: RN9.1, U1.B8 (GPIOT_TXP18)
/F_T20: RN11.8, U1.A7 (GPIOT_TXP14)
/F_T21: RN11.7, U1.B7 (GPIOT_TXN14)
/F_T22: RN11.6, U1.A6 (GPIOT_TXP12)
/F_T23: RN11.5, U1.B6 (GPIOT_TXN12)
/F_T24: RN11.4, U1.C6 (GPIOT_TXP10)
/F_T25: RN11.3, U1.A5 (GPIOT_TXP07)
/F_T26: RN11.2, U1.B5 (GPIOT_TXN07)
/F_T27: RN11.1, U1.C4 (GPIOT_TXN03)
/F_TCLK: U1.D11 (GPIOT_RXN02), U39.3 (A)
/F_TCLK_EN: R74.1, U1.C11 (GPIOT_RXP04), U39.5 (DIR)
/F_TX0: U1.E6 (GPIOT_TXN11), U41.1 (A1)
/F_TX1: U1.F6 (GPIOT_TXP11), U41.3 (A2)
/F_TX2: U1.P5 (GPIOL_47), U41.4 (A3)
/F_TX3: U1.E8 (GPIOT_TXP16), U41.5 (A4)
/HR_CK: U1.M1 (GPIOL_65_CTRL3), U2.B2 (CK)
/HR_CS_N: R77.2, U1.G3 (GPIOL_141), U2.A3 (~CS)
/HR_DQ0: U1.K1 (GPIOL_87), U2.D3 (DQ0)
/HR_DQ1: U1.L1 (GPIOL_68_CLK2), U2.D2 (DQ1)
/HR_DQ2: U1.H1 (GPIOL_133), U2.C4 (DQ2)
/HR_DQ3: U1.J1 (GPIOL_119), U2.D4 (DQ3)
/HR_DQ4: U1.G1 (GPIOL_136), U2.D5 (DQ4)
/HR_DQ5: U1.K2 (GPIOL_89), U2.E3 (DQ5)
/HR_DQ6: U1.L2 (GPIOL_69_CLK3), U2.E2 (DQ6)
/HR_DQ7: U1.M3 (GPIOL_67_CLK1), U2.E1 (DQ7)
/HR_RESET_N: R78.2, U1.G2 (GPIOL_142), U2.A4 (~RESET)
/HR_RWDS: U1.L3 (GPIOL_73_CLK7), U2.C3 (RWDS)
/L00: J5.3, RN2.9
/L01: J5.4, RN2.10
/L02: J5.5, RN2.11
/L03: J5.6, RN2.12
/L04: J5.7, RN2.13
/L05: J5.8, RN2.14
/L06: J5.9, RN2.15
/L07: J5.10, RN2.16
/L10: J5.14, RN4.9
/L11: J5.15, RN4.10
/L12: J5.16, RN4.11
/L13: J5.17, RN4.12
/L14: J5.18, RN4.13
/L15: J5.19, RN4.14
/L16: J5.20, RN4.15
/L17: J5.21, RN4.16
/L20: J5.26, RN6.9
/L21: J5.27, RN6.10
/L22: J5.28, RN6.11
/L23: J5.29, RN6.12
/L24: J5.30, RN6.13
/L25: J5.31, RN6.14
/L26: J5.32, RN6.15
/L27: J5.33, RN6.16
/LCLK: J5.12, R69.2
/LX0: J5.22, U41.15 (B5)
/LX1: J5.23, U41.14 (B6)
/LX2: J5.24, U41.13 (B7)
/LX3: J5.25, U41.12 (B8)
/MCU_LED1: D3.1 (K), U11.41 (GPIO29/ADC3)
/MCU_LED2: D4.1 (K), U11.40 (GPIO28/ADC2)
/MCU_QSPI_SCLK: U10.6 (CLK), U11.52 (QSPI_SCLK)
/MCU_QSPI_SD0: U10.5 (DI/IO_{0}), U11.53 (QSPI_SD0)
/MCU_QSPI_SD1: U10.2 (DO/IO_{1}), U11.55 (QSPI_SD1)
/MCU_QSPI_SD2: U10.3 (~WP/IO_{2}), U11.54 (QSPI_SD2)
/MCU_QSPI_SD3: U10.7 (~HOLD/~RESET/IO_{3}), U11.51 (QSPI_SD3)
/MCU_RESET_N: J4.10, R35.2, U11.26 (RUN)
/MCU_SWCLK: J4.4, U11.24 (SWCLK)
/MCU_SWDIO: J4.2, U11.25 (SWDIO)
/R00: J7.3, RN14.9
/R01: J7.4, RN14.10
/R02: J7.5, RN14.11
/R03: J7.6, RN14.12
/R04: J7.7, RN14.13
/R05: J7.8, RN14.14
/R06: J7.9, RN14.15
/R07: J7.10, RN14.16
/R10: J7.14, RN16.9
/R11: J7.15, RN16.10
/R12: J7.16, RN16.11
/R13: J7.17, RN16.12
/R14: J7.18, RN16.13
/R15: J7.19, RN16.14
/R16: J7.20, RN16.15
/R17: J7.21, RN16.16
/R20: J7.26, RN18.9
/R21: J7.27, RN18.10
/R22: J7.28, RN18.11
/R23: J7.29, RN18.12
/R24: J7.30, RN18.13
/R25: J7.31, RN18.14
/R26: J7.32, RN18.15
/R27: J7.33, RN18.16
/RCLK: J7.12, R71.2
/RX0: J7.22, U36.20 (B1)
/RX1: J7.23, U36.18 (B2)
/RX2: J7.24, U36.17 (B3)
/RX3: J7.25, U36.16 (B4)
/T00: J6.3, RN8.9
/T01: J6.4, RN8.10
/T02: J6.5, RN8.11
/T03: J6.6, RN8.12
/T04: J6.7, RN8.13
/T05: J6.8, RN8.14
/T06: J6.9, RN8.15
/T07: J6.10, RN8.16
/T10: J6.14, RN10.9
/T11: J6.15, RN10.10
/T12: J6.16, RN10.11
/T13: J6.17, RN10.12
/T14: J6.18, RN10.13
/T15: J6.19, RN10.14
/T16: J6.20, RN10.15
/T17: J6.21, RN10.16
/T20: J6.26, RN12.9
/T21: J6.27, RN12.10
/T22: J6.28, RN12.11
/T23: J6.29, RN12.12
/T24: J6.30, RN12.13
/T25: J6.31, RN12.14
/T26: J6.32, RN12.15
/T27: J6.33, RN12.16
/TCLK: J6.12, R73.2
/TX0: J6.22, U41.20 (B1)
/TX1: J6.23, U41.18 (B2)
/TX2: J6.24, U41.17 (B3)
/TX3: J6.25, U41.16 (B4)
/USB_DN: J3.A7 (D-), J3.B7 (D-), R36.1
/USB_DP: J3.A6 (D+), J3.B6 (D+), R37.1
/VCCB_MUX_D0: R33.2, U9.1 (D0), U11.30 (GPIO19)
/VCCB_MUX_D1: R32.2, U9.2 (D1), U11.29 (GPIO18)
/~F_B0_OE: R65.2, U1.AB4 (GPIOB_TXN07_CDI22), U33.22 (~OE)
/~F_B1_OE: R66.2, U1.V8 (GPIOB_TXN17_CDI10), U34.22 (~OE)
/~F_B2_OE: R67.2, U1.Y13 (GPIOB_RXN16), U35.22 (~OE)
/~F_L0_OE: R56.2, U1.E4 (GPIOL_164_PLLIN0), U24.22 (~OE)
/~F_L1_OE: R57.2, U1.L4 (GPIOL_74_CTRL4), U25.22 (~OE)
/~F_L2_OE: R58.2, U1.R3 (GPIOL_17_EXTFB0), U26.22 (~OE)
/~F_R0_OE: R62.2, U1.W15 (GPIOB_RXN29_CLKN2), U30.22 (~OE)
/~F_R1_OE: R63.2, U1.A21 (GPIOR_176_CLK13), U31.22 (~OE)
/~F_R2_OE: R64.2, U1.A16 (GPIOT_RXP20), U32.22 (~OE)
/~F_T0_OE: R59.2, U1.C12 (GPIOT_RXN04), U27.22 (~OE)
/~F_T1_OE: R60.2, U1.C7 (GPIOT_TXN10), U28.22 (~OE)
/~F_T2_OE: R61.2, U1.C3 (GPIOT_TXP03), U29.22 (~OE)
/~F_X_OE: R68.2, R79.2, U1.AB9 (GPIOB_TXP24), U36.10 (OE), U41.10 (OE)
/~MCU_QSPI_SS: R38.2, U10.1 (~CS), U11.56 (~QSPI_SS)
GND: C1.2, C2.2, C3.2, C4.2, C5.2, C6.2, C7.2, C8.2, C9.2, C10.2, C11.2, C12.2, C13.2, C14.2, C15.2, C16.2, C17.2, C18.2, C19.2, C20.2, C21.2, C22.2, C23.2, C24.2, C25.2, C26.2, C27.2, C28.2, C29.2, C30.2, C31.2, C32.2, C33.2, C34.2, C35.2, C36.2, C37.2, C38.2, C39.2, C40.2, C41.2, C42.2, C43.2, C44.2, C45.2, C46.2, C47.2, C48.2, C49.2, C50.2, C51.2, C52.2, C53.2, C54.2, C55.2, C56.2, C57.2, C58.2, C59.2, C60.2, C61.2, C62.2, C63.2, C64.2, C65.2, C66.2, C67.2, C68.2, C69.2, C70.2, C71.2, C72.2, C73.2, C74.2, C75.2, C76.2, C77.2, C78.2, C79.2, C80.2, C81.2, C82.2, C83.2, C84.2, C85.2, C86.2, C87.2, C88.2, C89.2, C90.2, C91.2, C92.2, C93.2, C94.2, C95.2, C96.2, C97.2, C98.2, C99.2, C100.2, C102.2, C103.2, C104.2, C105.2, C106.2, C108.2, C109.2, C110.2, C111.2, C112.2, C113.2, C114.2, C115.2, C116.2, C117.2, C118.2, C119.2, C120.2, C121.2, C122.2, C123.2, C124.2, C125.2, C126.2, C127.2, C128.2, C129.2, C130.2, C131.2, C132.2, C133.2, C134.2, C145.2, C146.2, C147.2, C148.2, C149.2, C150.2, C151.2, C152.2, C153.2, C154.2, C155.2, C156.2, C157.2, C158.2, C159.2, C160.2, C161.2, C162.2, C163.2, C164.2, C165.2, C166.2, C167.2, C168.2, C169.2, C170.2, C171.2, C172.2, C173.2, C174.2, C175.2, C176.2, C177.2, C178.2, C179.2, C180.2, C181.2, C182.2, C183.2, C184.2, C185.2, C186.2, C187.2, C188.2, C189.2, C190.2, C191.2, C192.2, C193.2, C194.2, D1.1 (K), D2.1 (K), J1.3, J1.5, J1.9, J2.2, J3.A1 (GND), J3.A12 (GND), J3.B1 (GND), J3.B12 (GND), J3.SH (SHIELD), J4.3, J4.5, J4.9, J5.1, J5.2, J5.11, J5.13, J6.2, J6.11, J6.13, J7.2, J7.11, J7.13, J8.1, J8.2, J8.11, J8.13, Q2.2 (S), R18.2, R20.2, R21.2, R23.2, R24.2, R26.2, R27.2, R31.2, R34.2, R70.2, R72.2, R74.2, R76.2, SW1.2, SW2.2, U1.A1 (GND), U1.A22 (GND), U1.AB1 (GND), U1.AB22 (GND), U1.B4 (GND), U1.B12 (GND), U1.D4 (GND), U1.D7 (GND), U1.D13 (GND), U1.D16 (GND), U1.E18 (GND), U1.E20 (GND), U1.F22 (GND), U1.H2 (GND), U1.H5 (GND), U1.H15 (GND), U1.H17 (GND), U1.H22 (GND), U1.J10 (GND), U1.J12 (GND), U1.J14 (GND), U1.J20 (GND), U1.K9 (GND), U1.K11 (GND), U1.K13 (GND), U1.K16 (GND), U1.K17 (DDR_VREF), U1.K18 (GND), U1.L8 (GND), U1.L10 (GND), U1.L12 (GND), U1.L14 (GND), U1.M2 (GND), U1.M5 (GND), U1.M9 (GND), U1.M11 (GND), U1.M13 (GND), U1.N8 (GND), U1.N10 (GND), U1.N12 (GND), U1.N14 (GND), U1.N16 (GND), U1.N18 (GND), U1.N20 (GND), U1.N22 (GND), U1.P9 (GND), U1.P11 (GND), U1.P13 (GND), U1.T2 (GND), U1.T5 (GND), U1.T7 (GND), U1.T16 (GND), U1.T18 (GND), U1.U20 (GND), U1.U22 (GND), U1.W13 (GND), U1.W18 (GND), U1.Y2 (GND), U1.Y5 (GND), U1.Y8 (GND), U1.Y11 (GND), U1.Y15 (GND), U1.Y20 (GND), U2.B3 (VSS), U2.C1 (VSSQ), U2.E5 (VSSQ), U3.1 (GND), U4.2 (GND), U5.2 (GND), U6.1 (GND), U7.1 (GND), U8.3 (GND), U9.5 (GND), U10.4 (GND), U11.19 (TESTEN), U11.57 (GND), U24.11 (GND), U24.12 (GND), U24.13 (GND), U25.11 (GND), U25.12 (GND), U25.13 (GND), U26.11 (GND), U26.12 (GND), U26.13 (GND), U27.11 (GND), U27.12 (GND), U27.13 (GND), U28.11 (GND), U28.12 (GND), U28.13 (GND), U29.11 (GND), U29.12 (GND), U29.13 (GND), U30.11 (GND), U30.12 (GND), U30.13 (GND), U31.11 (GND), U31.12 (GND), U31.13 (GND), U32.11 (GND), U32.12 (GND), U32.13 (GND), U33.11 (GND), U33.12 (GND), U33.13 (GND), U34.11 (GND), U34.12 (GND), U34.13 (GND), U35.11 (GND), U35.12 (GND), U35.13 (GND), U36.11 (GND), U37.2 (GND), U38.2 (GND), U39.2 (GND), U40.2 (GND), U41.11 (GND), Y1.2 (GND), Y2.2 (GND)
unnamed: D1.2 (A), R16.1
unnamed: D2.2 (A), R19.1
unnamed: D3.2 (A), R42.1
unnamed: D4.2 (A), R43.1
unnamed: J3.A5 (CC1), R21.1
unnamed: J3.B5 (CC2), R20.1
unnamed: Q1.1 (G), U8.7 (OUTA)
unnamed: Q2.1 (G), U8.5 (OUTB)
unnamed: R35.1, SW1.1
unnamed: R38.1, SW2.1
unnamed: R13.2, U1.F1 (GPIOL_151_TEST_N)
unnamed: R14.2, U1.F4 (GPIOL_156_CBSEL0)
unnamed: R15.2, U1.E2 (GPIOL_157_CBSEL1)
unnamed: C92.1, J2.1, R16.2, R17.1, U3.3 (VIN1), U3.5 (MODE)
unnamed: R17.2, R18.1, U3.4 (PR1)
unnamed: C94.1, J3.A4 (VBUS), J3.A9 (VBUS), J3.B4 (VBUS), J3.B9 (VBUS), R19.2, U3.6 (VIN2)
unnamed: C101.1, L1.1, U6.2 (SW)
unnamed: C101.2, U6.6 (VBST)
unnamed: R22.2, R23.1, U6.4 (VFB)
unnamed: C107.1, L2.1, U7.2 (SW)
unnamed: C107.2, U7.6 (VBST)
unnamed: R25.2, R26.1, U7.4 (VFB)
unnamed: R28.2, R29.2, U8.2 (INA)
unnamed: R30.2, R31.1, U8.4 (INB)
unnamed: R34.1, U9.4 (ILIM)
unnamed: R36.2, U11.46 (USB_DM)
unnamed: R37.2, U11.47 (USB_DP)
unnamed: R41.2, U11.20 (XIN)
unnamed: RN1.16, U24.3 (A1)
unnamed: RN1.15, U24.4 (A2)
unnamed: RN1.14, U24.5 (A3)
unnamed: RN1.13, U24.6 (A4)
unnamed: RN1.12, U24.7 (A5)
unnamed: RN1.11, U24.8 (A6)
unnamed: RN1.10, U24.9 (A7)
unnamed: RN1.9, U24.10 (A8)
unnamed: RN2.1, U24.21 (B1)
unnamed: RN2.2, U24.20 (B2)
unnamed: RN2.3, U24.19 (B3)
unnamed: RN2.4, U24.18 (B4)
unnamed: RN2.5, U24.17 (B5)
unnamed: RN2.6, U24.16 (B6)
unnamed: RN2.7, U24.15 (B7)
unnamed: RN2.8, U24.14 (B8)
unnamed: RN3.16, U25.3 (A1)
unnamed: RN3.15, U25.4 (A2)
unnamed: RN3.14, U25.5 (A3)
unnamed: RN3.13, U25.6 (A4)
unnamed: RN3.12, U25.7 (A5)
unnamed: RN3.11, U25.8 (A6)
unnamed: RN3.10, U25.9 (A7)
unnamed: RN3.9, U25.10 (A8)
unnamed: RN4.1, U25.21 (B1)
unnamed: RN4.2, U25.20 (B2)
unnamed: RN4.3, U25.19 (B3)
unnamed: RN4.4, U25.18 (B4)
unnamed: RN4.5, U25.17 (B5)
unnamed: RN4.6, U25.16 (B6)
unnamed: RN4.7, U25.15 (B7)
unnamed: RN4.8, U25.14 (B8)
unnamed: RN5.16, U26.3 (A1)
unnamed: RN5.15, U26.4 (A2)
unnamed: RN5.14, U26.5 (A3)
unnamed: RN5.13, U26.6 (A4)
unnamed: RN5.12, U26.7 (A5)
unnamed: RN5.11, U26.8 (A6)
unnamed: RN5.10, U26.9 (A7)
unnamed: RN5.9, U26.10 (A8)
unnamed: RN6.1, U26.21 (B1)
unnamed: RN6.2, U26.20 (B2)
unnamed: RN6.3, U26.19 (B3)
unnamed: RN6.4, U26.18 (B4)
unnamed: RN6.5, U26.17 (B5)
unnamed: RN6.6, U26.16 (B6)
unnamed: RN6.7, U26.15 (B7)
unnamed: RN6.8, U26.14 (B8)
unnamed: RN7.16, U27.3 (A1)
unnamed: RN7.15, U27.4 (A2)
unnamed: RN7.14, U27.5 (A3)
unnamed: RN7.13, U27.6 (A4)
unnamed: RN7.12, U27.7 (A5)
unnamed: RN7.11, U27.8 (A6)
unnamed: RN7.10, U27.9 (A7)
unnamed: RN7.9, U27.10 (A8)
unnamed: RN8.1, U27.21 (B1)
unnamed: RN8.2, U27.20 (B2)
unnamed: RN8.3, U27.19 (B3)
unnamed: RN8.4, U27.18 (B4)
unnamed: RN8.5, U27.17 (B5)
unnamed: RN8.6, U27.16 (B6)
unnamed: RN8.7, U27.15 (B7)
unnamed: RN8.8, U27.14 (B8)
unnamed: RN9.16, U28.3 (A1)
unnamed: RN9.15, U28.4 (A2)
unnamed: RN9.14, U28.5 (A3)
unnamed: RN9.13, U28.6 (A4)
unnamed: RN9.12, U28.7 (A5)
unnamed: RN9.11, U28.8 (A6)
unnamed: RN9.10, U28.9 (A7)
unnamed: RN9.9, U28.10 (A8)
unnamed: RN10.1, U28.21 (B1)
unnamed: RN10.2, U28.20 (B2)
unnamed: RN10.3, U28.19 (B3)
unnamed: RN10.4, U28.18 (B4)
unnamed: RN10.5, U28.17 (B5)
unnamed: RN10.6, U28.16 (B6)
unnamed: RN10.7, U28.15 (B7)
unnamed: RN10.8, U28.14 (B8)
unnamed: RN11.16, U29.3 (A1)
unnamed: RN11.15, U29.4 (A2)
unnamed: RN11.14, U29.5 (A3)
unnamed: RN11.13, U29.6 (A4)
unnamed: RN11.12, U29.7 (A5)
unnamed: RN11.11, U29.8 (A6)
unnamed: RN11.10, U29.9 (A7)
unnamed: RN11.9, U29.10 (A8)
unnamed: RN12.1, U29.21 (B1)
unnamed: RN12.2, U29.20 (B2)
unnamed: RN12.3, U29.19 (B3)
unnamed: RN12.4, U29.18 (B4)
unnamed: RN12.5, U29.17 (B5)
unnamed: RN12.6, U29.16 (B6)
unnamed: RN12.7, U29.15 (B7)
unnamed: RN12.8, U29.14 (B8)
unnamed: RN13.16, U30.3 (A1)
unnamed: RN13.15, U30.4 (A2)
unnamed: RN13.14, U30.5 (A3)
unnamed: RN13.13, U30.6 (A4)
unnamed: RN13.12, U30.7 (A5)
unnamed: RN13.11, U30.8 (A6)
unnamed: RN13.10, U30.9 (A7)
unnamed: RN13.9, U30.10 (A8)
unnamed: RN14.1, U30.21 (B1)
unnamed: RN14.2, U30.20 (B2)
unnamed: RN14.3, U30.19 (B3)
unnamed: RN14.4, U30.18 (B4)
unnamed: RN14.5, U30.17 (B5)
unnamed: RN14.6, U30.16 (B6)
unnamed: RN14.7, U30.15 (B7)
unnamed: RN14.8, U30.14 (B8)
unnamed: RN15.16, U31.3 (A1)
unnamed: RN15.15, U31.4 (A2)
unnamed: RN15.14, U31.5 (A3)
unnamed: RN15.13, U31.6 (A4)
unnamed: RN15.12, U31.7 (A5)
unnamed: RN15.11, U31.8 (A6)
unnamed: RN15.10, U31.9 (A7)
unnamed: RN15.9, U31.10 (A8)
unnamed: RN16.1, U31.21 (B1)
unnamed: RN16.2, U31.20 (B2)
unnamed: RN16.3, U31.19 (B3)
unnamed: RN16.4, U31.18 (B4)
unnamed: RN16.5, U31.17 (B5)
unnamed: RN16.6, U31.16 (B6)
unnamed: RN16.7, U31.15 (B7)
unnamed: RN16.8, U31.14 (B8)
unnamed: RN17.16, U32.3 (A1)
unnamed: RN17.15, U32.4 (A2)
unnamed: RN17.14, U32.5 (A3)
unnamed: RN17.13, U32.6 (A4)
unnamed: RN17.12, U32.7 (A5)
unnamed: RN17.11, U32.8 (A6)
unnamed: RN17.10, U32.9 (A7)
unnamed: RN17.9, U32.10 (A8)
unnamed: RN18.1, U32.21 (B1)
unnamed: RN18.2, U32.20 (B2)
unnamed: RN18.3, U32.19 (B3)
unnamed: RN18.4, U32.18 (B4)
unnamed: RN18.5, U32.17 (B5)
unnamed: RN18.6, U32.16 (B6)
unnamed: RN18.7, U32.15 (B7)
unnamed: RN18.8, U32.14 (B8)
unnamed: RN19.16, U33.3 (A1)
unnamed: RN19.15, U33.4 (A2)
unnamed: RN19.14, U33.5 (A3)
unnamed: RN19.13, U33.6 (A4)
unnamed: RN19.12, U33.7 (A5)
unnamed: RN19.11, U33.8 (A6)
unnamed: RN19.10, U33.9 (A7)
unnamed: RN19.9, U33.10 (A8)
unnamed: RN20.1, U33.21 (B1)
unnamed: RN20.2, U33.20 (B2)
unnamed: RN20.3, U33.19 (B3)
unnamed: RN20.4, U33.18 (B4)
unnamed: RN20.5, U33.17 (B5)
unnamed: RN20.6, U33.16 (B6)
unnamed: RN20.7, U33.15 (B7)
unnamed: RN20.8, U33.14 (B8)
unnamed: RN21.16, U34.3 (A1)
unnamed: RN21.15, U34.4 (A2)
unnamed: RN21.14, U34.5 (A3)
unnamed: RN21.13, U34.6 (A4)
unnamed: RN21.12, U34.7 (A5)
unnamed: RN21.11, U34.8 (A6)
unnamed: RN21.10, U34.9 (A7)
unnamed: RN21.9, U34.10 (A8)
unnamed: RN22.1, U34.21 (B1)
unnamed: RN22.2, U34.20 (B2)
unnamed: RN22.3, U34.19 (B3)
unnamed: RN22.4, U34.18 (B4)
unnamed: RN22.5, U34.17 (B5)
unnamed: RN22.6, U34.16 (B6)
unnamed: RN22.7, U34.15 (B7)
unnamed: RN22.8, U34.14 (B8)
unnamed: RN23.16, U35.3 (A1)
unnamed: RN23.15, U35.4 (A2)
unnamed: RN23.14, U35.5 (A3)
unnamed: RN23.13, U35.6 (A4)
unnamed: RN23.12, U35.7 (A5)
unnamed: RN23.11, U35.8 (A6)
unnamed: RN23.10, U35.9 (A7)
unnamed: RN23.9, U35.10 (A8)
unnamed: RN24.1, U35.21 (B1)
unnamed: RN24.2, U35.20 (B2)
unnamed: RN24.3, U35.19 (B3)
unnamed: RN24.4, U35.18 (B4)
unnamed: RN24.5, U35.17 (B5)
unnamed: RN24.6, U35.16 (B6)
unnamed: RN24.7, U35.15 (B7)
unnamed: RN24.8, U35.14 (B8)
unnamed: R69.1, U37.4 (B)
unnamed: R71.1, U38.4 (B)
unnamed: R73.1, U39.4 (B)
unnamed: R75.1, U40.4 (B)
unnamed: C1.1, C2.1, FB1.1, Y1.1 (EN), Y1.4 (Vdd)
unnamed: R12.1, Y1.3 (OUT)
unnamed: R41.1, Y2.3 (OUT)
VCCB: C115.1, C146.1, C147.1, C149.1, C150.1, C152.1, C153.1, C155.1, C156.1, C158.1, C159.1, C161.1, C162.1, C164.1, C165.1, C167.1, C168.1, C170.1, C171.1, C173.1, C174.1, C176.1, C177.1, C179.1, C180.1, C182.1, C184.1, C186.1, C188.1, C190.1, C194.1, Q1.3 (S), TP5.1 (1_1), U9.7 (OUT), U24.23 (VCCB), U24.24 (VCCB), U25.23 (VCCB), U25.24 (VCCB), U26.23 (VCCB), U26.24 (VCCB), U27.23 (VCCB), U27.24 (VCCB), U28.23 (VCCB), U28.24 (VCCB), U29.23 (VCCB), U29.24 (VCCB), U30.23 (VCCB), U30.24 (VCCB), U31.23 (VCCB), U31.24 (VCCB), U32.23 (VCCB), U32.24 (VCCB), U33.23 (VCCB), U33.24 (VCCB), U34.23 (VCCB), U34.24 (VCCB), U35.23 (VCCB), U35.24 (VCCB), U36.19 (VCCB), U37.6 (VCCB), U38.6 (VCCB), U39.6 (VCCB), U40.6 (VCCB), U41.19 (VCCB)
VCC_DUT: J5.34, J6.34, J7.34, J8.34, Q1.2 (D), Q2.3 (D), TP4.1 (1_1)

Notes on the sheet:
C5 close to pin 44
Replace with TPS2111A?
RP2350 Microcontroller
HyperRAM: F.Cu-only, no vias; CK/DQ[7:0]/RWDS verified PCB length spread 0.214807mm (limit 0.381mm). U2 and signal tracks locked. Package skew excluded;
Extraction Holes
Mounting Holes
USB and Power Input
C6 close to pin 45
Power Regulation

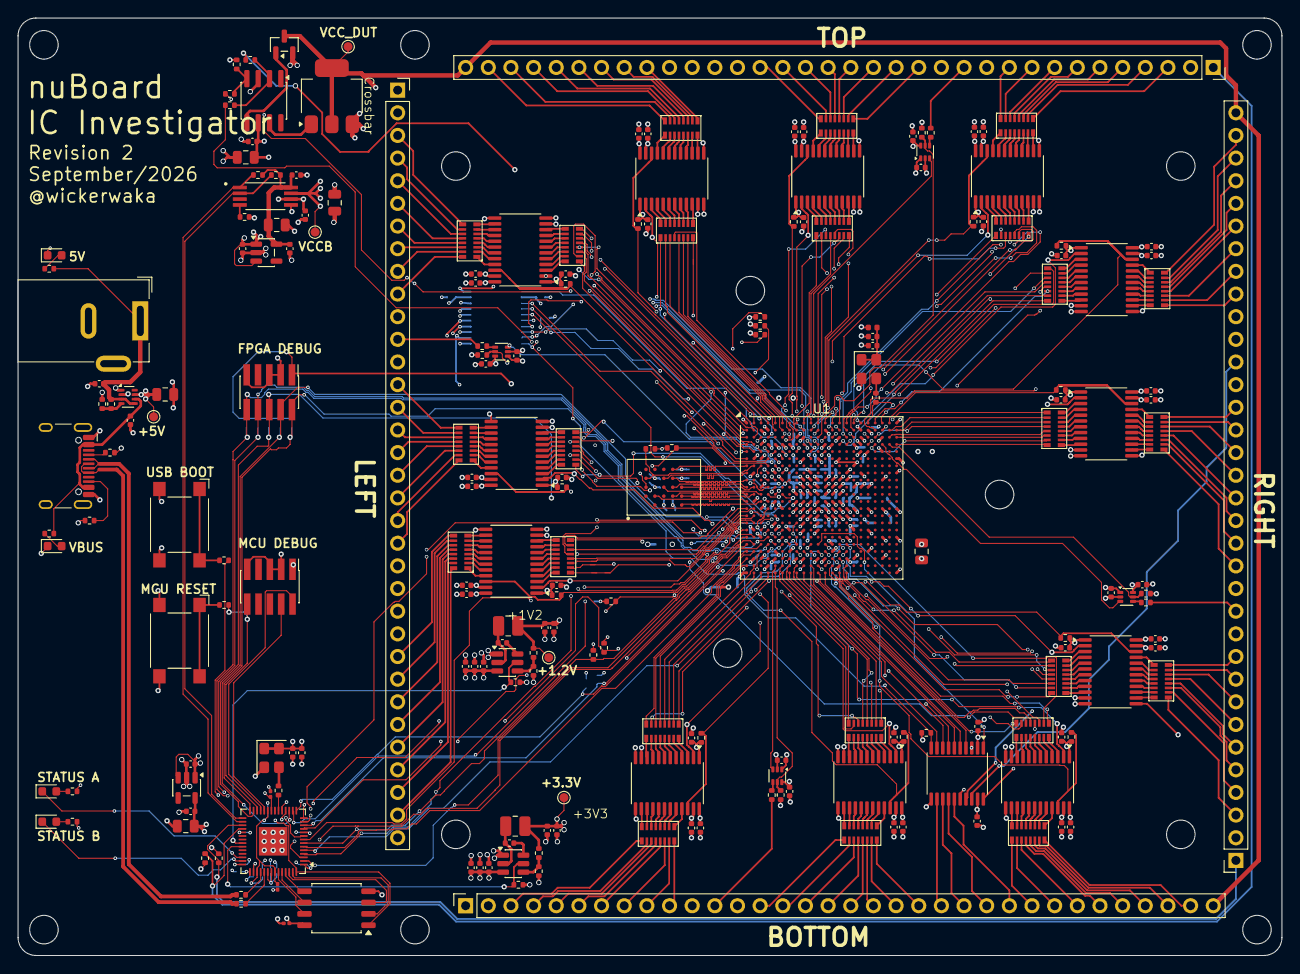
[picture p23: board nuBoard.kicad_pcb from above]

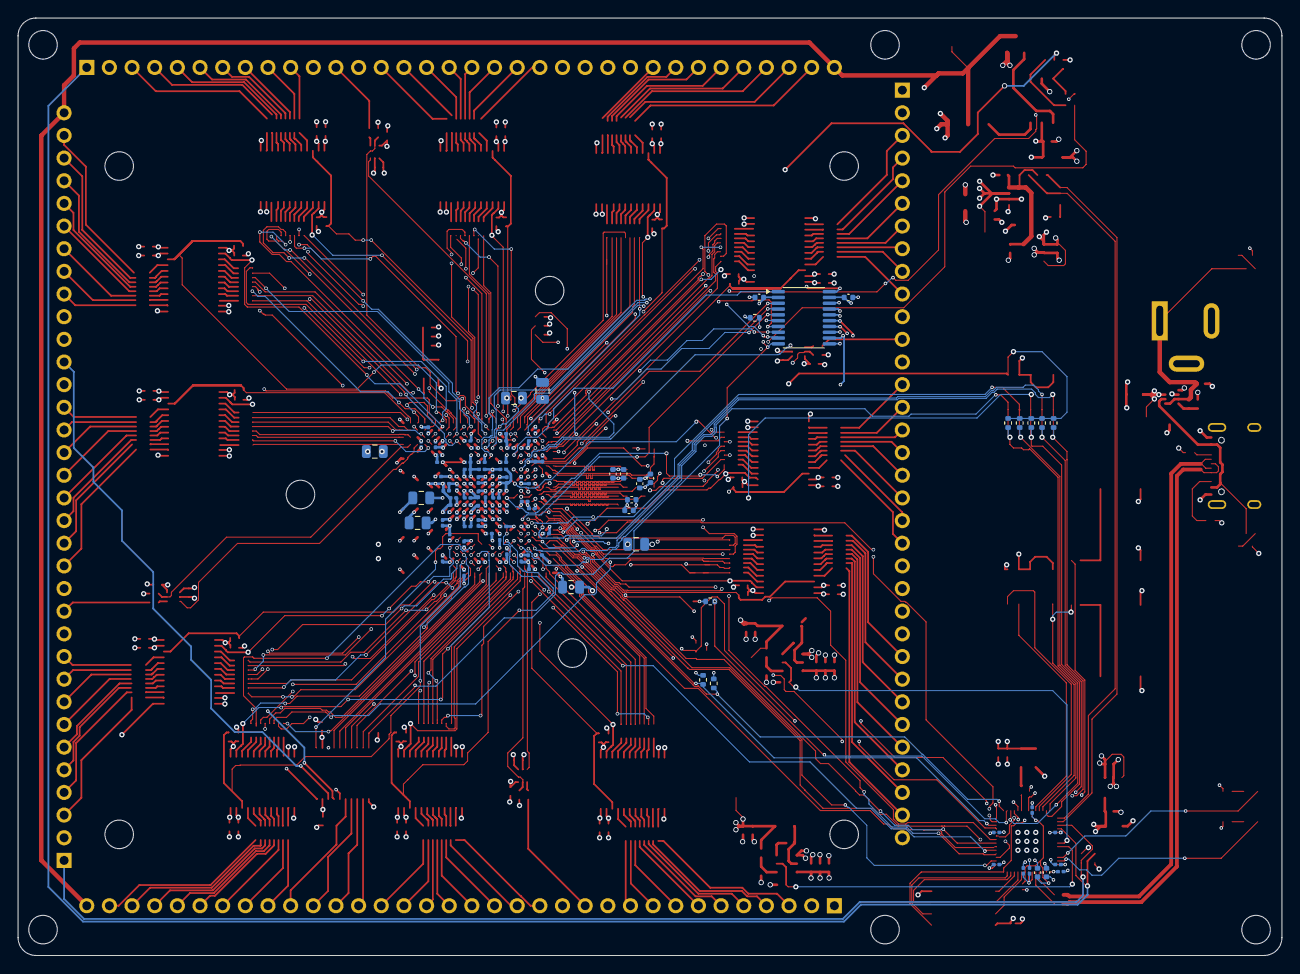
[picture p24: board nuBoard.kicad_pcb from below]

Board: 6 copper layers, 141.7 x 105.1 mm, 343 parts (114 on the bottom side), 549 nets.
