wickerwaka/nuBoard/hardware/v35s/v35s.kicad_pcb

## KiCad design hardware/v35s/v35s.kicad_pcb (2026-10-10)

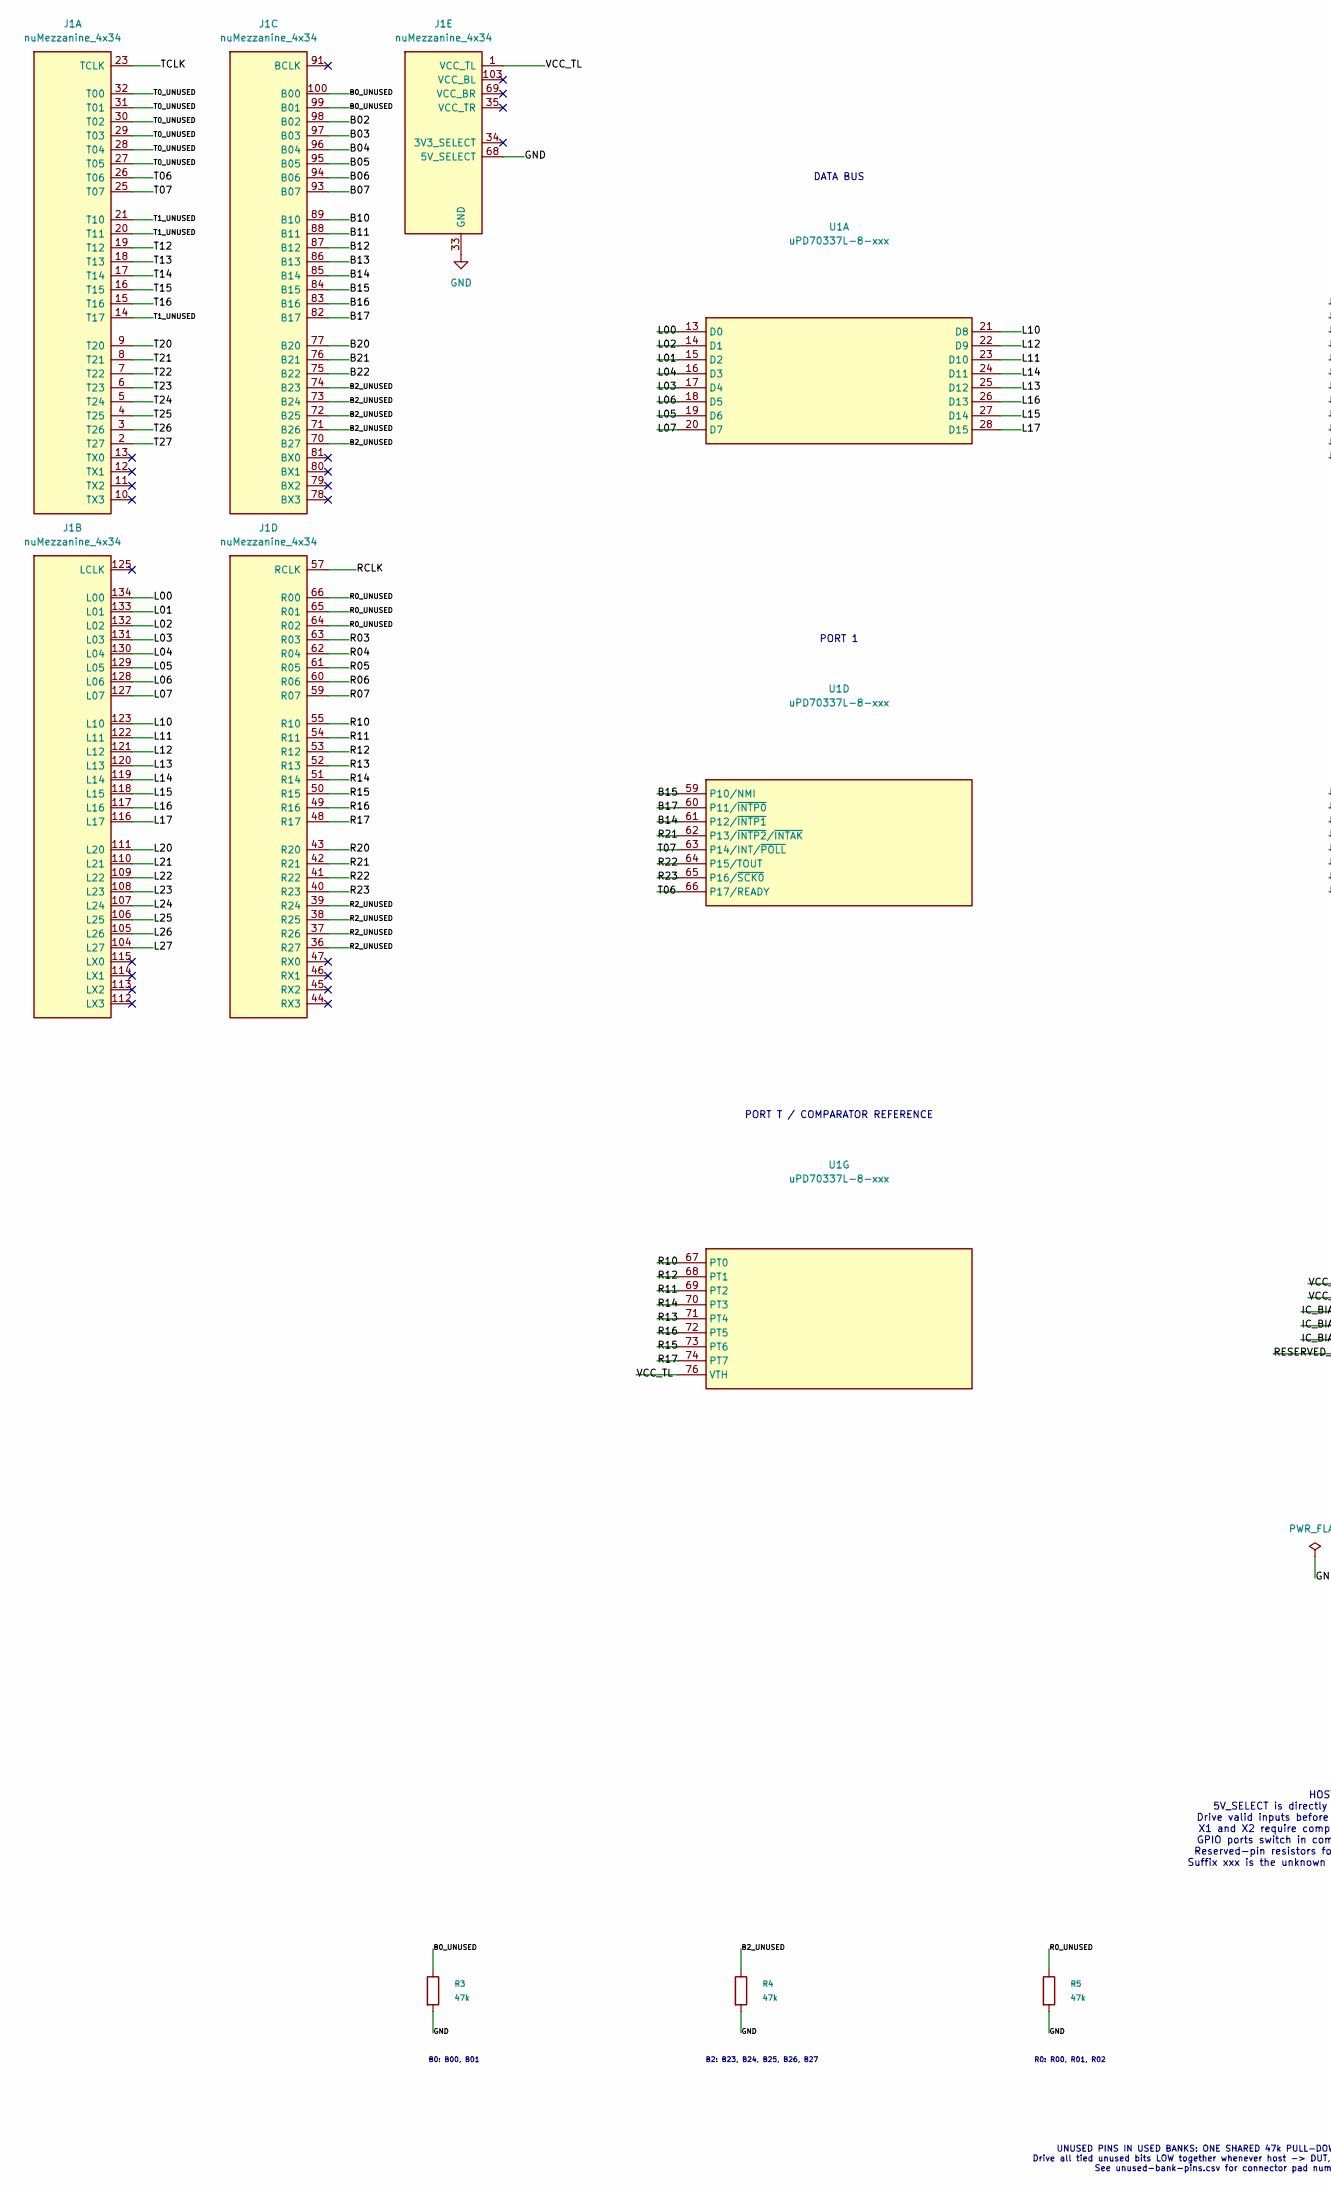
[picture p25: schematic v35s.kicad_sch, NEC V35S DUT daughter board, part in row 1, column 1]

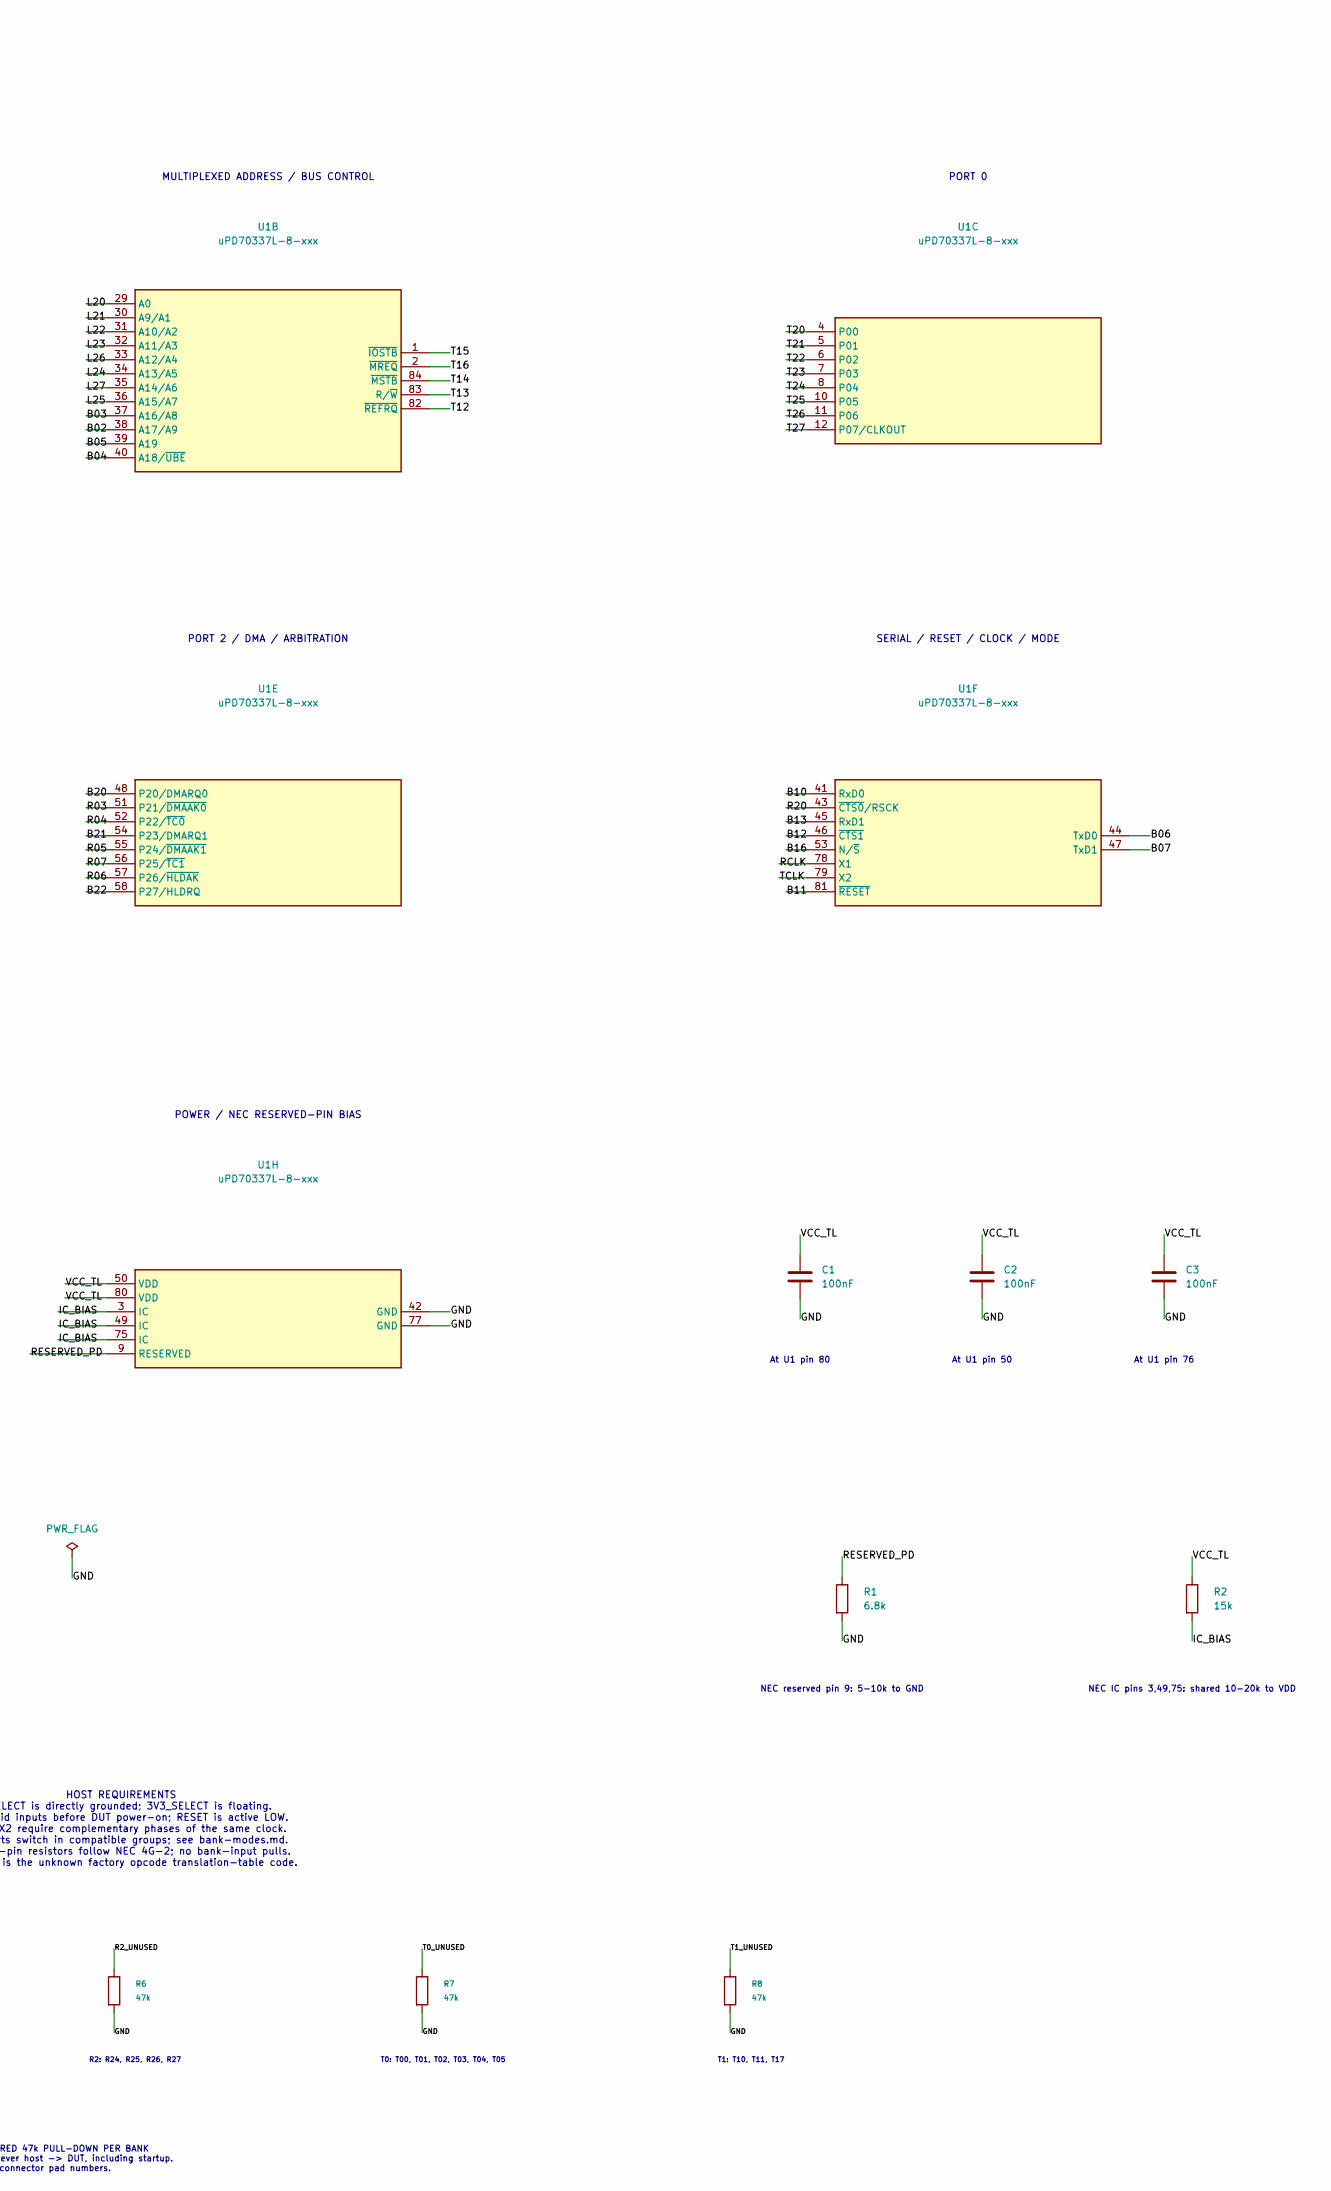
[picture p26: schematic v35s.kicad_sch, NEC V35S DUT daughter board, part in row 1, column 2]

Parts:
C1, C2, C3: 100nF; C_0805_2012Metric_Pad1.18x1.45mm_HandSolder; Voltage 50V
J1: nuMezzanine_4x34; nuMezzanine_4x34_P2.54mm
R1: 6.8k; R_0805_2012Metric_Pad1.20x1.40mm_HandSolder
R2: 15k; R_0805_2012Metric_Pad1.20x1.40mm_HandSolder
R3, R4, R5, R6, R7, R8: 47k; R_0805_2012Metric_Pad1.20x1.40mm_HandSolder
U1: uPD70337L-8-xxx; PLCC-84_THT-Socket

Connections:
/B0_UNUSED: J1.99 (B01_99), J1.100 (B00_100), R3.1
/B02: J1.98 (B02_98), U1.38 (A17/A9)
/B2_UNUSED: J1.70 (B27_70), J1.71 (B26_71), J1.72 (B25_72), J1.73 (B24_73), J1.74 (B23_74), R4.1
/B03: J1.97 (B03_97), U1.37 (A16/A8)
/B04: J1.96 (B04_96), U1.40 (A18/~UBE)
/B05: J1.95 (B05_95), U1.39 (A19)
/B06: J1.94 (B06_94), U1.44 (TxD0)
/B07: J1.93 (B07_93), U1.47 (TxD1)
/B10: J1.89 (B10_89), U1.41 (RxD0)
/B11: J1.88 (B11_88), U1.81 (~RESET)
/B12: J1.87 (B12_87), U1.46 (~CTS1)
/B13: J1.86 (B13_86), U1.45 (RxD1)
/B14: J1.85 (B14_85), U1.61 (P12/~INTP1)
/B15: J1.84 (B15_84), U1.59 (P10/NMI)
/B16: J1.83 (B16_83), U1.53 (N/~S)
/B17: J1.82 (B17_82), U1.60 (P11/~INTP0)
/B20: J1.77 (B20_77), U1.48 (P20/DMARQ0)
/B21: J1.76 (B21_76), U1.54 (P23/DMARQ1)
/B22: J1.75 (B22_75), U1.58 (P27/HLDRQ)
/IC_BIAS: R2.2, U1.3 (IC), U1.49 (IC), U1.75 (IC)
/L00: J1.134 (L00_134), U1.13 (D0)
/L01: J1.133 (L01_133), U1.15 (D2)
/L02: J1.132 (L02_132), U1.14 (D1)
/L03: J1.131 (L03_131), U1.17 (D4)
/L04: J1.130 (L04_130), U1.16 (D3)
/L05: J1.129 (L05_129), U1.19 (D6)
/L06: J1.128 (L06_128), U1.18 (D5)
/L07: J1.127 (L07_127), U1.20 (D7)
/L10: J1.123 (L10_123), U1.21 (D8)
/L11: J1.122 (L11_122), U1.23 (D10)
/L12: J1.121 (L12_121), U1.22 (D9)
/L13: J1.120 (L13_120), U1.25 (D12)
/L14: J1.119 (L14_119), U1.24 (D11)
/L15: J1.118 (L15_118), U1.27 (D14)
/L16: J1.117 (L16_117), U1.26 (D13)
/L17: J1.116 (L17_116), U1.28 (D15)
/L20: J1.111 (L20_111), U1.29 (A0)
/L21: J1.110 (L21_110), U1.30 (A9/A1)
/L22: J1.109 (L22_109), U1.31 (A10/A2)
/L23: J1.108 (L23_108), U1.32 (A11/A3)
/L24: J1.107 (L24_107), U1.34 (A13/A5)
/L25: J1.106 (L25_106), U1.36 (A15/A7)
/L26: J1.105 (L26_105), U1.33 (A12/A4)
/L27: J1.104 (L27_104), U1.35 (A14/A6)
/R0_UNUSED: J1.64 (R02_64), J1.65 (R01_65), J1.66 (R00_66), R5.1
/R2_UNUSED: J1.36 (R27_36), J1.37 (R26_37), J1.38 (R25_38), J1.39 (R24_39), R6.1
/R03: J1.63 (R03_63), U1.51 (P21/~DMAAK0)
/R04: J1.62 (R04_62), U1.52 (P22/~TC0)
/R05: J1.61 (R05_61), U1.55 (P24/~DMAAK1)
/R06: J1.60 (R06_60), U1.57 (P26/~HLDAK)
/R07: J1.59 (R07_59), U1.56 (P25/~TC1)
/R10: J1.55 (R10_55), U1.67 (PT0)
/R11: J1.54 (R11_54), U1.69 (PT2)
/R12: J1.53 (R12_53), U1.68 (PT1)
/R13: J1.52 (R13_52), U1.71 (PT4)
/R14: J1.51 (R14_51), U1.70 (PT3)
/R15: J1.50 (R15_50), U1.73 (PT6)
/R16: J1.49 (R16_49), U1.72 (PT5)
/R17: J1.48 (R17_48), U1.74 (PT7)
/R20: J1.43 (R20_43), U1.43 (~CTS0/RSCK)
/R21: J1.42 (R21_42), U1.62 (P13/~INTP2/~INTAK)
/R22: J1.41 (R22_41), U1.64 (P15/TOUT)
/R23: J1.40 (R23_40), U1.65 (P16/~SCK0)
/RCLK: J1.57 (RCLK_57), U1.78 (X1)
/RESERVED_PD: R1.1, U1.9 (RESERVED)
/T0_UNUSED: J1.27 (T05_27), J1.28 (T04_28), J1.29 (T03_29), J1.30 (T02_30), J1.31 (T01_31), J1.32 (T00_32), R7.1
/T1_UNUSED: J1.14 (T17_14), J1.20 (T11_20), J1.21 (T10_21), R8.1
/T06: J1.26 (T06_26), U1.66 (P17/READY)
/T07: J1.25 (T07_25), U1.63 (P14/INT/~POLL)
/T12: J1.19 (T12_19), U1.82 (~REFRQ)
/T13: J1.18 (T13_18), U1.83 (R/~W)
/T14: J1.17 (T14_17), U1.84 (~MSTB)
/T15: J1.16 (T15_16), U1.1 (~IOSTB)
/T16: J1.15 (T16_15), U1.2 (~MREQ)
/T20: J1.9 (T20_9), U1.4 (P00)
/T21: J1.8 (T21_8), U1.5 (P01)
/T22: J1.7 (T22_7), U1.6 (P02)
/T23: J1.6 (T23_6), U1.7 (P03)
/T24: J1.5 (T24_5), U1.8 (P04)
/T25: J1.4 (T25_4), U1.10 (P05)
/T26: J1.3 (T26_3), U1.11 (P06)
/T27: J1.2 (T27_2), U1.12 (P07/CLKOUT)
/TCLK: J1.23 (TCLK_23), U1.79 (X2)
/VCC_TL: C1.1, C2.1, C3.1, J1.1 (VCC_TL_1), R2.1, U1.50 (VDD), U1.76 (VTH), U1.80 (VDD)
GND: C1.2, C2.2, C3.2, J1.22 (GND_22), J1.24 (GND_24), J1.33 (GND_33), J1.56 (GND_56), J1.58 (GND_58), J1.67 (GND_67), J1.68 (5V_SELECT_68), J1.90 (GND_90), J1.92 (GND_92), J1.101 (GND_101), J1.102 (GND), J1.124 (GND_124), J1.126 (GND_126), J1.135 (GND_135), J1.136 (GND), R1.2, R3.2, R4.2, R5.2, R6.2, R7.2, R8.2, U1.42 (GND), U1.77 (GND)

Notes on the sheet:
DATA BUS
MULTIPLEXED ADDRESS / BUS CONTROL
PORT 0
PORT 1
PORT 2 / DMA / ARBITRATION
SERIAL / RESET / CLOCK / MODE
PORT T / COMPARATOR REFERENCE
POWER / NEC RESERVED-PIN BIAS
At U1 pin 80
At U1 pin 50
At U1 pin 76
NEC reserved pin 9: 5-10k to GND
NEC IC pins 3,49,75: shared 10-20k to VDD
HOST REQUIREMENTS 5V_SELECT is directly grounded; 3V3_SELECT is floating. Drive valid inputs before DUT power-on; RESET is active LOW. X1 and X2 require complementary phases of the same clock. GPIO ports switch in compatible groups; see bank-modes.md. Reserved-pin resistors follow NEC 4G-2; no bank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
B0: B00, B01
B2: B23, B24, B25, B26, B27
R0: R00, R01, R02
R2: R24, R25, R26, R27
T0: T00, T01, T02, T03, T04, T05
T1: T10, T11, T17
UNUSED PINS IN USED BANKS: ONE SHARED 47k PULL-DOWN PER BANK Drive all tied unused bits LOW together whenever host -> DUT, including startup. See unused-bank-pins.csv for connector pad numbers.

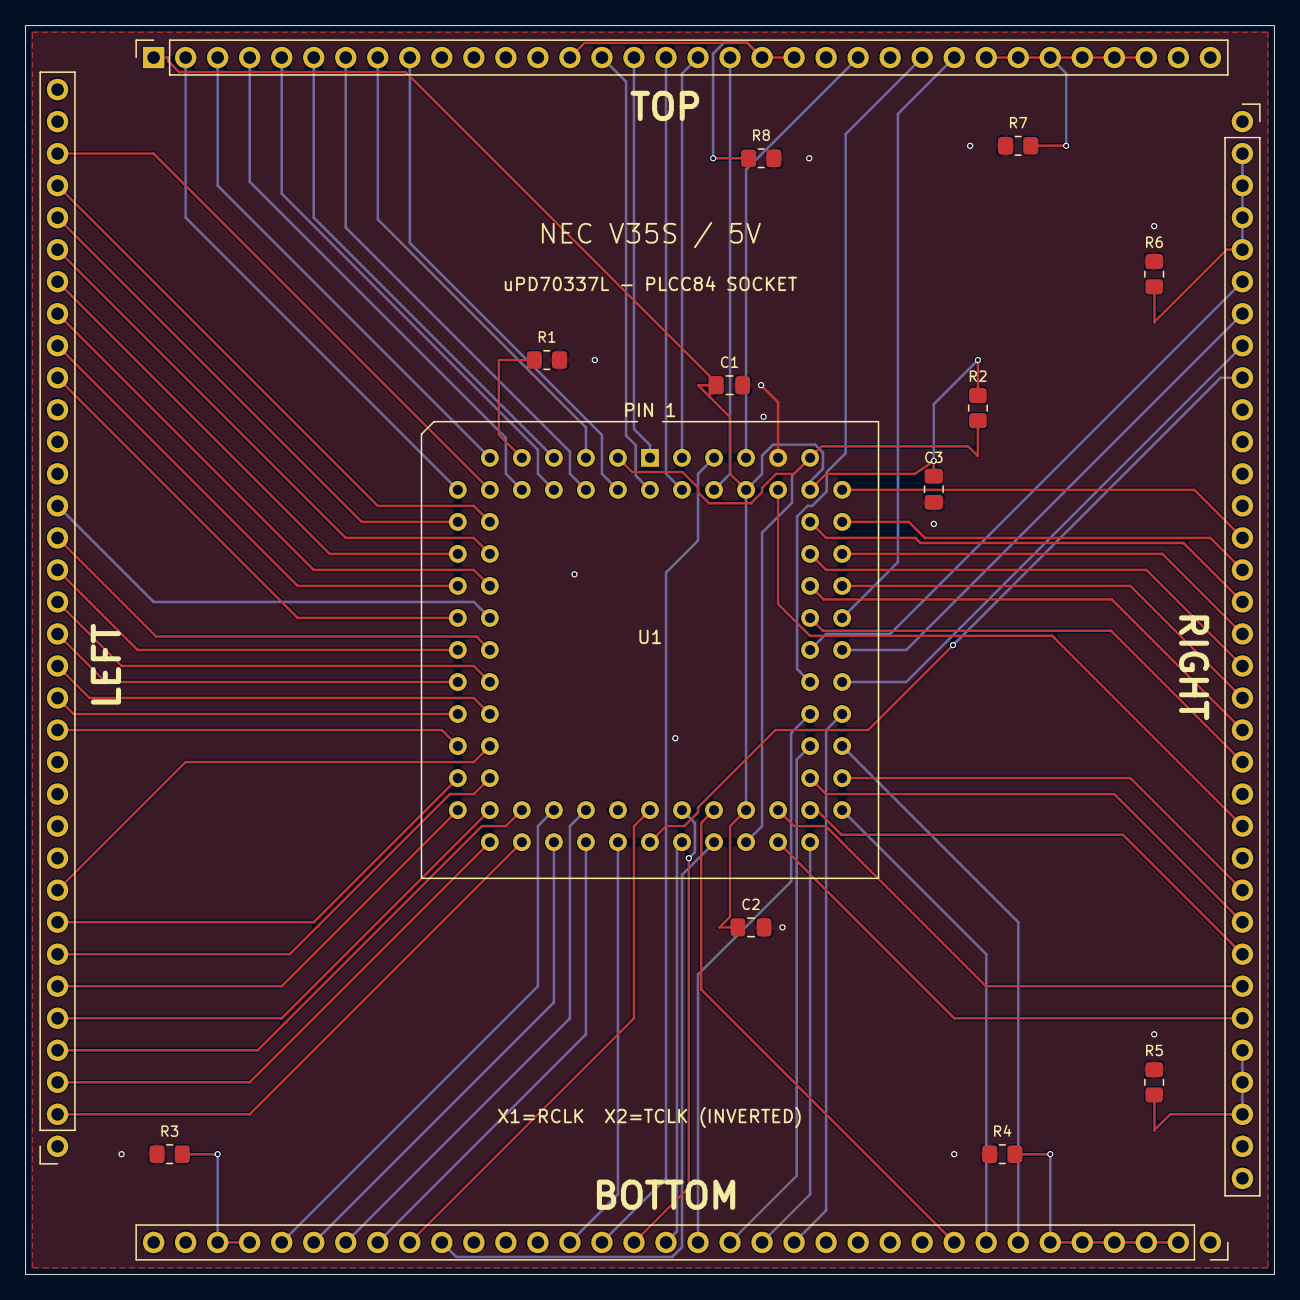
[picture p27: board v35s.kicad_pcb from above]

Board: 2 copper layers, 99.1 x 99.1 mm, 13 parts (0 on the bottom side), 85 nets.
