wickerwaka/nuBoard/hardware/68030/68030.kicad_pcb

## KiCad design hardware/68030/68030.kicad_pcb (2026-10-10)

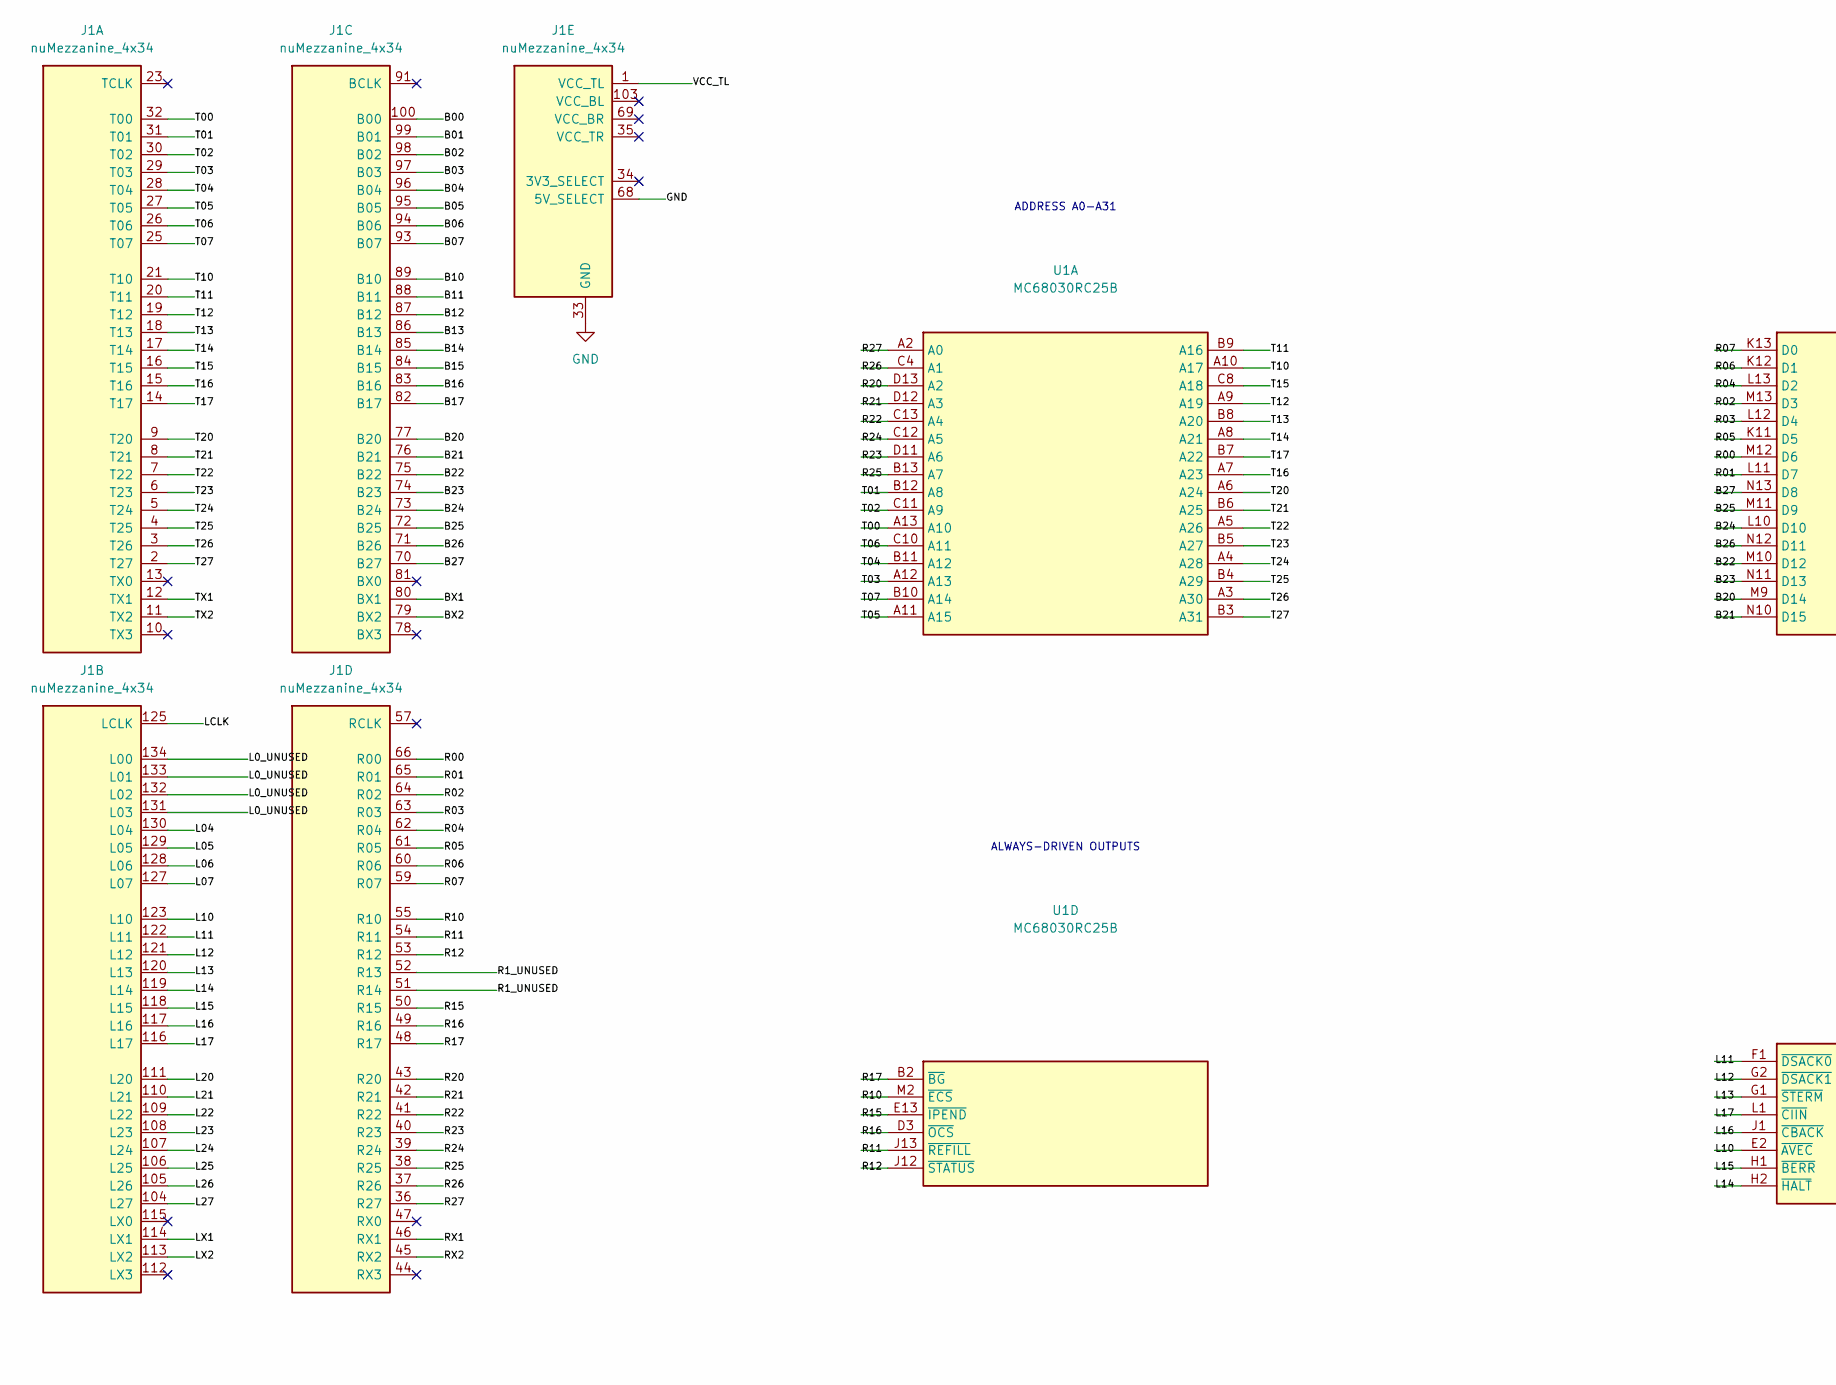
[picture p28: schematic 68030.kicad_sch, Motorola MC68030RC25B DUT daughter board, part in row 1, column 1]

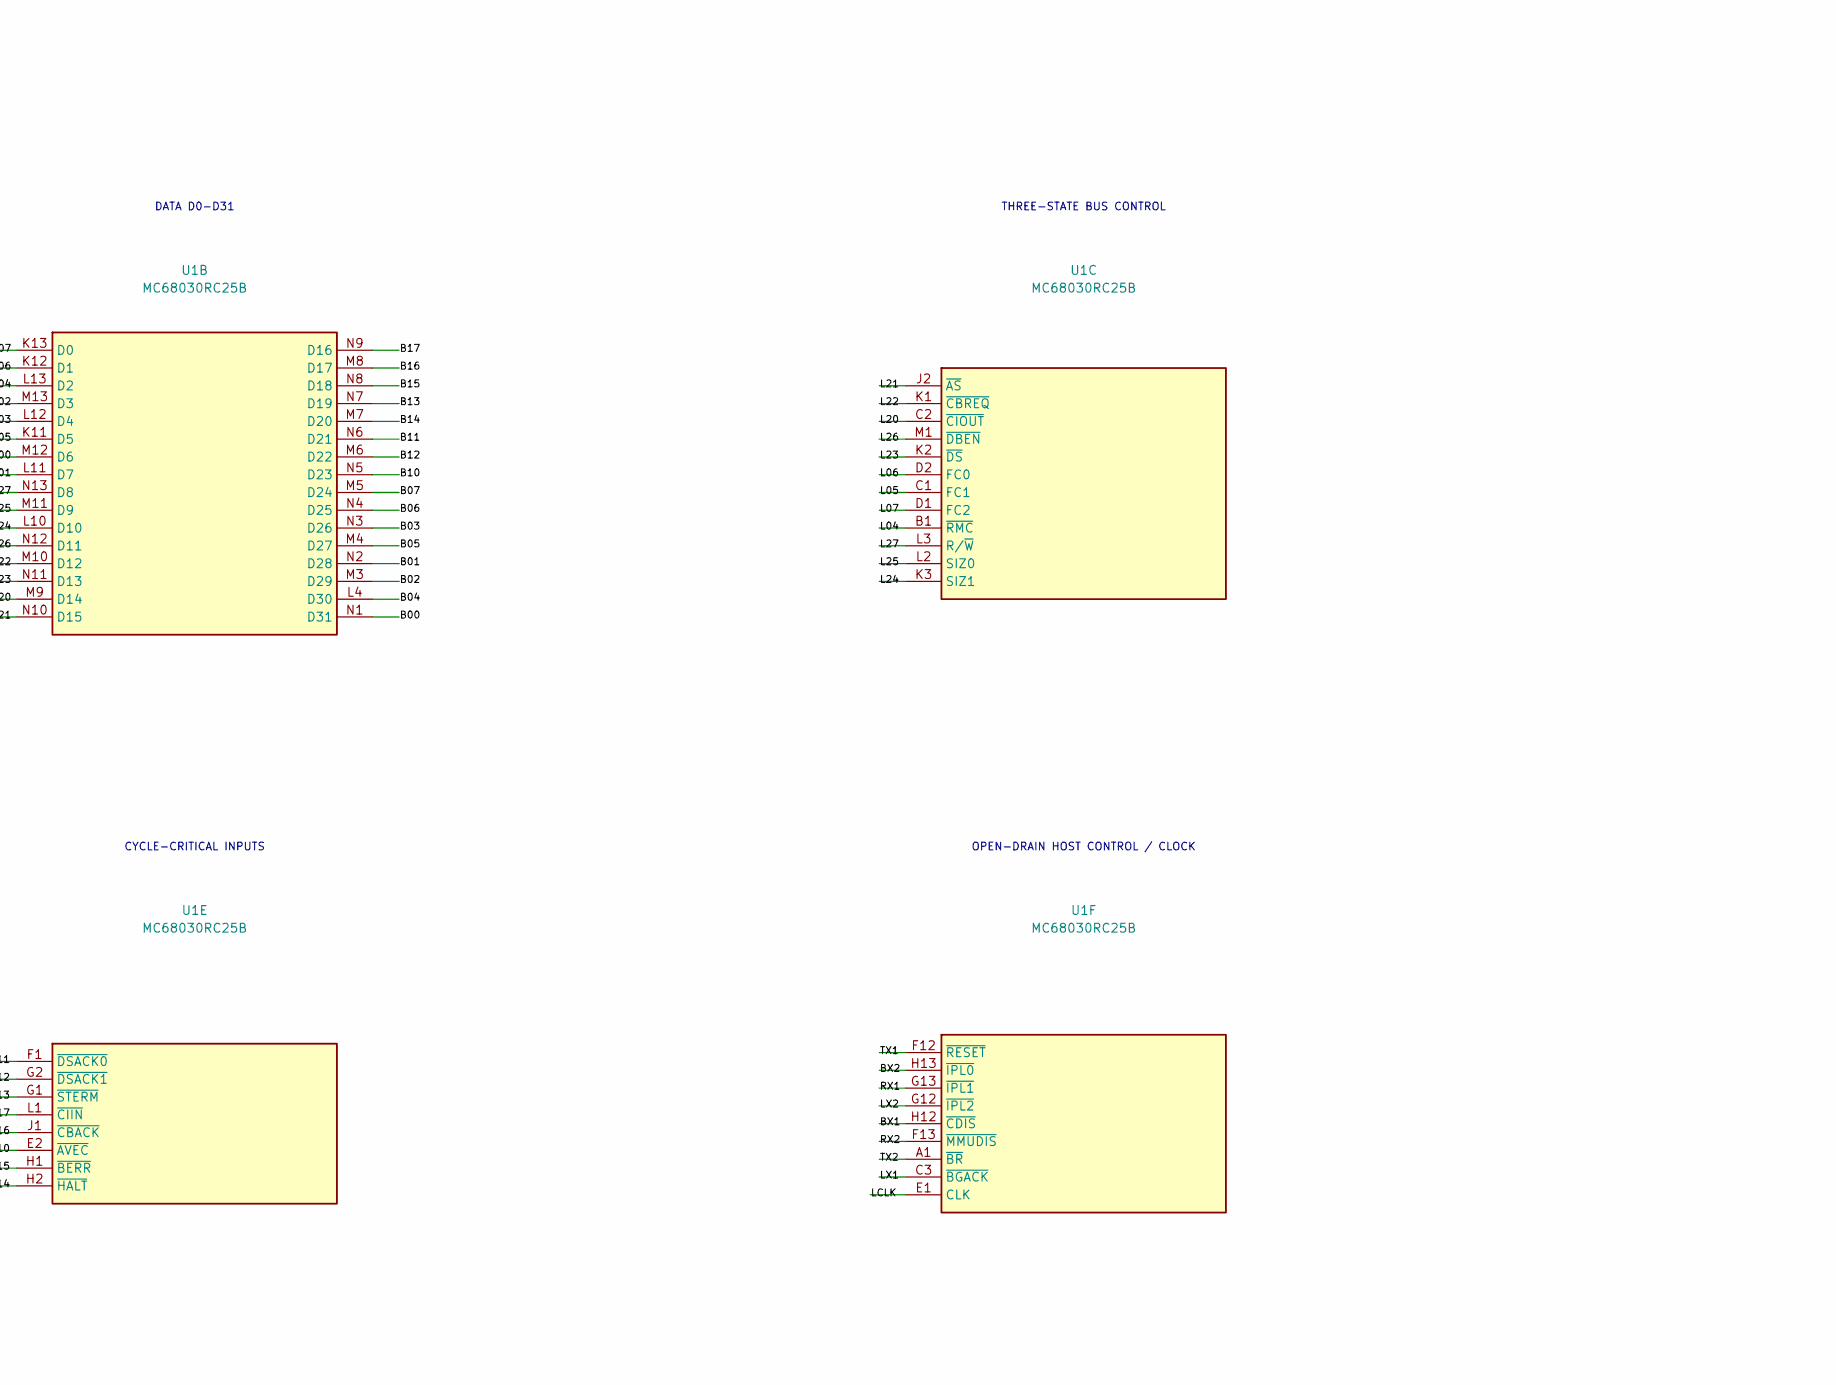
[picture p29: schematic 68030.kicad_sch, Motorola MC68030RC25B DUT daughter board, part in row 1, column 2]

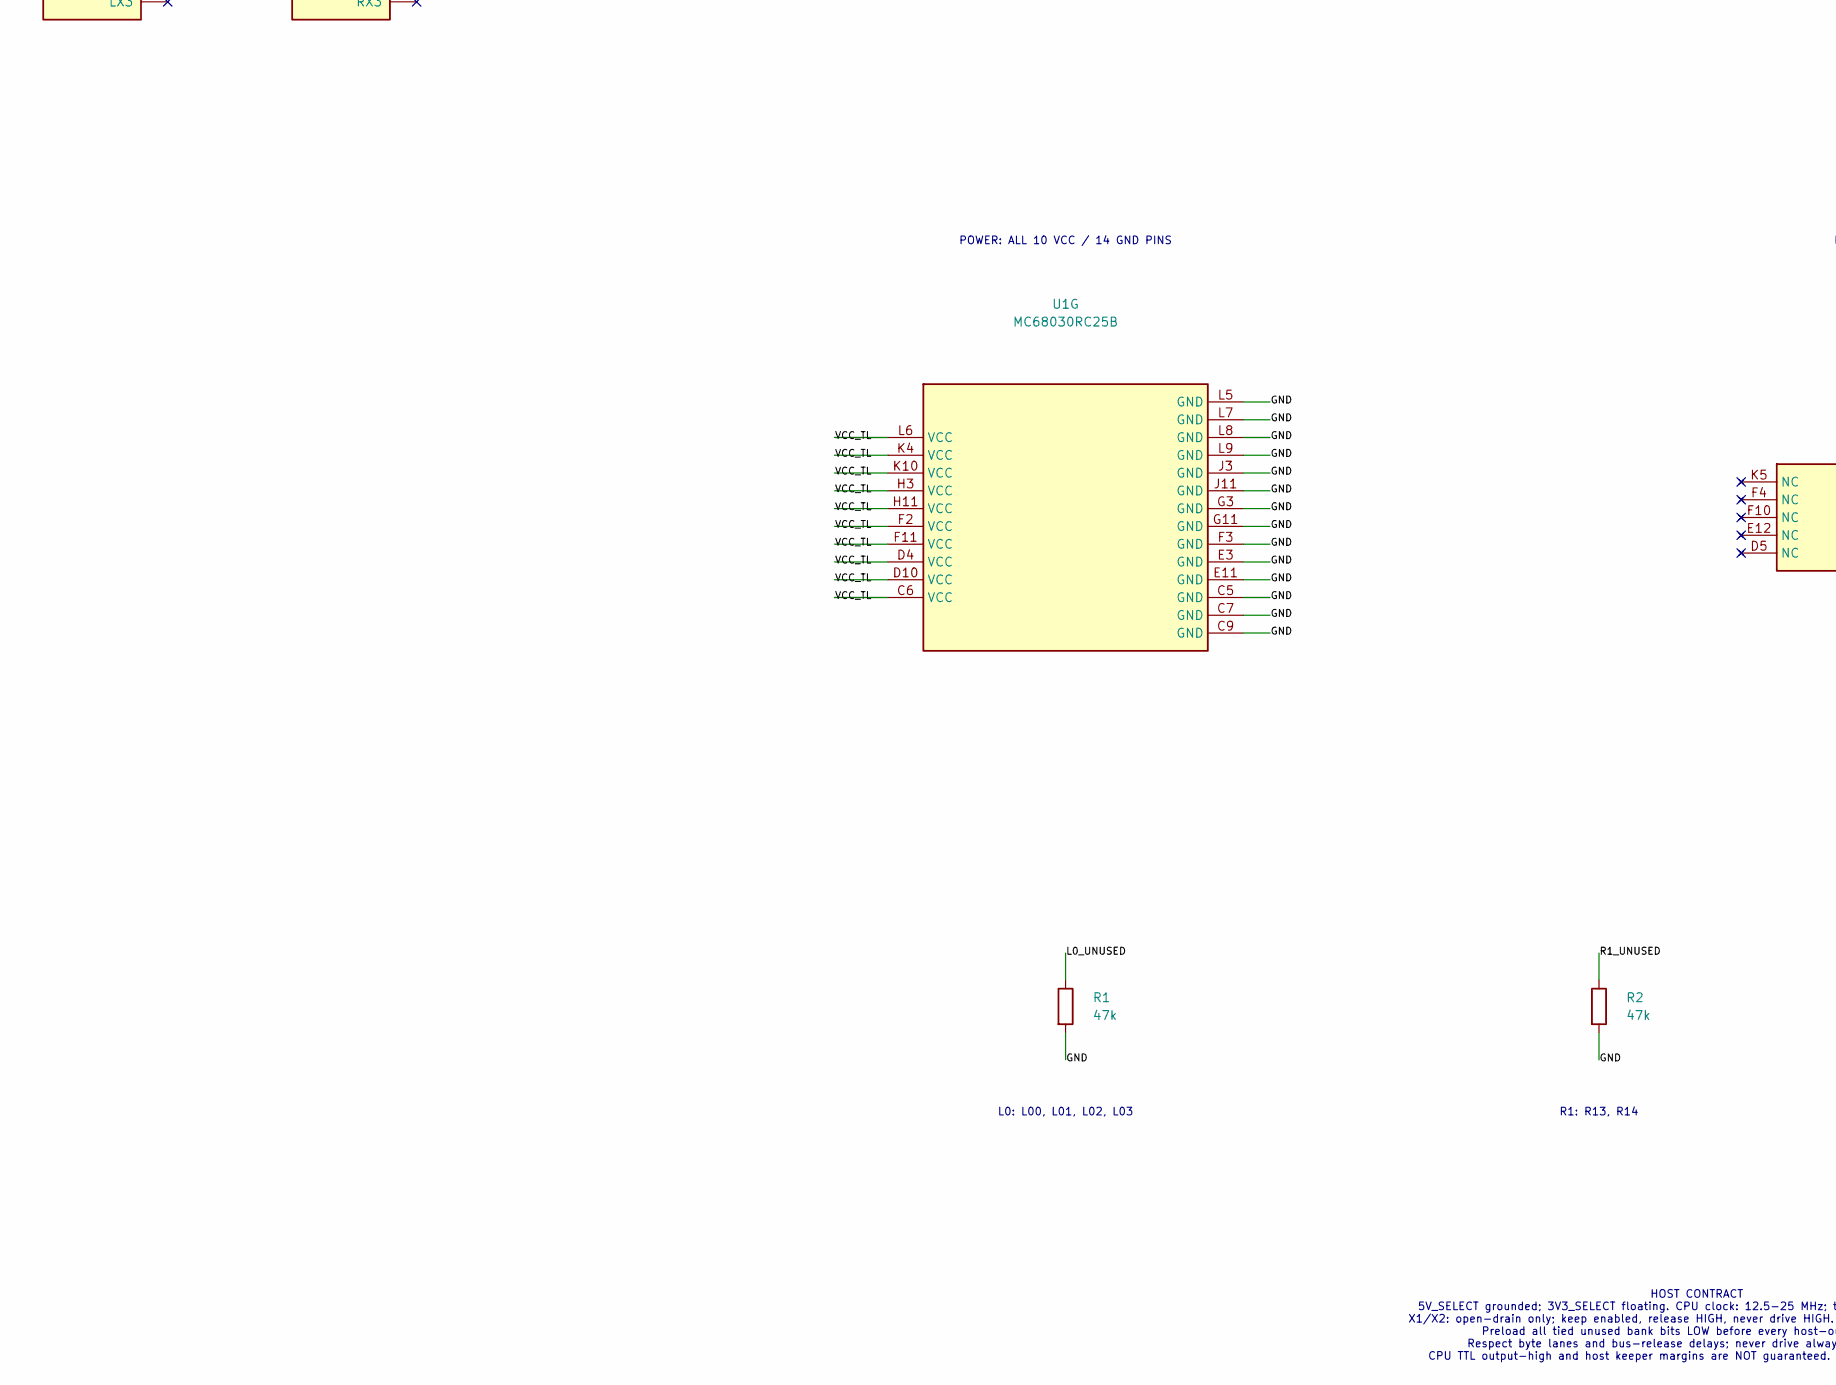
[picture p30: schematic 68030.kicad_sch, Motorola MC68030RC25B DUT daughter board, part in row 2, column 1]

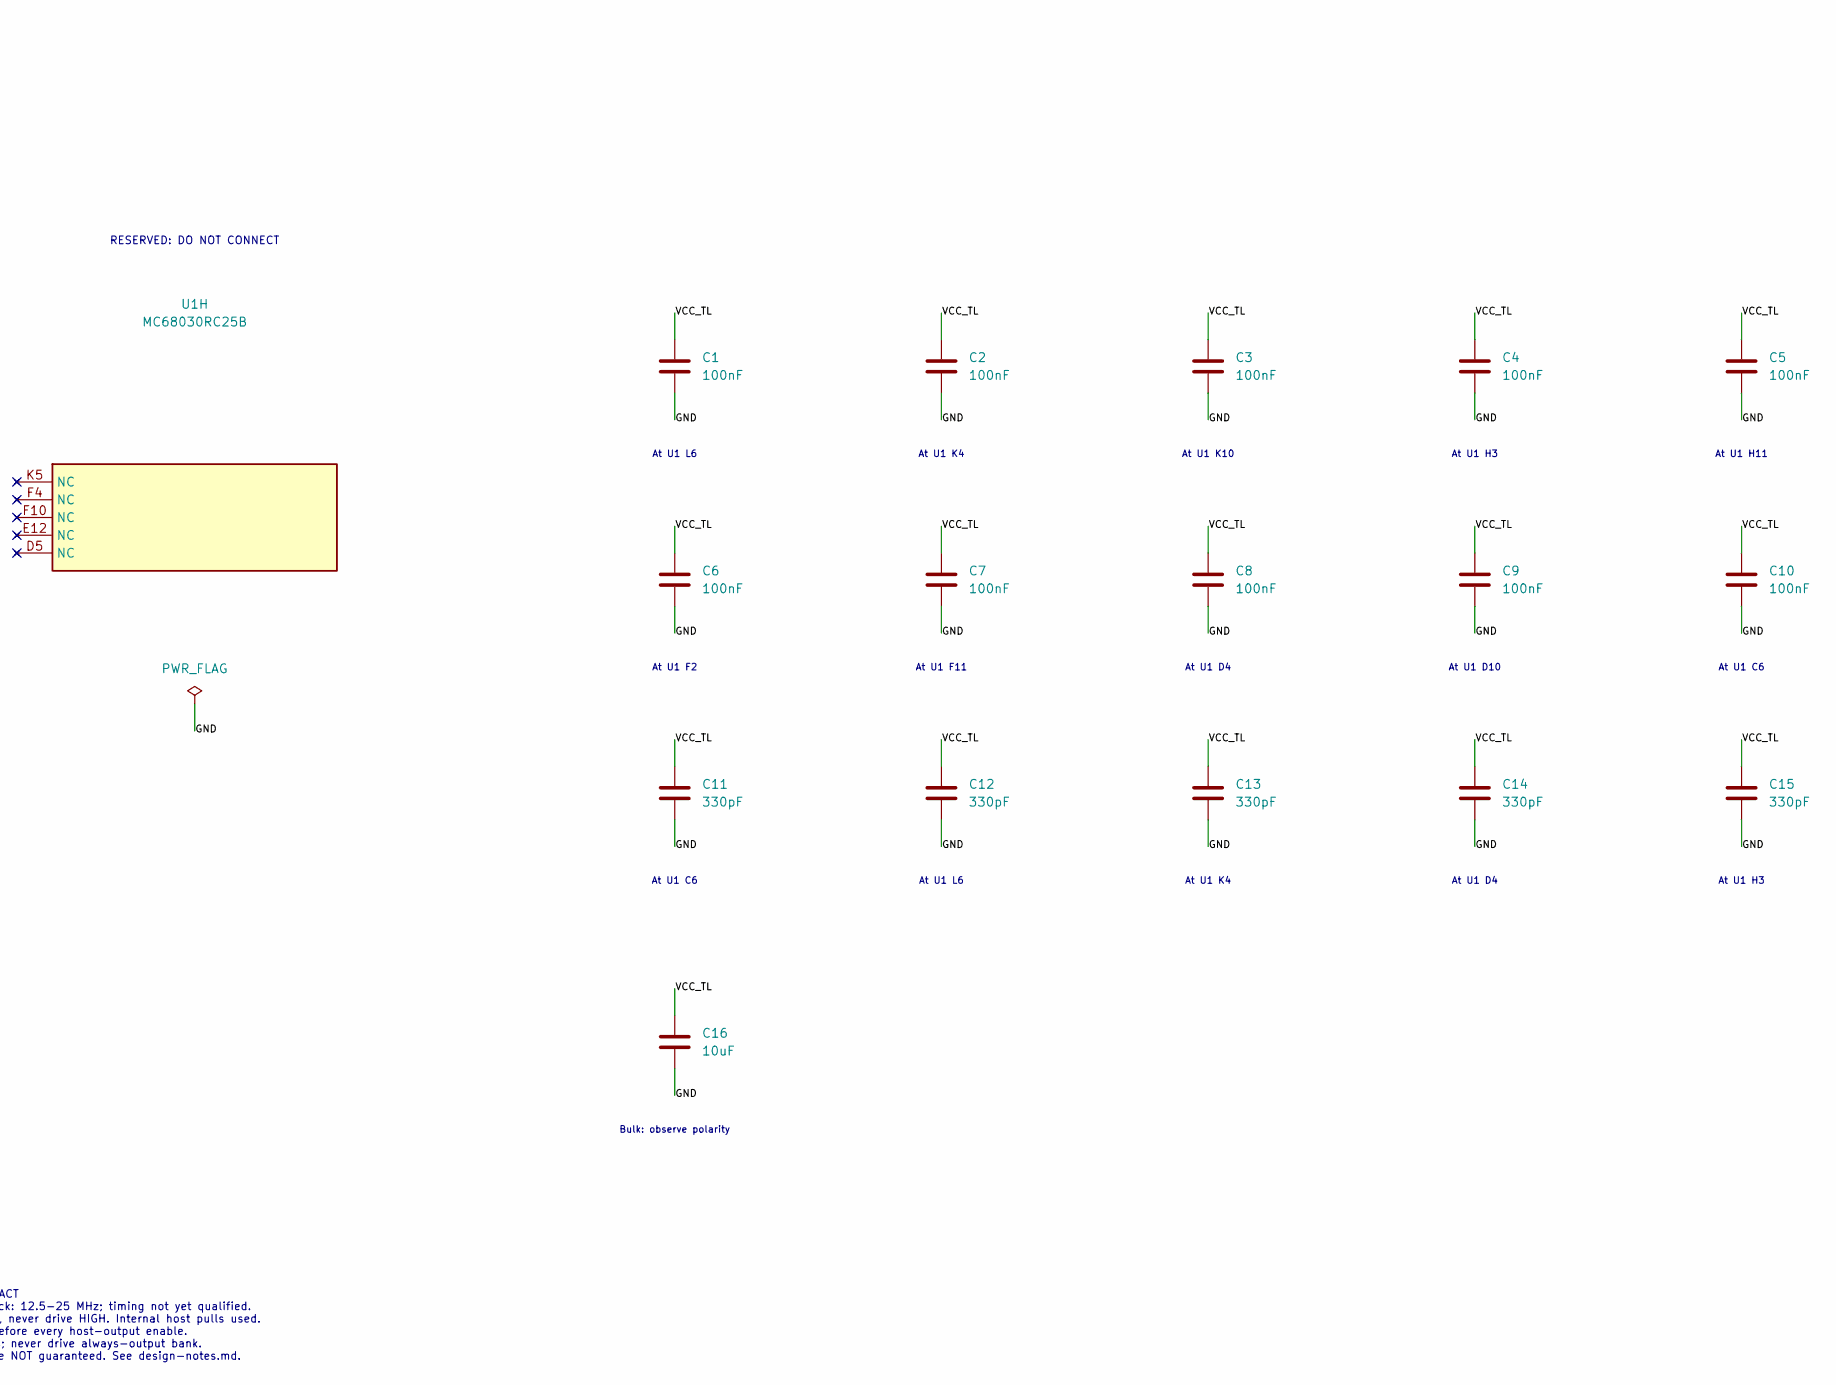
[picture p31: schematic 68030.kicad_sch, Motorola MC68030RC25B DUT daughter board, part in row 2, column 2]

Parts:
C1, C2, C3, C4, C5, C6, C7, C8, C9, C10: 100nF; C_0805_2012Metric_Pad1.18x1.45mm_HandSolder; Voltage 50V
C11, C12, C13, C14, C15: 330pF; C_0805_2012Metric_Pad1.18x1.45mm_HandSolder; Voltage 50V
C16: 10uF; C_0805_2012Metric_Pad1.18x1.45mm_HandSolder; Voltage 25V
J1: nuMezzanine_4x34; nuMezzanine_4x34_P2.54mm
R1, R2: 47k; R_0805_2012Metric_Pad1.20x1.40mm_HandSolder
U1: MC68030RC25B; CPGA-128_MC68030_RC

Connections:
/B00: J1.100 (B00_100), U1.N1 (D31)
/B01: J1.99 (B01_99), U1.N2 (D28)
/B02: J1.98 (B02_98), U1.M3 (D29)
/B03: J1.97 (B03_97), U1.N3 (D26)
/B04: J1.96 (B04_96), U1.L4 (D30)
/B05: J1.95 (B05_95), U1.M4 (D27)
/B06: J1.94 (B06_94), U1.N4 (D25)
/B07: J1.93 (B07_93), U1.M5 (D24)
/B10: J1.89 (B10_89), U1.N5 (D23)
/B11: J1.88 (B11_88), U1.N6 (D21)
/B12: J1.87 (B12_87), U1.M6 (D22)
/B13: J1.86 (B13_86), U1.N7 (D19)
/B14: J1.85 (B14_85), U1.M7 (D20)
/B15: J1.84 (B15_84), U1.N8 (D18)
/B16: J1.83 (B16_83), U1.M8 (D17)
/B17: J1.82 (B17_82), U1.N9 (D16)
/B20: J1.77 (B20_77), U1.M9 (D14)
/B21: J1.76 (B21_76), U1.N10 (D15)
/B22: J1.75 (B22_75), U1.M10 (D12)
/B23: J1.74 (B23_74), U1.N11 (D13)
/B24: J1.73 (B24_73), U1.L10 (D10)
/B25: J1.72 (B25_72), U1.M11 (D9)
/B26: J1.71 (B26_71), U1.N12 (D11)
/B27: J1.70 (B27_70), U1.N13 (D8)
/BX1: J1.80 (BX1_80), U1.H12 (~CDIS)
/BX2: J1.79 (BX2_79), U1.H13 (~IPL0)
/L0_UNUSED: J1.131 (L03_131), J1.132 (L02_132), J1.133 (L01_133), J1.134 (L00_134), R1.1
/L04: J1.130 (L04_130), U1.B1 (~RMC)
/L05: J1.129 (L05_129), U1.C1 (FC1)
/L06: J1.128 (L06_128), U1.D2 (FC0)
/L07: J1.127 (L07_127), U1.D1 (FC2)
/L10: J1.123 (L10_123), U1.E2 (~AVEC)
/L11: J1.122 (L11_122), U1.F1 (~DSACK0)
/L12: J1.121 (L12_121), U1.G2 (~DSACK1)
/L13: J1.120 (L13_120), U1.G1 (~STERM)
/L14: J1.119 (L14_119), U1.H2 (~HALT)
/L15: J1.118 (L15_118), U1.H1 (~BERR)
/L16: J1.117 (L16_117), U1.J1 (~CBACK)
/L17: J1.116 (L17_116), U1.L1 (~CIIN)
/L20: J1.111 (L20_111), U1.C2 (~CIOUT)
/L21: J1.110 (L21_110), U1.J2 (~AS)
/L22: J1.109 (L22_109), U1.K1 (~CBREQ)
/L23: J1.108 (L23_108), U1.K2 (~DS)
/L24: J1.107 (L24_107), U1.K3 (SIZ1)
/L25: J1.106 (L25_106), U1.L2 (SIZ0)
/L26: J1.105 (L26_105), U1.M1 (~DBEN)
/L27: J1.104 (L27_104), U1.L3 (R/~W)
/LCLK: J1.125 (LCLK_125), U1.E1 (CLK)
/LX1: J1.114 (LX1_114), U1.C3 (~BGACK)
/LX2: J1.113 (LX2_113), U1.G12 (~IPL2)
/R00: J1.66 (R00_66), U1.M12 (D6)
/R01: J1.65 (R01_65), U1.L11 (D7)
/R1_UNUSED: J1.51 (R14_51), J1.52 (R13_52), R2.1
/R02: J1.64 (R02_64), U1.M13 (D3)
/R03: J1.63 (R03_63), U1.L12 (D4)
/R04: J1.62 (R04_62), U1.L13 (D2)
/R05: J1.61 (R05_61), U1.K11 (D5)
/R06: J1.60 (R06_60), U1.K12 (D1)
/R07: J1.59 (R07_59), U1.K13 (D0)
/R10: J1.55 (R10_55), U1.M2 (~ECS)
/R11: J1.54 (R11_54), U1.J13 (~REFILL)
/R12: J1.53 (R12_53), U1.J12 (~STATUS)
/R15: J1.50 (R15_50), U1.E13 (~IPEND)
/R16: J1.49 (R16_49), U1.D3 (~OCS)
/R17: J1.48 (R17_48), U1.B2 (~BG)
/R20: J1.43 (R20_43), U1.D13 (A2)
/R21: J1.42 (R21_42), U1.D12 (A3)
/R22: J1.41 (R22_41), U1.C13 (A4)
/R23: J1.40 (R23_40), U1.D11 (A6)
/R24: J1.39 (R24_39), U1.C12 (A5)
/R25: J1.38 (R25_38), U1.B13 (A7)
/R26: J1.37 (R26_37), U1.C4 (A1)
/R27: J1.36 (R27_36), U1.A2 (A0)
/RX1: J1.46 (RX1_46), U1.G13 (~IPL1)
/RX2: J1.45 (RX2_45), U1.F13 (~MMUDIS)
/T00: J1.32 (T00_32), U1.A13 (A10)
/T01: J1.31 (T01_31), U1.B12 (A8)
/T02: J1.30 (T02_30), U1.C11 (A9)
/T03: J1.29 (T03_29), U1.A12 (A13)
/T04: J1.28 (T04_28), U1.B11 (A12)
/T05: J1.27 (T05_27), U1.A11 (A15)
/T06: J1.26 (T06_26), U1.C10 (A11)
/T07: J1.25 (T07_25), U1.B10 (A14)
/T10: J1.21 (T10_21), U1.A10 (A17)
/T11: J1.20 (T11_20), U1.B9 (A16)
/T12: J1.19 (T12_19), U1.A9 (A19)
/T13: J1.18 (T13_18), U1.B8 (A20)
/T14: J1.17 (T14_17), U1.A8 (A21)
/T15: J1.16 (T15_16), U1.C8 (A18)
/T16: J1.15 (T16_15), U1.A7 (A23)
/T17: J1.14 (T17_14), U1.B7 (A22)
/T20: J1.9 (T20_9), U1.A6 (A24)
/T21: J1.8 (T21_8), U1.B6 (A25)
/T22: J1.7 (T22_7), U1.A5 (A26)
/T23: J1.6 (T23_6), U1.B5 (A27)
/T24: J1.5 (T24_5), U1.A4 (A28)
/T25: J1.4 (T25_4), U1.B4 (A29)
/T26: J1.3 (T26_3), U1.A3 (A30)
/T27: J1.2 (T27_2), U1.B3 (A31)
/TX1: J1.12 (TX1_12), U1.F12 (~RESET)
/TX2: J1.11 (TX2_11), U1.A1 (~BR)
/VCC_TL: C1.1, C2.1, C3.1, C4.1, C5.1, C6.1, C7.1, C8.1, C9.1, C10.1, C11.1, C12.1, C13.1, C14.1, C15.1, C16.1, J1.1 (VCC_TL_1), U1.C6 (VCC), U1.D4 (VCC), U1.D10 (VCC), U1.F2 (VCC), U1.F11 (VCC), U1.H3 (VCC), U1.H11 (VCC), U1.K4 (VCC), U1.K10 (VCC), U1.L6 (VCC)
GND: C1.2, C2.2, C3.2, C4.2, C5.2, C6.2, C7.2, C8.2, C9.2, C10.2, C11.2, C12.2, C13.2, C14.2, C15.2, C16.2, J1.22 (GND_22), J1.24 (GND_24), J1.33 (GND_33), J1.56 (GND_56), J1.58 (GND_58), J1.67 (GND_67), J1.68 (5V_SELECT_68), J1.90 (GND_90), J1.92 (GND_92), J1.101 (GND_101), J1.102 (GND), J1.124 (GND_124), J1.126 (GND_126), J1.135 (GND_135), J1.136 (GND), R1.2, R2.2, U1.C5 (GND), U1.C7 (GND), U1.C9 (GND), U1.E3 (GND), U1.E11 (GND), U1.F3 (GND), U1.G3 (GND), U1.G11 (GND), U1.J3 (GND), U1.J11 (GND), U1.L5 (GND), U1.L7 (GND), U1.L8 (GND), U1.L9 (GND)

Notes on the sheet:
ADDRESS A0-A31
DATA D0-D31
THREE-STATE BUS CONTROL
ALWAYS-DRIVEN OUTPUTS
CYCLE-CRITICAL INPUTS
OPEN-DRAIN HOST CONTROL / CLOCK
POWER: ALL 10 VCC / 14 GND PINS
RESERVED: DO NOT CONNECT
At U1 L6
At U1 K4
At U1 K10
At U1 H3
At U1 H11
At U1 F2
At U1 F11
At U1 D4
At U1 D10
At U1 C6
Bulk: observe polarity
L0: L00, L01, L02, L03
R1: R13, R14
HOST CONTRACT 5V_SELECT grounded; 3V3_SELECT floating. CPU clock: 12.5-25 MHz; timing not yet qualified. X1/X2: open-drain only; keep enabled, release HIGH, never drive HIGH. Internal host pulls used. Preload all tied unused bank bits LOW before every host-output enable. Respect byte lanes and bus-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

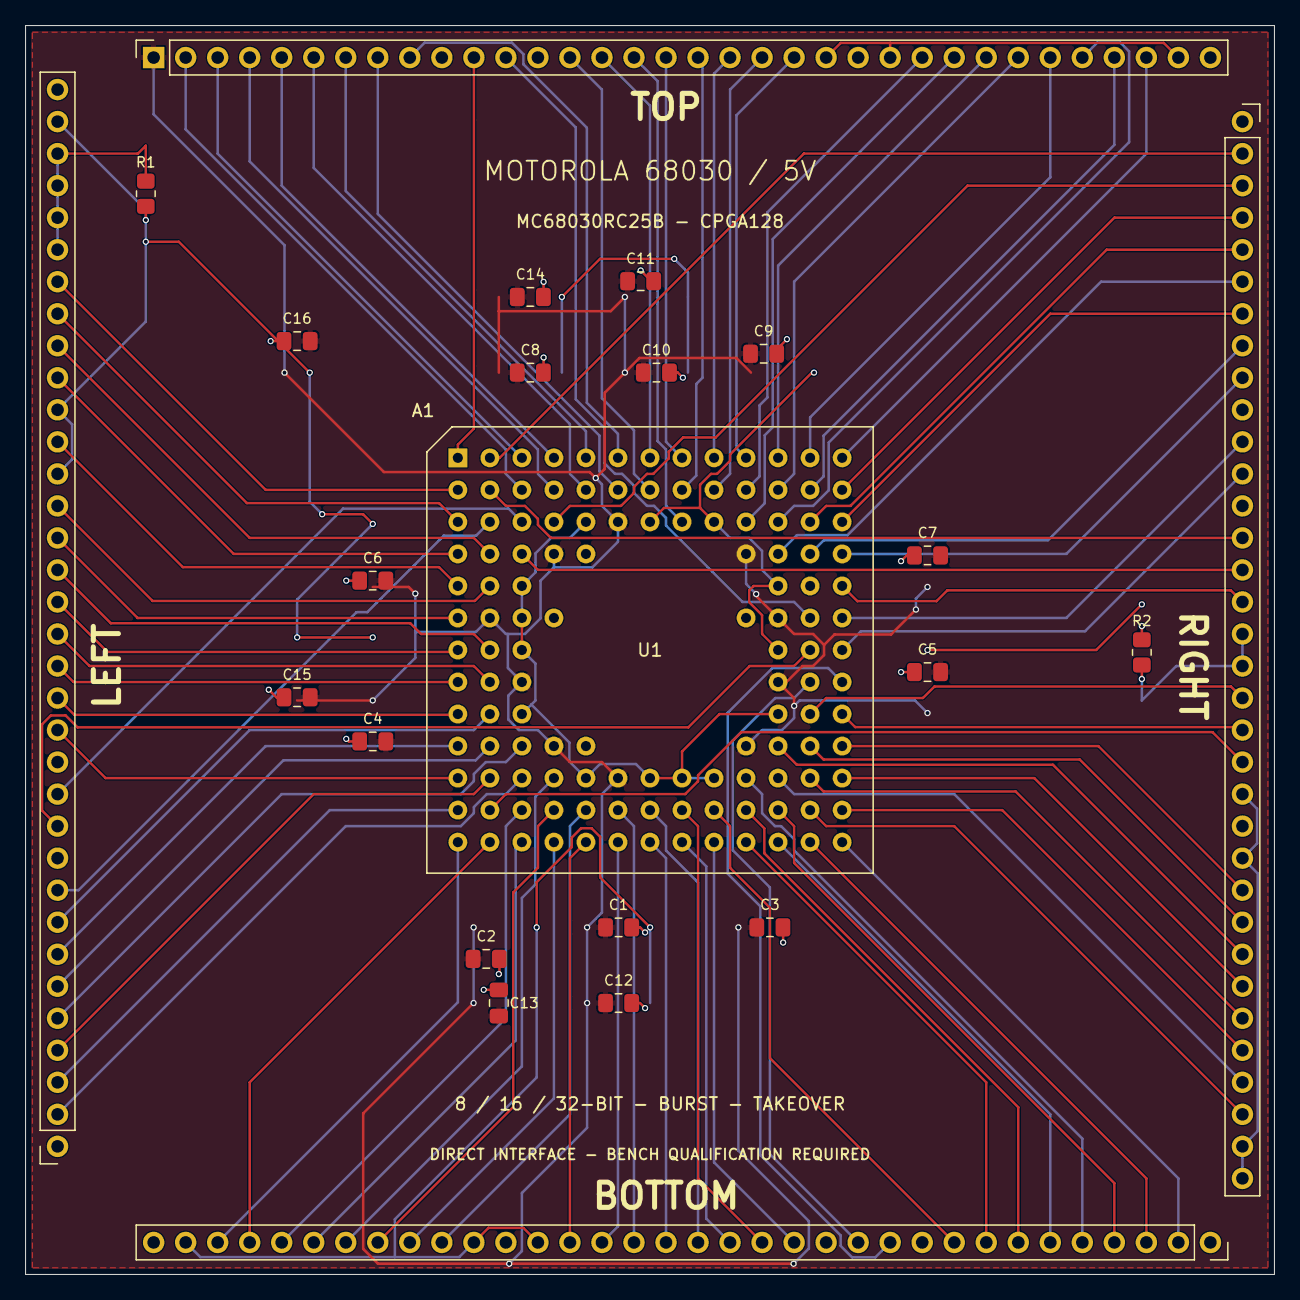
[picture p32: board 68030.kicad_pcb from above]

Board: 2 copper layers, 99.1 x 99.1 mm, 20 parts (0 on the bottom side), 103 nets.
