wickerwaka/nuBoard/hardware/z80/z80.kicad_pcb

## KiCad design hardware/z80/z80.kicad_pcb (2026-10-10)

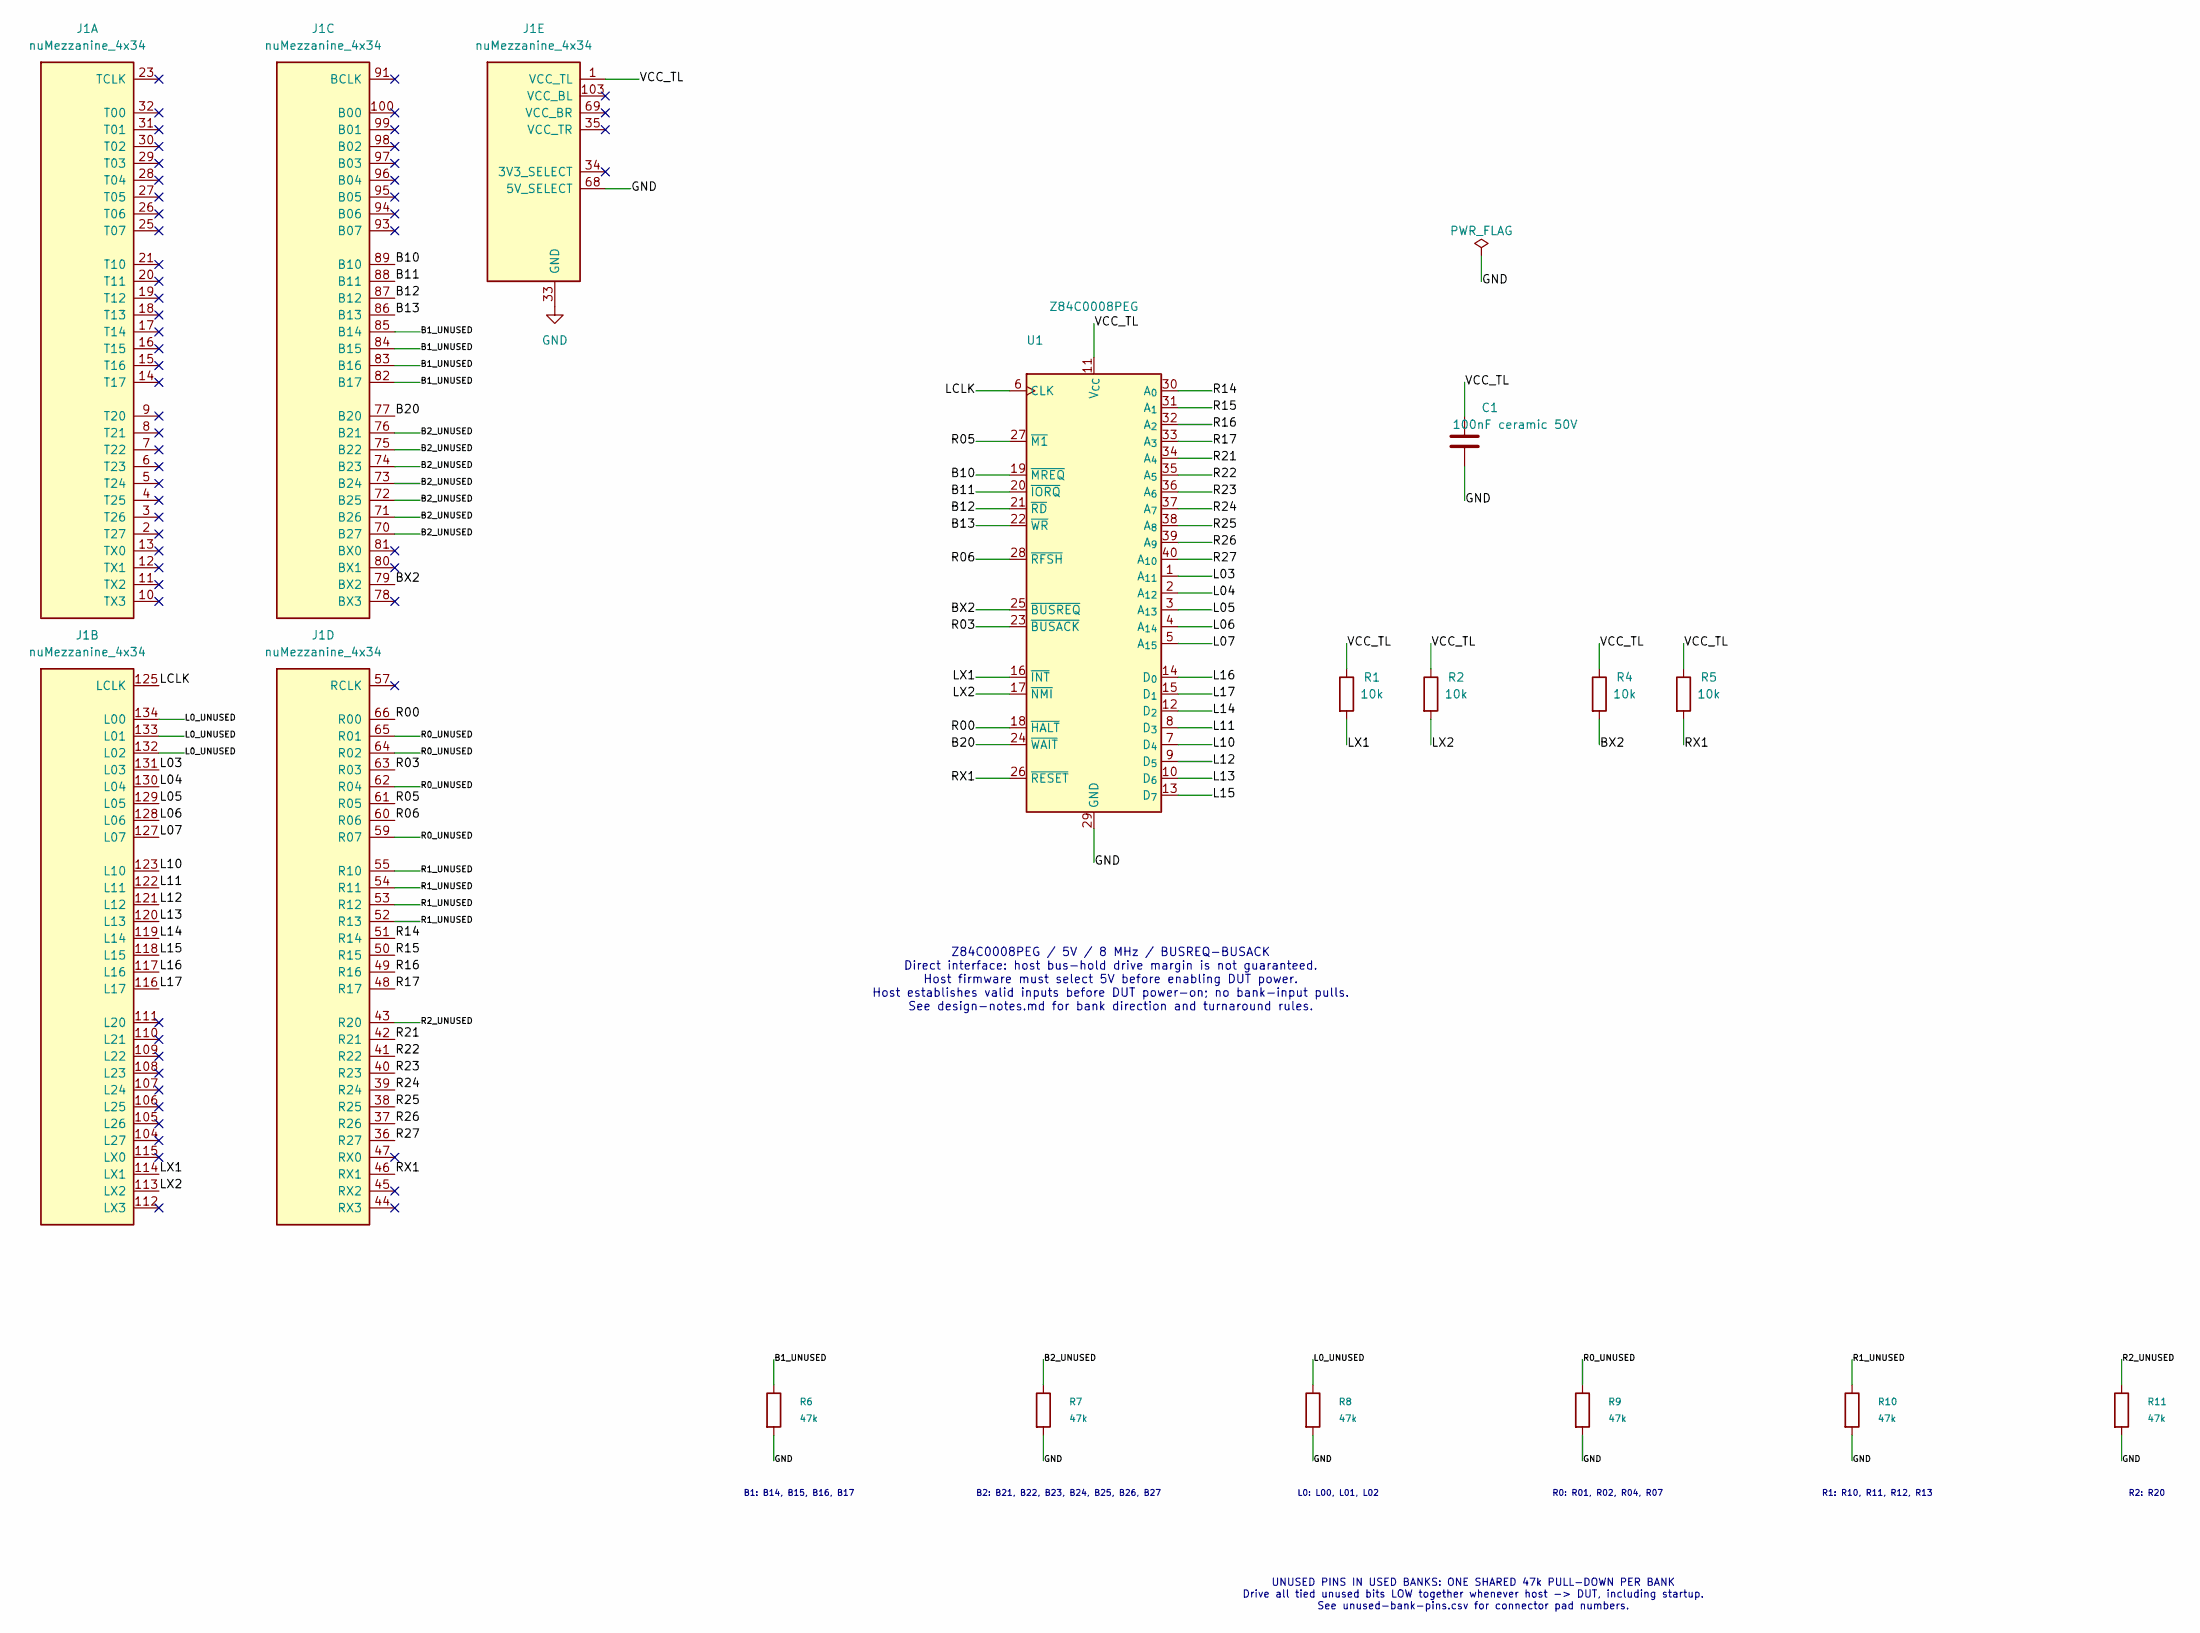
[picture p33: schematic z80.kicad_sch, Z80 DUT daughter board]

Parts:
C1: 100nF ceramic 50V; C_0805_2012Metric_Pad1.18x1.45mm_HandSolder
J1: nuMezzanine_4x34; nuMezzanine_4x34_P2.54mm
R1, R2, R4, R5: 10k; R_0805_2012Metric_Pad1.20x1.40mm_HandSolder
R6, R7, R8, R9, R10, R11: 47k; R_0805_2012Metric_Pad1.20x1.40mm_HandSolder
U1: Z84C0008PEG; DIP-40_W15.24mm_Socket

Connections:
/B1_UNUSED: J1.82 (B17_82), J1.83 (B16_83), J1.84 (B15_84), J1.85 (B14_85), R6.1
/B2_UNUSED: J1.70 (B27_70), J1.71 (B26_71), J1.72 (B25_72), J1.73 (B24_73), J1.74 (B23_74), J1.75 (B22_75), J1.76 (B21_76), R7.1
/B10: J1.89 (B10_89), U1.19 (~MREQ)
/B11: J1.88 (B11_88), U1.20 (~IORQ)
/B12: J1.87 (B12_87), U1.21 (~RD)
/B13: J1.86 (B13_86), U1.22 (~WR)
/B20: J1.77 (B20_77), U1.24 (~WAIT)
/BX2: J1.79 (BX2_79), R4.2, U1.25 (~BUSREQ)
/L0_UNUSED: J1.132 (L02_132), J1.133 (L01_133), J1.134 (L00_134), R8.1
/L03: J1.131 (L03_131), U1.1 (A_{11})
/L04: J1.130 (L04_130), U1.2 (A_{12})
/L05: J1.129 (L05_129), U1.3 (A_{13})
/L06: J1.128 (L06_128), U1.4 (A_{14})
/L07: J1.127 (L07_127), U1.5 (A_{15})
/L10: J1.123 (L10_123), U1.7 (D_{4})
/L11: J1.122 (L11_122), U1.8 (D_{3})
/L12: J1.121 (L12_121), U1.9 (D_{5})
/L13: J1.120 (L13_120), U1.10 (D_{6})
/L14: J1.119 (L14_119), U1.12 (D_{2})
/L15: J1.118 (L15_118), U1.13 (D_{7})
/L16: J1.117 (L16_117), U1.14 (D_{0})
/L17: J1.116 (L17_116), U1.15 (D_{1})
/LCLK: J1.125 (LCLK_125), U1.6 (CLK)
/LX1: J1.114 (LX1_114), R1.2, U1.16 (~INT)
/LX2: J1.113 (LX2_113), R2.2, U1.17 (~NMI)
/R00: J1.66 (R00_66), U1.18 (~HALT)
/R0_UNUSED: J1.59 (R07_59), J1.62 (R04_62), J1.64 (R02_64), J1.65 (R01_65), R9.1
/R1_UNUSED: J1.52 (R13_52), J1.53 (R12_53), J1.54 (R11_54), J1.55 (R10_55), R10.1
/R2_UNUSED: J1.43 (R20_43), R11.1
/R03: J1.63 (R03_63), U1.23 (~BUSACK)
/R05: J1.61 (R05_61), U1.27 (~M1)
/R06: J1.60 (R06_60), U1.28 (~RFSH)
/R14: J1.51 (R14_51), U1.30 (A_{0})
/R15: J1.50 (R15_50), U1.31 (A_{1})
/R16: J1.49 (R16_49), U1.32 (A_{2})
/R17: J1.48 (R17_48), U1.33 (A_{3})
/R21: J1.42 (R21_42), U1.34 (A_{4})
/R22: J1.41 (R22_41), U1.35 (A_{5})
/R23: J1.40 (R23_40), U1.36 (A_{6})
/R24: J1.39 (R24_39), U1.37 (A_{7})
/R25: J1.38 (R25_38), U1.38 (A_{8})
/R26: J1.37 (R26_37), U1.39 (A_{9})
/R27: J1.36 (R27_36), U1.40 (A_{10})
/RX1: J1.46 (RX1_46), R5.2, U1.26 (~RESET)
/VCC_TL: C1.1, J1.1 (VCC_TL_1), R1.1, R2.1, R4.1, R5.1, U1.11 (V_{CC})
GND: C1.2, J1.22 (GND_22), J1.24 (GND_24), J1.33 (GND_33), J1.56 (GND_56), J1.58 (GND_58), J1.67 (GND_67), J1.68 (5V_SELECT_68), J1.90 (GND_90), J1.92 (GND_92), J1.101 (GND_101), J1.102 (GND), J1.124 (GND_124), J1.126 (GND_126), J1.135 (GND_135), J1.136 (GND), R6.2, R7.2, R8.2, R9.2, R10.2, R11.2, U1.29 (GND)

Notes on the sheet:
Z84C0008PEG / 5V / 8 MHz / BUSREQ-BUSACK Direct interface: host bus-hold drive margin is not guaranteed. Host firmware must select 5V before enabling DUT power. Host establishes valid inputs before DUT power-on; no bank-input pulls. See design-notes.md for bank direction and turnaround rules.
B1: B14, B15, B16, B17
B2: B21, B22, B23, B24, B25, B26, B27
L0: L00, L01, L02
R0: R01, R02, R04, R07
R1: R10, R11, R12, R13
R2: R20
UNUSED PINS IN USED BANKS: ONE SHARED 47k PULL-DOWN PER BANK Drive all tied unused bits LOW together whenever host -> DUT, including startup. See unused-bank-pins.csv for connector pad numbers.

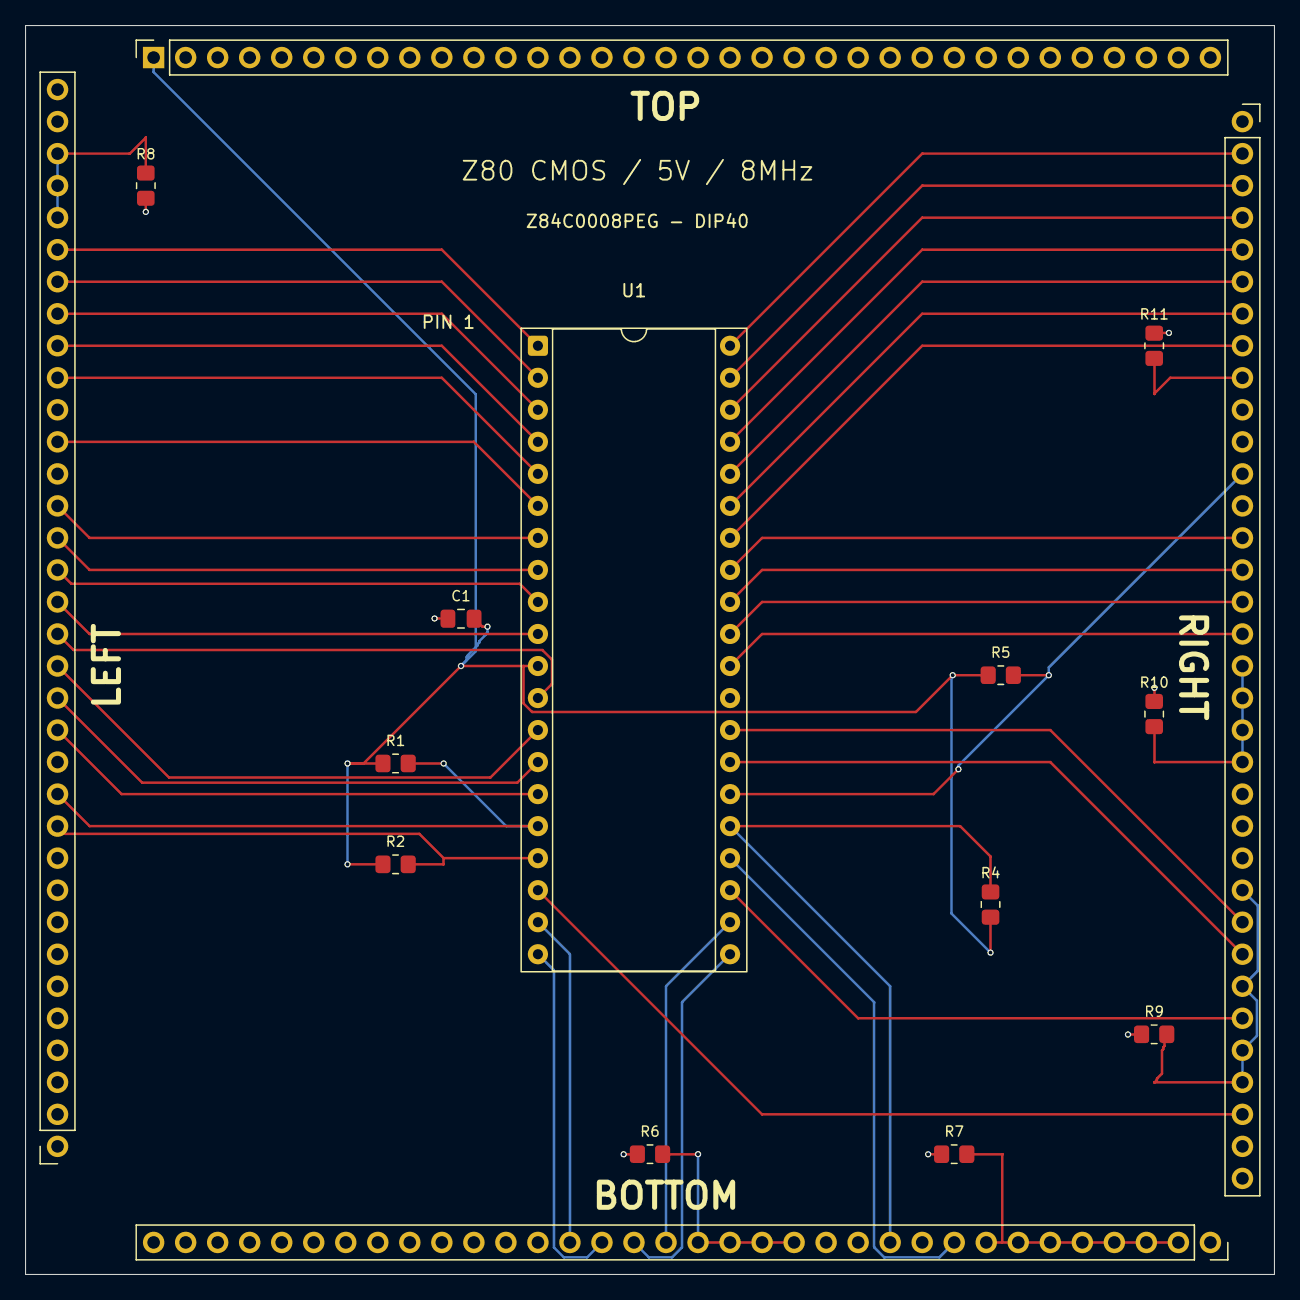
[picture p34: board z80.kicad_pcb from above]

Board: 2 copper layers, 99.1 x 99.1 mm, 13 parts (0 on the bottom side), 46 nets.
