wickerwaka/nuBoard/hardware/v33/v33.kicad_pcb

## KiCad design hardware/v33/v33.kicad_pcb (2026-10-10)

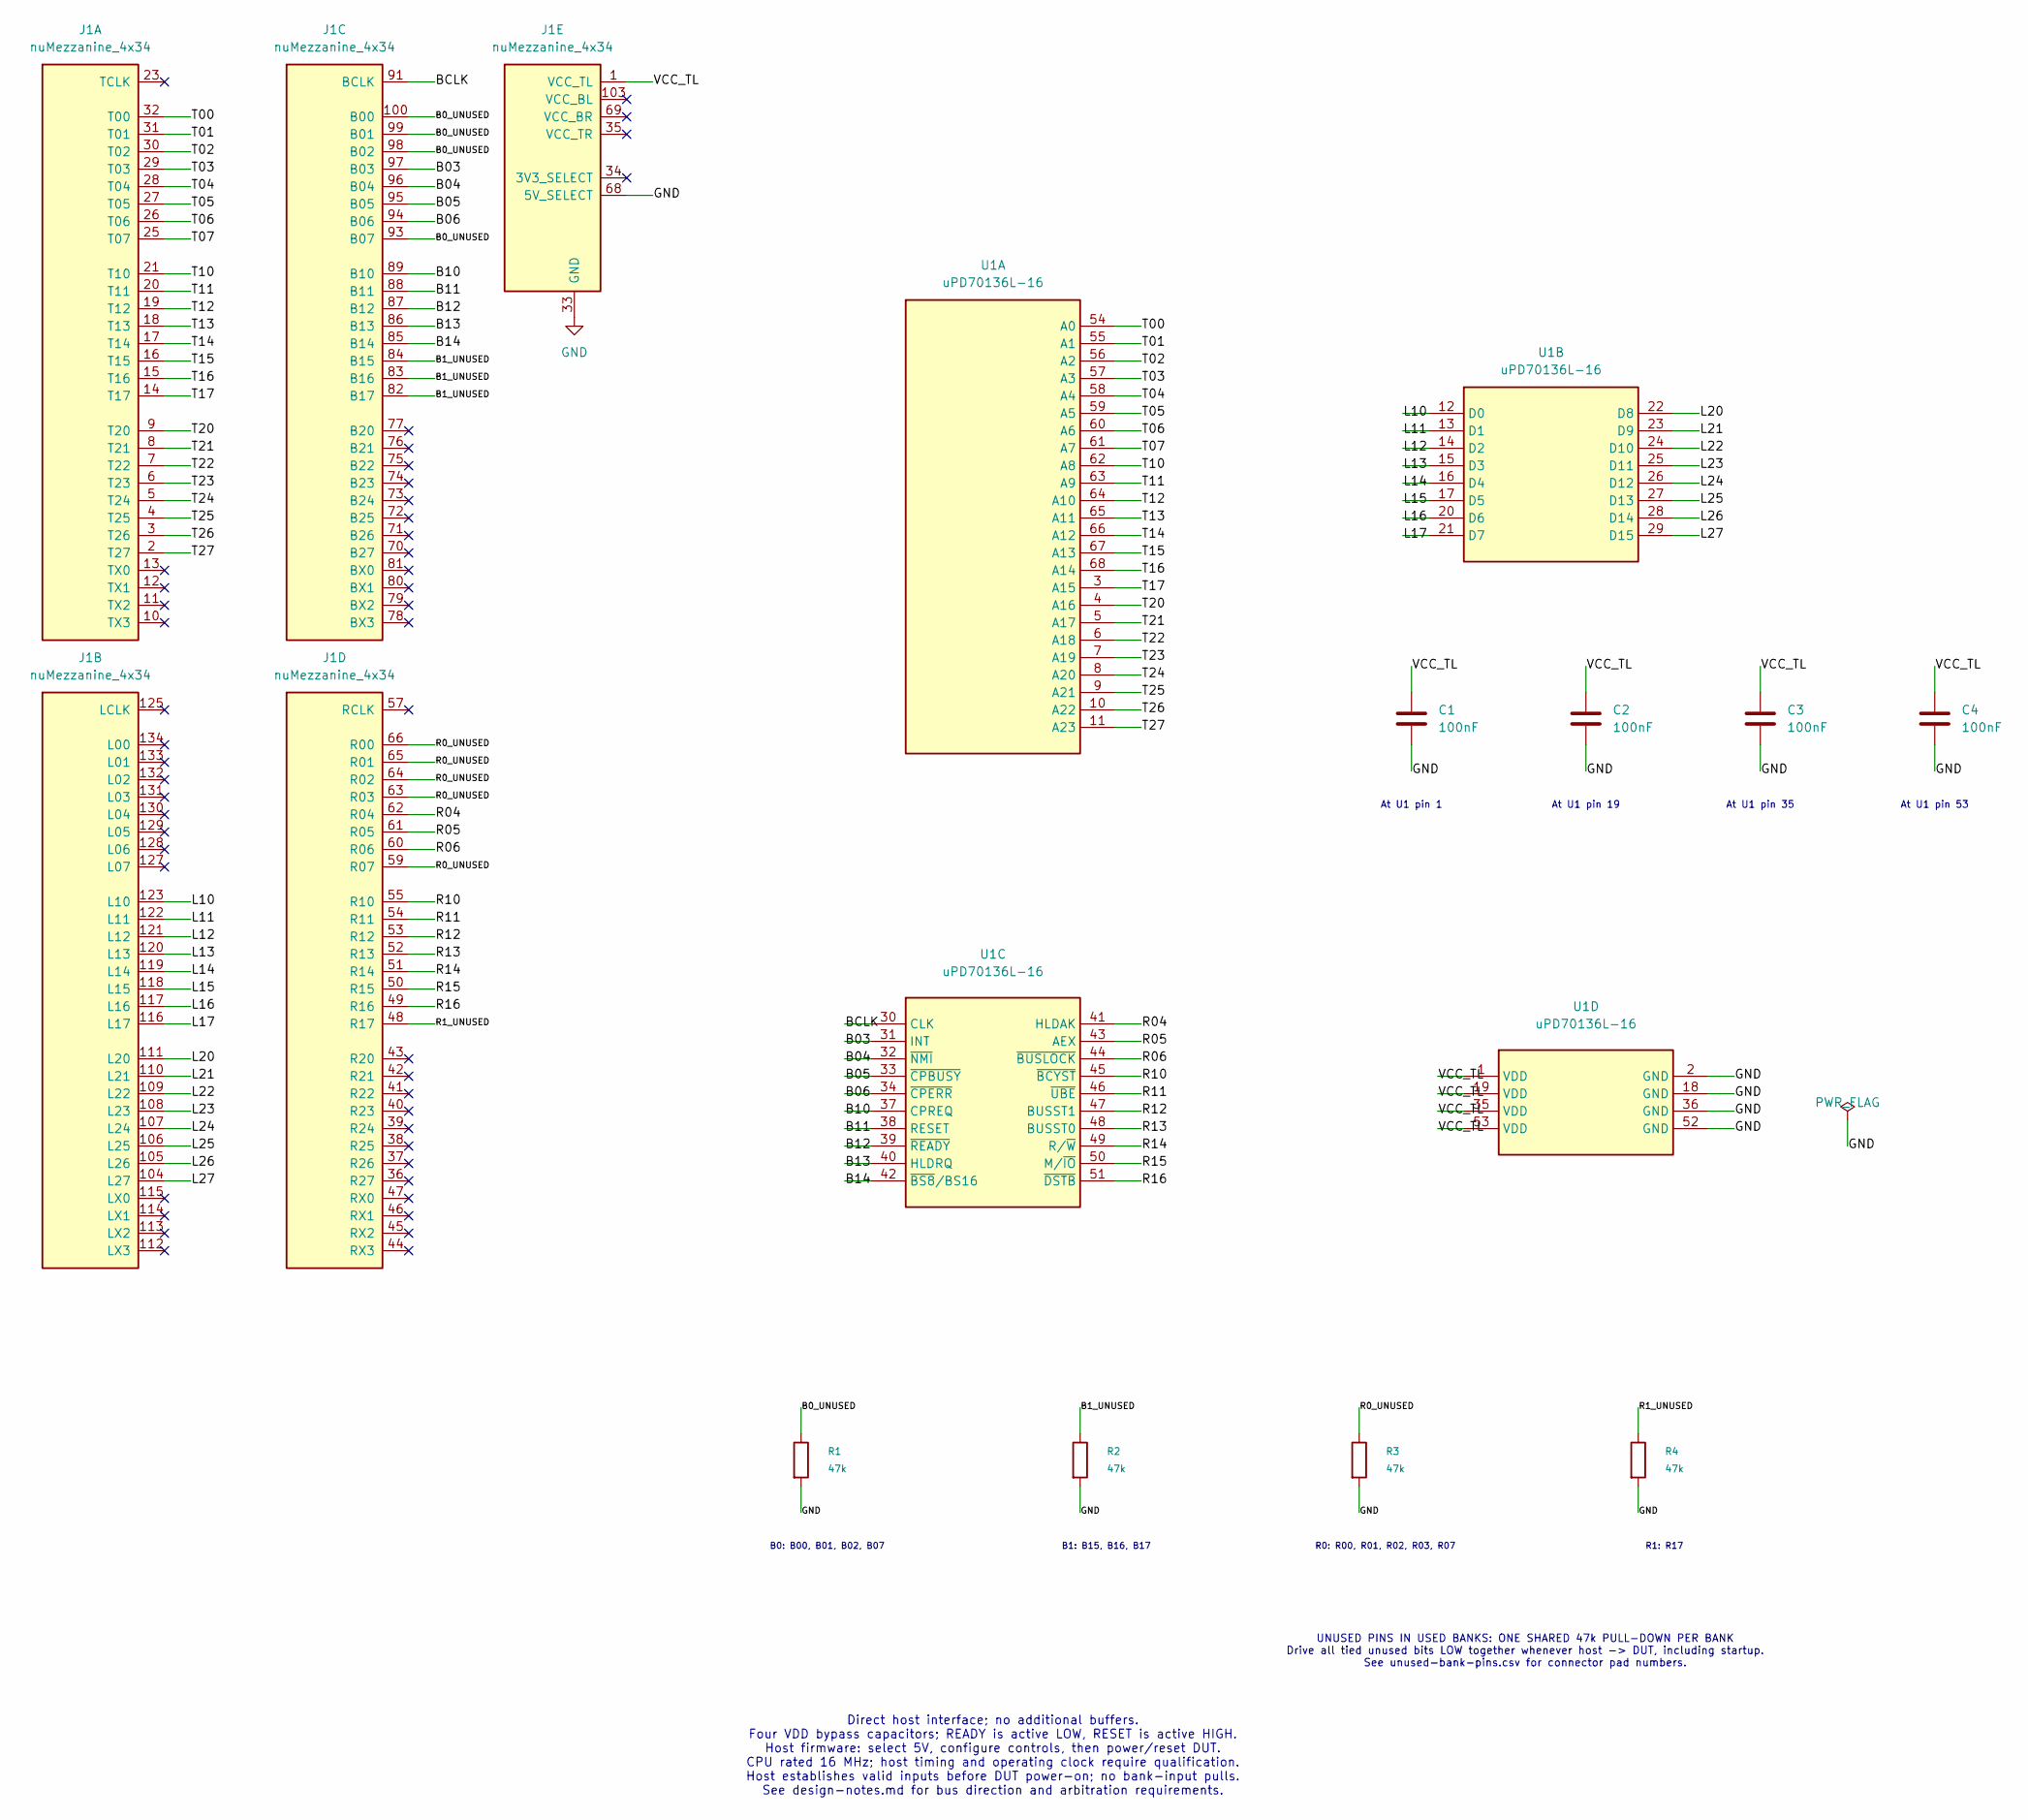
[picture p35: schematic v33.kicad_sch, NEC V33 DUT daughter board]

Parts:
C1, C2, C3, C4: 100nF; C_0805_2012Metric_Pad1.18x1.45mm_HandSolder; Voltage 50V
J1: nuMezzanine_4x34; nuMezzanine_4x34_P2.54mm
R1, R2, R3, R4: 47k; R_0805_2012Metric_Pad1.20x1.40mm_HandSolder
U1: uPD70136L-16; PLCC-68_THT-Socket

Connections:
/B0_UNUSED: J1.93 (B07_93), J1.98 (B02_98), J1.99 (B01_99), J1.100 (B00_100), R1.1
/B1_UNUSED: J1.82 (B17_82), J1.83 (B16_83), J1.84 (B15_84), R2.1
/B03: J1.97 (B03_97), U1.31 (INT)
/B04: J1.96 (B04_96), U1.32 (~NMI)
/B05: J1.95 (B05_95), U1.33 (~CPBUSY)
/B06: J1.94 (B06_94), U1.34 (~CPERR)
/B10: J1.89 (B10_89), U1.37 (CPREQ)
/B11: J1.88 (B11_88), U1.38 (RESET)
/B12: J1.87 (B12_87), U1.39 (~READY)
/B13: J1.86 (B13_86), U1.40 (HLDRQ)
/B14: J1.85 (B14_85), U1.42 (~BS8/BS16)
/BCLK: J1.91 (BCLK_91), U1.30 (CLK)
/L10: J1.123 (L10_123), U1.12 (D0)
/L11: J1.122 (L11_122), U1.13 (D1)
/L12: J1.121 (L12_121), U1.14 (D2)
/L13: J1.120 (L13_120), U1.15 (D3)
/L14: J1.119 (L14_119), U1.16 (D4)
/L15: J1.118 (L15_118), U1.17 (D5)
/L16: J1.117 (L16_117), U1.20 (D6)
/L17: J1.116 (L17_116), U1.21 (D7)
/L20: J1.111 (L20_111), U1.22 (D8)
/L21: J1.110 (L21_110), U1.23 (D9)
/L22: J1.109 (L22_109), U1.24 (D10)
/L23: J1.108 (L23_108), U1.25 (D11)
/L24: J1.107 (L24_107), U1.26 (D12)
/L25: J1.106 (L25_106), U1.27 (D13)
/L26: J1.105 (L26_105), U1.28 (D14)
/L27: J1.104 (L27_104), U1.29 (D15)
/R0_UNUSED: J1.59 (R07_59), J1.63 (R03_63), J1.64 (R02_64), J1.65 (R01_65), J1.66 (R00_66), R3.1
/R1_UNUSED: J1.48 (R17_48), R4.1
/R04: J1.62 (R04_62), U1.41 (HLDAK)
/R05: J1.61 (R05_61), U1.43 (AEX)
/R06: J1.60 (R06_60), U1.44 (~BUSLOCK)
/R10: J1.55 (R10_55), U1.45 (~BCYST)
/R11: J1.54 (R11_54), U1.46 (~UBE)
/R12: J1.53 (R12_53), U1.47 (BUSST1)
/R13: J1.52 (R13_52), U1.48 (BUSST0)
/R14: J1.51 (R14_51), U1.49 (R/~W)
/R15: J1.50 (R15_50), U1.50 (M/~IO)
/R16: J1.49 (R16_49), U1.51 (~DSTB)
/T00: J1.32 (T00_32), U1.54 (A0)
/T01: J1.31 (T01_31), U1.55 (A1)
/T02: J1.30 (T02_30), U1.56 (A2)
/T03: J1.29 (T03_29), U1.57 (A3)
/T04: J1.28 (T04_28), U1.58 (A4)
/T05: J1.27 (T05_27), U1.59 (A5)
/T06: J1.26 (T06_26), U1.60 (A6)
/T07: J1.25 (T07_25), U1.61 (A7)
/T10: J1.21 (T10_21), U1.62 (A8)
/T11: J1.20 (T11_20), U1.63 (A9)
/T12: J1.19 (T12_19), U1.64 (A10)
/T13: J1.18 (T13_18), U1.65 (A11)
/T14: J1.17 (T14_17), U1.66 (A12)
/T15: J1.16 (T15_16), U1.67 (A13)
/T16: J1.15 (T16_15), U1.68 (A14)
/T17: J1.14 (T17_14), U1.3 (A15)
/T20: J1.9 (T20_9), U1.4 (A16)
/T21: J1.8 (T21_8), U1.5 (A17)
/T22: J1.7 (T22_7), U1.6 (A18)
/T23: J1.6 (T23_6), U1.7 (A19)
/T24: J1.5 (T24_5), U1.8 (A20)
/T25: J1.4 (T25_4), U1.9 (A21)
/T26: J1.3 (T26_3), U1.10 (A22)
/T27: J1.2 (T27_2), U1.11 (A23)
/VCC_TL: C1.1, C2.1, C3.1, C4.1, J1.1 (VCC_TL_1), U1.1 (VDD), U1.19 (VDD), U1.35 (VDD), U1.53 (VDD)
GND: C1.2, C2.2, C3.2, C4.2, J1.22 (GND_22), J1.24 (GND_24), J1.33 (GND_33), J1.56 (GND_56), J1.58 (GND_58), J1.67 (GND_67), J1.68 (5V_SELECT_68), J1.90 (GND_90), J1.92 (GND_92), J1.101 (GND_101), J1.102 (GND), J1.124 (GND_124), J1.126 (GND_126), J1.135 (GND_135), J1.136 (GND), R1.2, R2.2, R3.2, R4.2, U1.2 (GND), U1.18 (GND), U1.36 (GND), U1.52 (GND)

Notes on the sheet:
At U1 pin 1
At U1 pin 19
At U1 pin 35
At U1 pin 53
Direct host interface; no additional buffers. Four VDD bypass capacitors; READY is active LOW, RESET is active HIGH. Host firmware: select 5V, configure controls, then power/reset DUT. CPU rated 16 MHz; host timing and operating clock require qualification. Host establishes valid inputs before DUT 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
B0: B00, B01, B02, B07
B1: B15, B16, B17
R0: R00, R01, R02, R03, R07
R1: R17
UNUSED PINS IN USED BANKS: ONE SHARED 47k PULL-DOWN PER BANK Drive all tied unused bits LOW together whenever host -> DUT, including startup. See unused-bank-pins.csv for connector pad numbers.

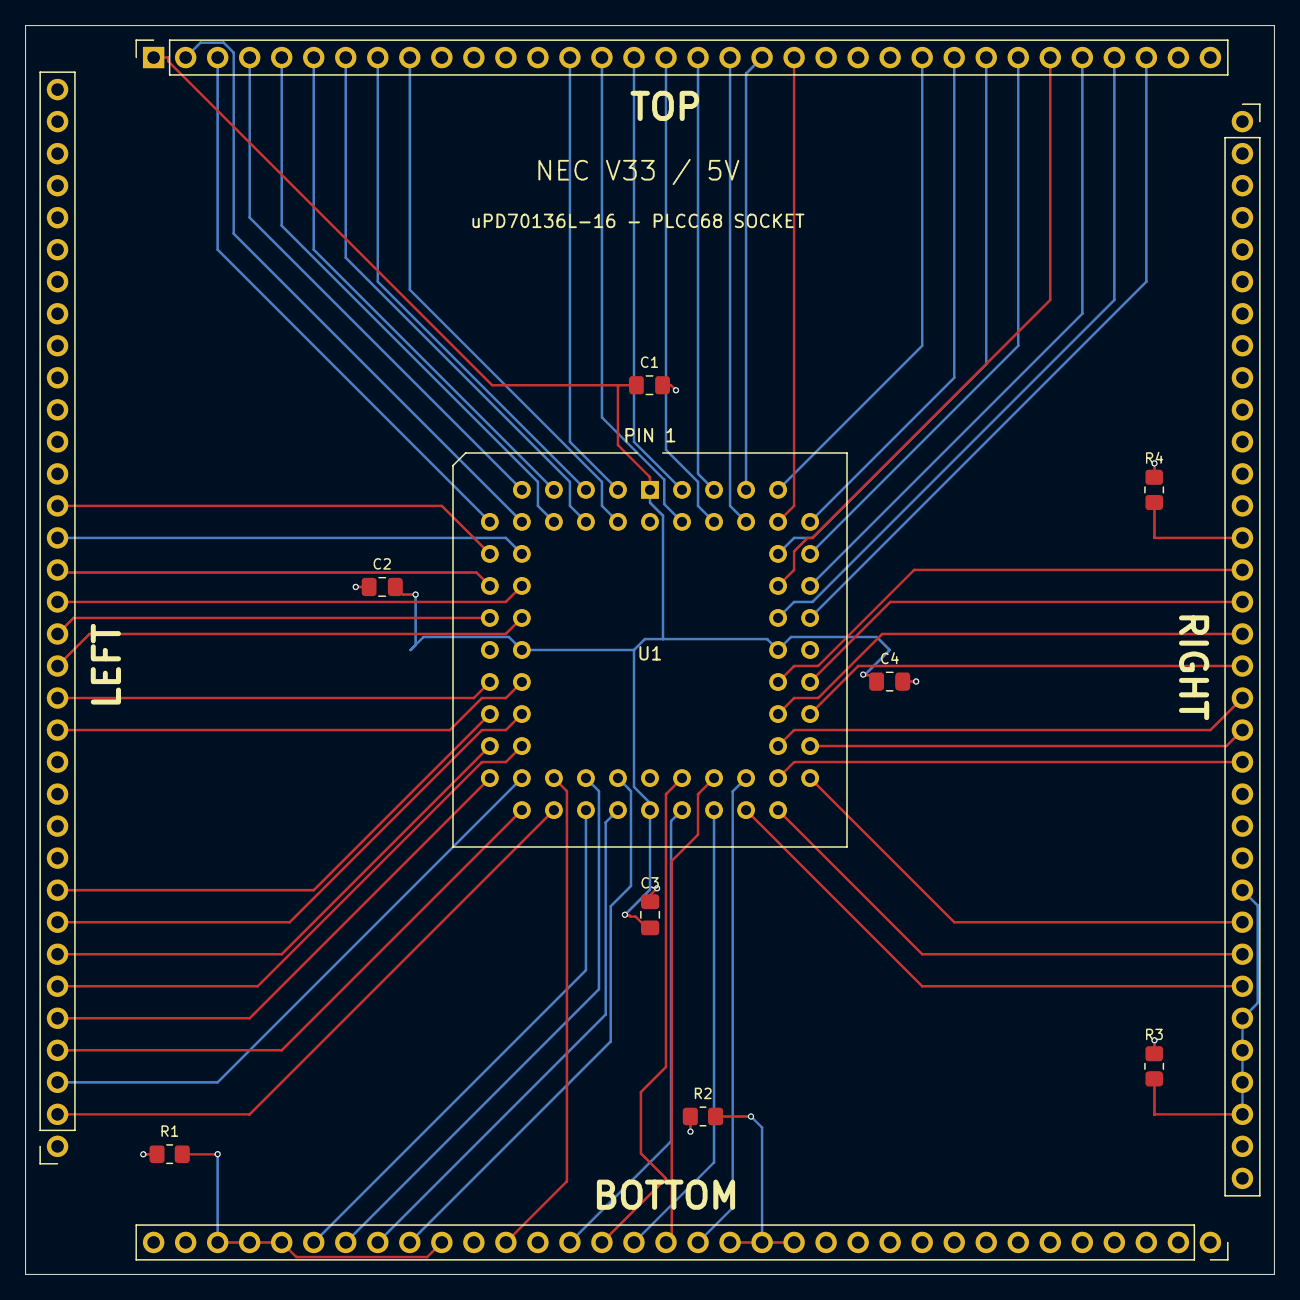
[picture p36: board v33.kicad_pcb from above]

Board: 2 copper layers, 99.1 x 99.1 mm, 10 parts (0 on the bottom side), 66 nets.
