wickerwaka/nuBoard/hardware/68000/68000.kicad_pcb

## KiCad design hardware/68000/68000.kicad_pcb (2026-10-10)

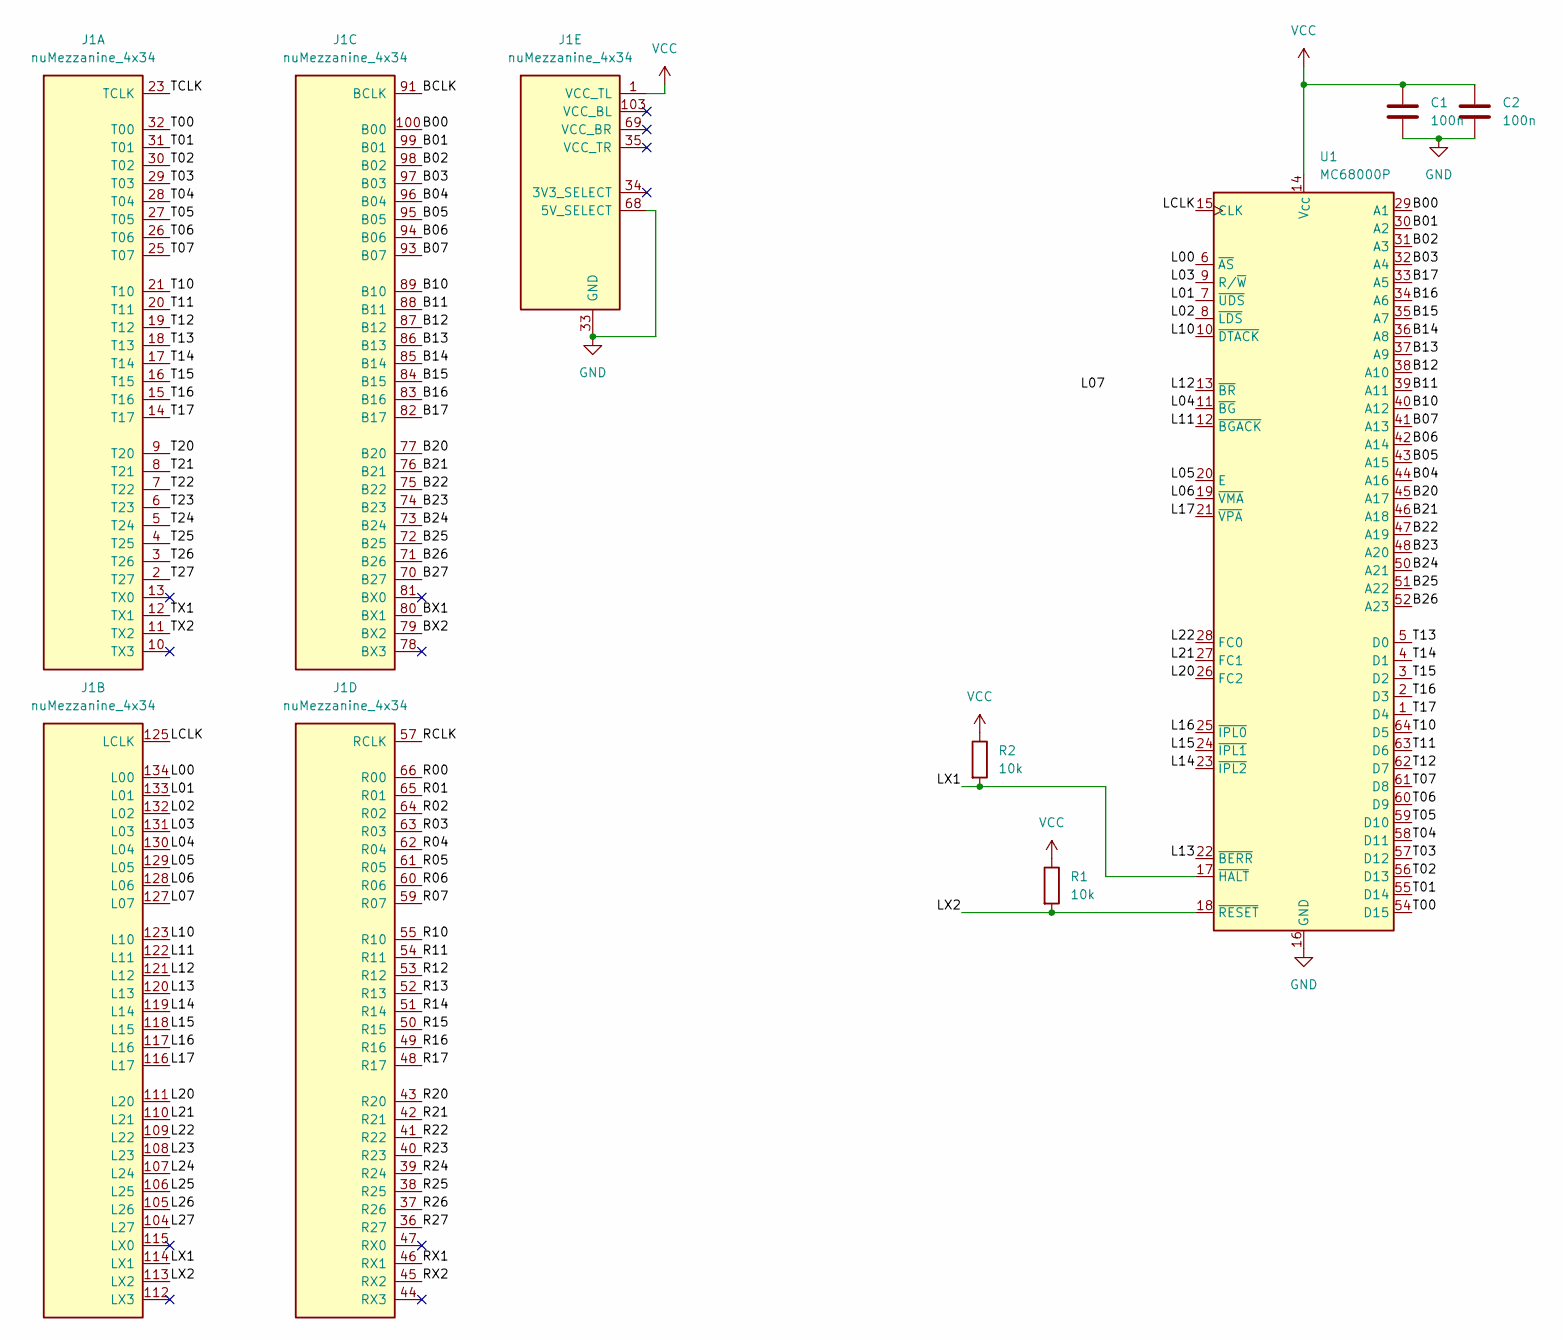
[picture p37: schematic 68000.kicad_sch]

Parts:
C1, C2: 100n; C_0805_2012Metric_Pad1.18x1.45mm_HandSolder
J1: nuMezzanine_4x34; nuMezzanine_4x34_P2.54mm
R1, R2: 10k; R_0805_2012Metric_Pad1.20x1.40mm_HandSolder
U1: MC68000P; DIP-64_W22.86mm

Connections:
/B00: J1.100 (B00_100), U1.29 (A1)
/B01: J1.99 (B01_99), U1.30 (A2)
/B02: J1.98 (B02_98), U1.31 (A3)
/B03: J1.97 (B03_97), U1.32 (A4)
/B04: J1.96 (B04_96), U1.44 (A16)
/B05: J1.95 (B05_95), U1.43 (A15)
/B06: J1.94 (B06_94), U1.42 (A14)
/B07: J1.93 (B07_93), U1.41 (A13)
/B10: J1.89 (B10_89), U1.40 (A12)
/B11: J1.88 (B11_88), U1.39 (A11)
/B12: J1.87 (B12_87), U1.38 (A10)
/B13: J1.86 (B13_86), U1.37 (A9)
/B14: J1.85 (B14_85), U1.36 (A8)
/B15: J1.84 (B15_84), U1.35 (A7)
/B16: J1.83 (B16_83), U1.34 (A6)
/B17: J1.82 (B17_82), U1.33 (A5)
/B20: J1.77 (B20_77), U1.45 (A17)
/B21: J1.76 (B21_76), U1.46 (A18)
/B22: J1.75 (B22_75), U1.47 (A19)
/B23: J1.74 (B23_74), U1.48 (A20)
/B24: J1.73 (B24_73), U1.50 (A21)
/B25: J1.72 (B25_72), U1.51 (A22)
/B26: J1.71 (B26_71), U1.52 (A23)
/B27: J1.70 (B27_70)
/BCLK: J1.91 (BCLK_91)
/BX1: J1.80 (BX1_80)
/BX2: J1.79 (BX2_79)
/L00: J1.134 (L00_134), U1.6 (~AS)
/L01: J1.133 (L01_133), U1.7 (~UDS)
/L02: J1.132 (L02_132), U1.8 (~LDS)
/L03: J1.131 (L03_131), U1.9 (R/~W)
/L04: J1.130 (L04_130), U1.11 (~BG)
/L05: J1.129 (L05_129), U1.20 (E)
/L06: J1.128 (L06_128), U1.19 (~VMA)
/L07: J1.127 (L07_127)
/L10: J1.123 (L10_123), U1.10 (~DTACK)
/L11: J1.122 (L11_122), U1.12 (~BGACK)
/L12: J1.121 (L12_121), U1.13 (~BR)
/L13: J1.120 (L13_120), U1.22 (~BERR)
/L14: J1.119 (L14_119), U1.23 (~IPL2)
/L15: J1.118 (L15_118), U1.24 (~IPL1)
/L16: J1.117 (L16_117), U1.25 (~IPL0)
/L17: J1.116 (L17_116), U1.21 (~VPA)
/L20: J1.111 (L20_111), U1.26 (FC2)
/L21: J1.110 (L21_110), U1.27 (FC1)
/L22: J1.109 (L22_109), U1.28 (FC0)
/L23: J1.108 (L23_108)
/L24: J1.107 (L24_107)
/L25: J1.106 (L25_106)
/L26: J1.105 (L26_105)
/L27: J1.104 (L27_104)
/LCLK: J1.125 (LCLK_125), U1.15 (CLK)
/LX1: J1.114 (LX1_114), R2.2, U1.17 (~HALT)
/LX2: J1.113 (LX2_113), R1.2, U1.18 (~RESET)
/R00: J1.66 (R00_66)
/R01: J1.65 (R01_65)
/R02: J1.64 (R02_64)
/R03: J1.63 (R03_63)
/R04: J1.62 (R04_62)
/R05: J1.61 (R05_61)
/R06: J1.60 (R06_60)
/R07: J1.59 (R07_59)
/R10: J1.55 (R10_55)
/R11: J1.54 (R11_54)
/R12: J1.53 (R12_53)
/R13: J1.52 (R13_52)
/R14: J1.51 (R14_51)
/R15: J1.50 (R15_50)
/R16: J1.49 (R16_49)
/R17: J1.48 (R17_48)
/R20: J1.43 (R20_43)
/R21: J1.42 (R21_42)
/R22: J1.41 (R22_41)
/R23: J1.40 (R23_40)
/R24: J1.39 (R24_39)
/R25: J1.38 (R25_38)
/R26: J1.37 (R26_37)
/R27: J1.36 (R27_36)
/RCLK: J1.57 (RCLK_57)
/RX1: J1.46 (RX1_46)
/RX2: J1.45 (RX2_45)
/T00: J1.32 (T00_32), U1.54 (D15)
/T01: J1.31 (T01_31), U1.55 (D14)
/T02: J1.30 (T02_30), U1.56 (D13)
/T03: J1.29 (T03_29), U1.57 (D12)
/T04: J1.28 (T04_28), U1.58 (D11)
/T05: J1.27 (T05_27), U1.59 (D10)
/T06: J1.26 (T06_26), U1.60 (D9)
/T07: J1.25 (T07_25), U1.61 (D8)
/T10: J1.21 (T10_21), U1.64 (D5)
/T11: J1.20 (T11_20), U1.63 (D6)
/T12: J1.19 (T12_19), U1.62 (D7)
/T13: J1.18 (T13_18), U1.5 (D0)
/T14: J1.17 (T14_17), U1.4 (D1)
/T15: J1.16 (T15_16), U1.3 (D2)
/T16: J1.15 (T16_15), U1.2 (D3)
/T17: J1.14 (T17_14), U1.1 (D4)
/T20: J1.9 (T20_9)
/T21: J1.8 (T21_8)
/T22: J1.7 (T22_7)
/T23: J1.6 (T23_6)
/T24: J1.5 (T24_5)
/T25: J1.4 (T25_4)
/T26: J1.3 (T26_3)
/T27: J1.2 (T27_2)
/TCLK: J1.23 (TCLK_23)
/TX1: J1.12 (TX1_12)
/TX2: J1.11 (TX2_11)
GND: C1.2, C2.2, J1.22 (GND_22), J1.24 (GND_24), J1.33 (GND_33), J1.56 (GND_56), J1.58 (GND_58), J1.67 (GND_67), J1.68 (5V_SELECT_68), J1.90 (GND_90), J1.92 (GND_92), J1.101 (GND_101), J1.102 (GND), J1.124 (GND_124), J1.126 (GND_126), J1.135 (GND_135), J1.136 (GND), U1.16 (GND), U1.53 (GND)
VCC: C1.1, C2.1, J1.1 (VCC_TL_1), R1.1, R2.1, U1.14 (V_{CC}), U1.49 (V_{CC})

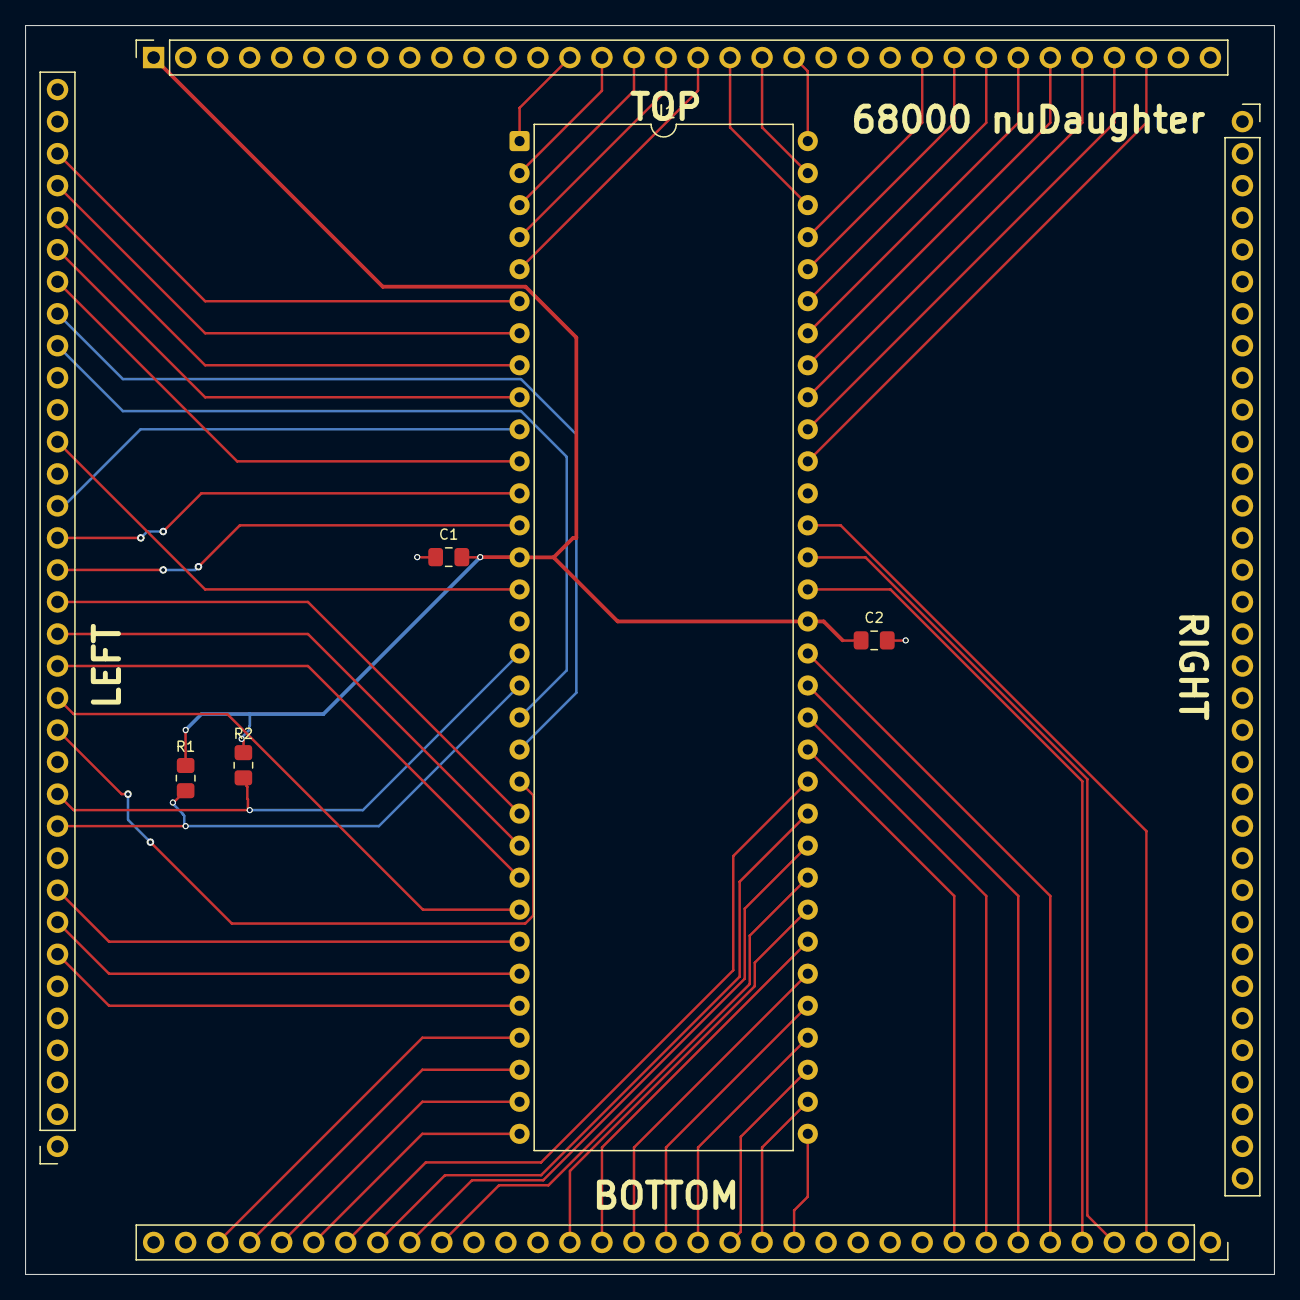
[picture p38: board 68000.kicad_pcb from above]

Board: 2 copper layers, 99.1 x 99.1 mm, 6 parts (0 on the bottom side), 62 nets.
