wickerwaka/nuBoard/hardware/main-board/nuBoard.kicad_blocks/Clock Buffer.kicad_block/Clock Buffer.kicad_pcb

## KiCad design hardware/main-board/nuBoard.kicad_blocks/Clock Buffer.kicad_block/Clock Buffer.kicad_pcb (2026-09-13)

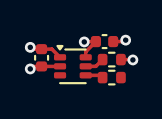
[picture p39: board Clock Buffer.kicad_pcb from above]

Board: 6 copper layers, 5 parts (0 on the bottom side), 5 nets.

Parts:
C211, C212: 0.1u; C_0402_1005Metric
R57: 10K; R_0402_1005Metric
R58: 22; R_0402_1005Metric
U20: SN74LVC1T45DRL; SOT-563

Connections:
+3.3V: C211.1, U20.1 (VCCA)
/F_TCLK_EN: R57.1, U20.5 (DIR)
GND: C211.2, C212.2, R57.2, U20.2 (GND)
unnamed: R58.1, U20.4 (B)
VCCB: C212.1, U20.6 (VCCB)
