wickerwaka/nuBoard/hardware/main-board/nuBoard.kicad_blocks/Buffer.kicad_block/Buffer.kicad_pcb

## KiCad design hardware/main-board/nuBoard.kicad_blocks/Buffer.kicad_block/Buffer.kicad_pcb (2026-09-13)

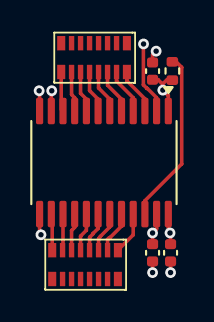
[picture p40: board Buffer.kicad_pcb from above]

Board: 8 copper layers, 7 parts (0 on the bottom side), 20 nets.

Parts:
C68, C69, C70: 0.1u; C_0402_1005Metric
R35: 10K; R_0402_1005Metric
RN23, RN24: 22R; YC248-JR-0722RL
U24: SN74LVCH8T245PWR; TSSOP-24_4.4x7.8mm_P0.65mm

Connections:
+3.3V: C68.1, R35.1, U24.1 (VCCA)
/~F_B0_OE: R35.2, U24.22 (~OE)
GND: C68.2, C69.2, C70.2, U24.11 (GND), U24.12 (GND), U24.13 (GND)
unnamed: RN23.16, U24.3 (A1)
unnamed: RN23.15, U24.4 (A2)
unnamed: RN23.14, U24.5 (A3)
unnamed: RN23.13, U24.6 (A4)
unnamed: RN23.12, U24.7 (A5)
unnamed: RN23.11, U24.8 (A6)
unnamed: RN23.10, U24.9 (A7)
unnamed: RN23.9, U24.10 (A8)
unnamed: RN24.1, U24.21 (B1)
unnamed: RN24.2, U24.20 (B2)
unnamed: RN24.3, U24.19 (B3)
unnamed: RN24.4, U24.18 (B4)
unnamed: RN24.5, U24.17 (B5)
unnamed: RN24.6, U24.16 (B6)
unnamed: RN24.7, U24.15 (B7)
unnamed: RN24.8, U24.14 (B8)
VCCB: C69.1, C70.1, U24.23 (VCCB), U24.24 (VCCB)
