wickerwaka/nuBoard/hardware/main-board/nuBoard.kicad_blocks/Output LED.kicad_block/Output LED.kicad_pcb

## KiCad design hardware/main-board/nuBoard.kicad_blocks/Output LED.kicad_block/Output LED.kicad_pcb (2026-09-13)

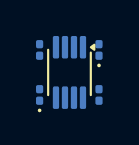
[picture p41: board Output LED.kicad_pcb from below]

Board: 6 copper layers, 5 parts (5 on the bottom side), 5 nets, no tracks yet.

Parts:
C90: 0.1u; C_0201_0603Metric
D17, D18: LED; LED_0201_0603Metric
R71: 10K; R_0201_0603Metric
U35: 74LVC1G139; VSSOP-8_2.3x2mm_P0.5mm

Connections:
+3.3V: C90.1, R71.2, U35.8 (VCC)
GND: C90.2, U35.4 (GND)
unnamed: D17.2 (A), D18.2 (A), R71.1
unnamed: D17.1 (K), U35.7 (Y0)
unnamed: D18.1 (K), U35.6 (Y1)
