wickerwaka/nuBoard/mcu/src/tusb_config.h

#ifndef NUBOARD_TUSB_CONFIG_H
#define NUBOARD_TUSB_CONFIG_H

#define CFG_TUSB_MCU OPT_MCU_RP2040
#define CFG_TUSB_OS OPT_OS_PICO
#define CFG_TUSB_RHPORT0_MODE OPT_MODE_DEVICE
#define CFG_TUD_ENDPOINT0_SIZE 64
#define CFG_TUD_CDC 1
#define CFG_TUD_VENDOR 1
#define CFG_TUD_CDC_RX_BUFSIZE 128
#define CFG_TUD_CDC_TX_BUFSIZE 512
#define CFG_TUD_CDC_EP_BUFSIZE 64
#define CFG_TUD_VENDOR_RX_BUFSIZE 8192
#define CFG_TUD_VENDOR_TX_BUFSIZE 8192
#define CFG_TUD_VENDOR_EPSIZE 64

#endif
