wickerwaka/nuBoard/(commit log)

2026-09-13 Import nuBoard hardware as standalone KiCad projects
2026-09-16 Add daughter boards and RP2040 firmware
2026-09-26 Integrate matched top-layer HyperRAM layout and pin assignments
2026-10-10 Update mainboard to revision 2
    Add an additional 8 bidirectional channels
    Replace SPI PSRAM with hyperram
    Remove LEDs
2026-10-10 Add 68000 differential harness with BRAM waveform capture
    Add generic interrupt-driven host debug exchanges, fx68k and socket CPU harnesses, timing comparisons, and stress tests.
    Use a 32768-record BRAM capture buffer with non-destructive readback and explicit capacity stops. Preserve CPU timing and immediate buffer direction; keep PSRAM inactive in the active harness.
    Include build qualification, regression tests, historical measurements, and reproduction documentation.
2026-10-10 Add 68000 differential campaigns, fuzzing, and input timing probes
    Optimize debug transfers and add reproducible physical, FPGA, and simulation comparisons. Record campaign qualification, retained timing failures, fuzz coverage, and the BR sampling-stage mismatch. Include tests, documentation, and timing diagrams.
2026-10-12 Build FPGA images in an Apple Container and match rev 2 pins
    Add tools/efinity: a container image built from the Efinity Linux release
    and patch, plus efinity-run, which the build scripts and fpga/Makefile use
    when there is no native install.
    Update the template and heartbeat pin assignments for the revision 2
    board. Remove PSRAM support and led_test, hold the HyperRAM deselected,
    and replace the template's demo with a one-stage stream echo.
    Claude-Session: https://claude.ai/code/session_01Mb721YdebqpSQrfvW2MyND
2026-10-12 Add an FPGA supply rail test build option
    NUBOARD_RAIL_TEST=1v2 or both powers the FPGA rails at boot without
    configuring the FPGA, for checking the converters on the bench.
    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
2026-10-12 Fit power inductors for the FPGA buck converters
    L1 and L2 used C16903, a ferrite bead, which made U6 and U7 whine and
    damaged U6. Switch to C964122 in a 1008 footprint. Note that the
    HyperRAM is held deselected until it is supported.
    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
2026-10-12 Add buffered HyperRAM trace controller to the template
    The HyperRAM runs from its own PLL (PLL_TR1, referenced from A18) with
    DDIO I/O cells, a build-time capture phase, and read capture driven by
    the RWDS strobe pattern. Transfers are fixed, burst-aligned bursts
    staged through four dual-clock buffers, with command and done queues on
    the producer side; the producer clock and width are configurable.
    On hardware the full 8 MB passes every pattern; at 150 MHz with
    512-word bursts it sustains 284 MB/s writes and 283 MB/s reads.
    The template application answers HyperRAM test commands on mailbox
    channel 1 and echoes other channels. The host gains `nuboard hyperram`,
    build.sh builds per frequency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
